RobbeElsermans/SSR/Portfolio/SSR_Portfolio/Pages/Sensor/LTR-329.md

```C
 
```
![[Lite-On_LTR-329ALS-01 DS_ver1.1-348647.pdf]]
![Brain_main_code_diagram](../../Images/diagrams/Brain_main_code_diagram.png

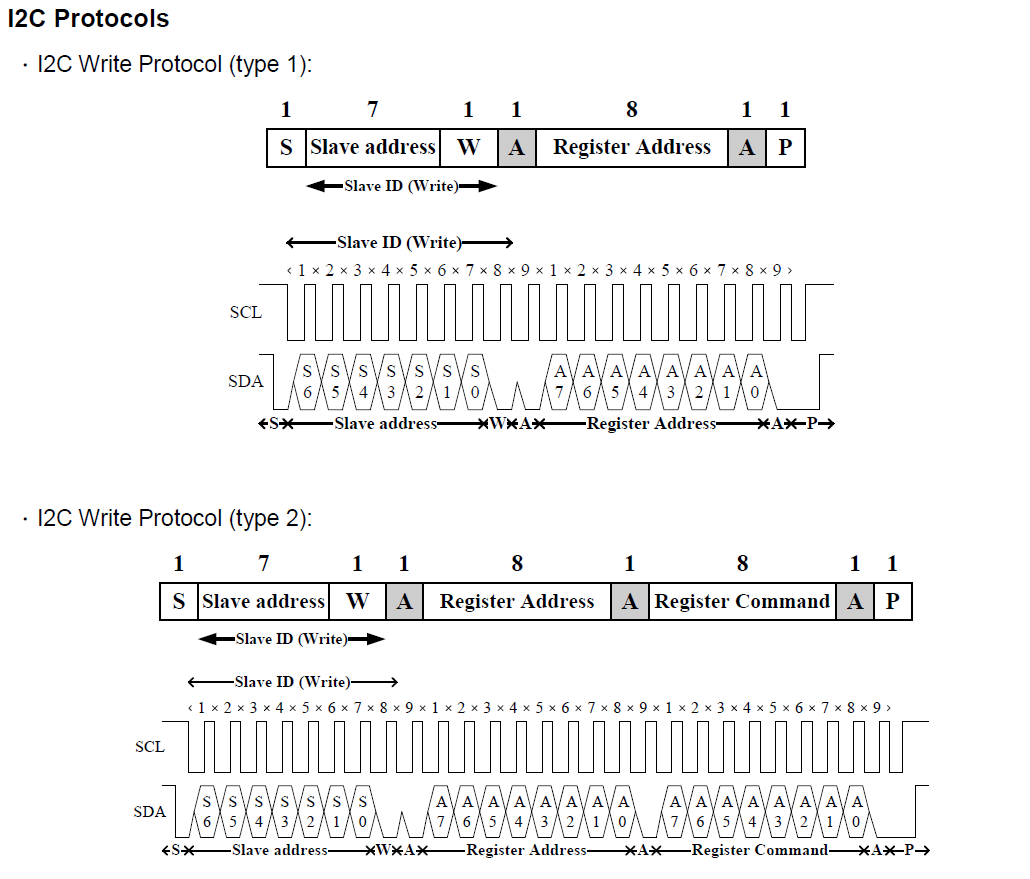
[picture p2: Portfolio/SSR_Portfolio/Images/Sensors/I2CPROTOCOL1.png]
I2CPROTOCOL1

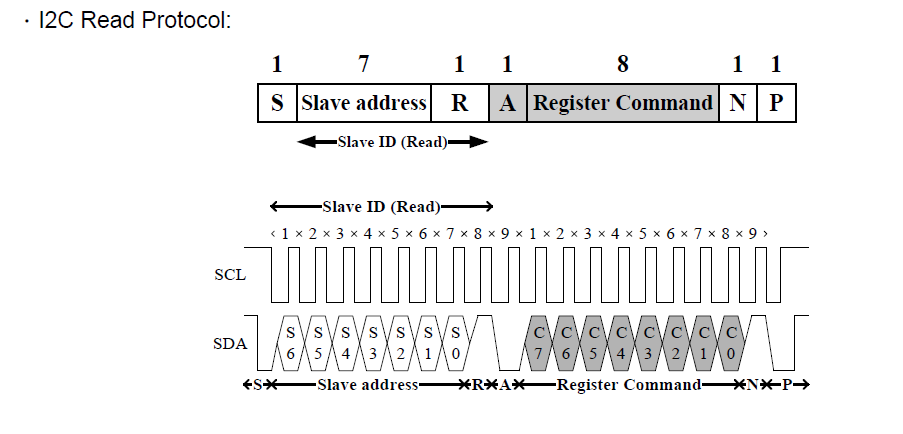
[picture p3: Portfolio/SSR_Portfolio/Images/Sensors/I2CEADPROTOCOL.png]
I2CEADPROTOCOL

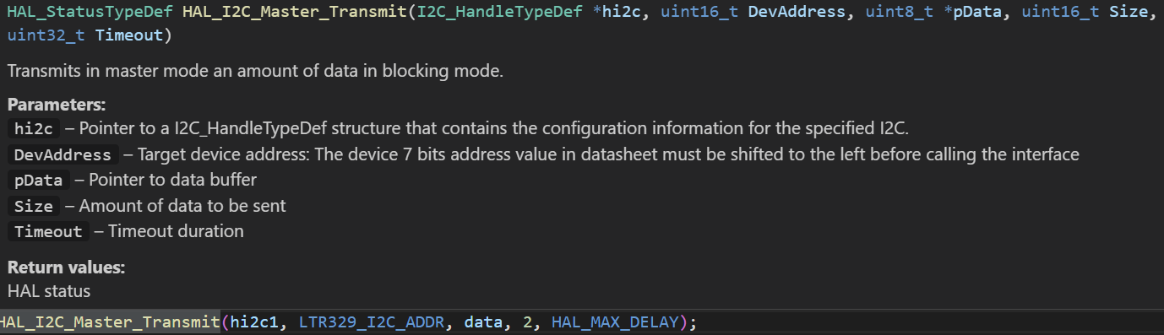
[picture p4: Portfolio/SSR_Portfolio/Images/Sensors/MasterTransmit.png]
MasterTransmit

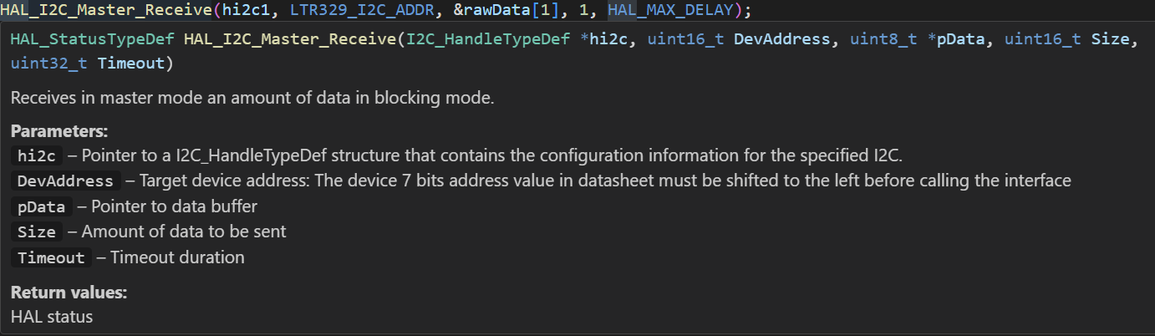
[picture p5: Portfolio/SSR_Portfolio/Images/Sensors/MasterRecive.png]
MasterRecive

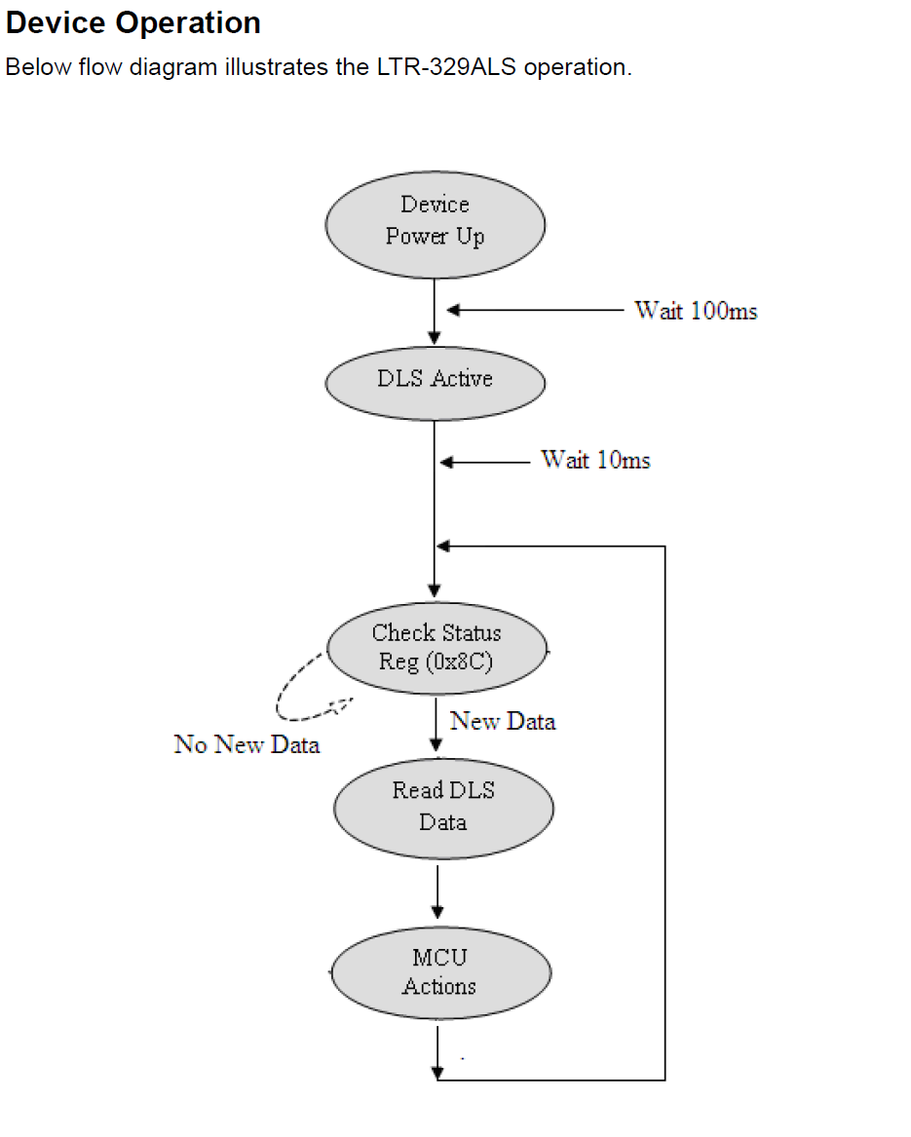
[picture p6: Portfolio/SSR_Portfolio/Images/Sensors/DEVICEOPERATION.png]
DEVICEOPERATION


Sleepmode:
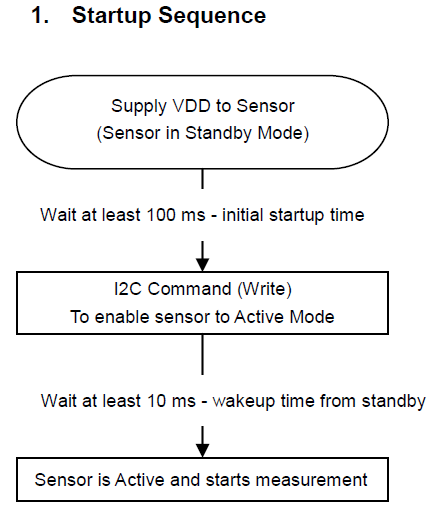
[picture p7: Portfolio/SSR_Portfolio/Images/Sensors/Startupsequence1.png]
Startupsequence1


### . **How It Works**

1. **Active State**:
    
    - The sensor reads ambient light data and transmits it via I2C
    - The LED (`LD3_Pin`) is turned on to indicate the active state.
2. **Sleep State**:
    
    - The `LTR329_Sleep` function puts the sensor into standby mode.
    - The LED is turned off to indicate the sleep state.
    - The system waits for 5 seconds (or your preferred duration).
3. **Wake-Up State**:
    
    - The `LTR329_WakeUp` function sets the sensor back to active mode.
    - A delay is added after wake-up to allow the sensor to stabilize before the next reading.

according to datasheet: 
standby current: 5 $micro$A
initial startup: 100 ms
waking up: 10 ms 

```C
while (1)

  {

    HAL_GPIO_WritePin(LD3_GPIO_Port, LD3_Pin, GPIO_PIN_SET);

    HAL_Delay(1000);

    HAL_GPIO_WritePin(LD3_GPIO_Port, LD3_Pin, GPIO_PIN_RESET);

    char Buffer[25] = {0};

    sprintf(Buffer, "Lux: ! %d\r\n", GetLuxAll(&hi2c1));

    HAL_UART_Transmit(&huart2, Buffer, sizeof(Buffer), HAL_MAX_DELAY);

    HAL_Delay(500); // Delay for the next measurement

    HAL_GPIO_WritePin(LD3_GPIO_Port, LD3_Pin, GPIO_PIN_RESET); // LED off (indicate sleep)

    LTR329_Sleep(&hi2c1);

    LTR329_Sleep(&hi2c1);

     // Delay to keep the sensor in sleep mode

    HAL_Delay(5000); // Sleep for 5 seconds

    // Wake up the sensor

    HAL_GPIO_WritePin(LD3_GPIO_Port, LD3_Pin, GPIO_PIN_SET); // LED on (indicate wake-up)

    LTR329_WakeUp(&hi2c1);

     // Wait for sensor stabilization after wake-up

    HAL_Delay(200); // Adjust based on sensor's requirements

  }

}
```

```C
void LTR329_Sleep(I2C_HandleTypeDef* hi2c1) {

    uint8_t data[2];

    // Write to ALS_CONTR register to set the sensor in standby mode (0x00).

    data[0] = LTR329_ALS_CONTR;

    data[1] = 0x00; // Standby mode

    HAL_I2C_Master_Transmit(hi2c1, LTR329_I2C_ADDR, data, 2, HAL_MAX_DELAY);

    HAL_Delay(10);

}

void LTR329_WakeUp(I2C_HandleTypeDef* hi2c1) {

    uint8_t data[2];

    // Write to ALS_CONTR register to set the sensor in active mode.

    data[0] = LTR329_ALS_CONTR;

    data[1] = 0x01; // Active mode with default gain

    HAL_I2C_Master_Transmit(hi2c1, LTR329_I2C_ADDR, data, 2, HAL_MAX_DELAY);

    // Wait for the sensor to wake up.

    HAL_Delay(10); // According to the sensor datasheet

}
```
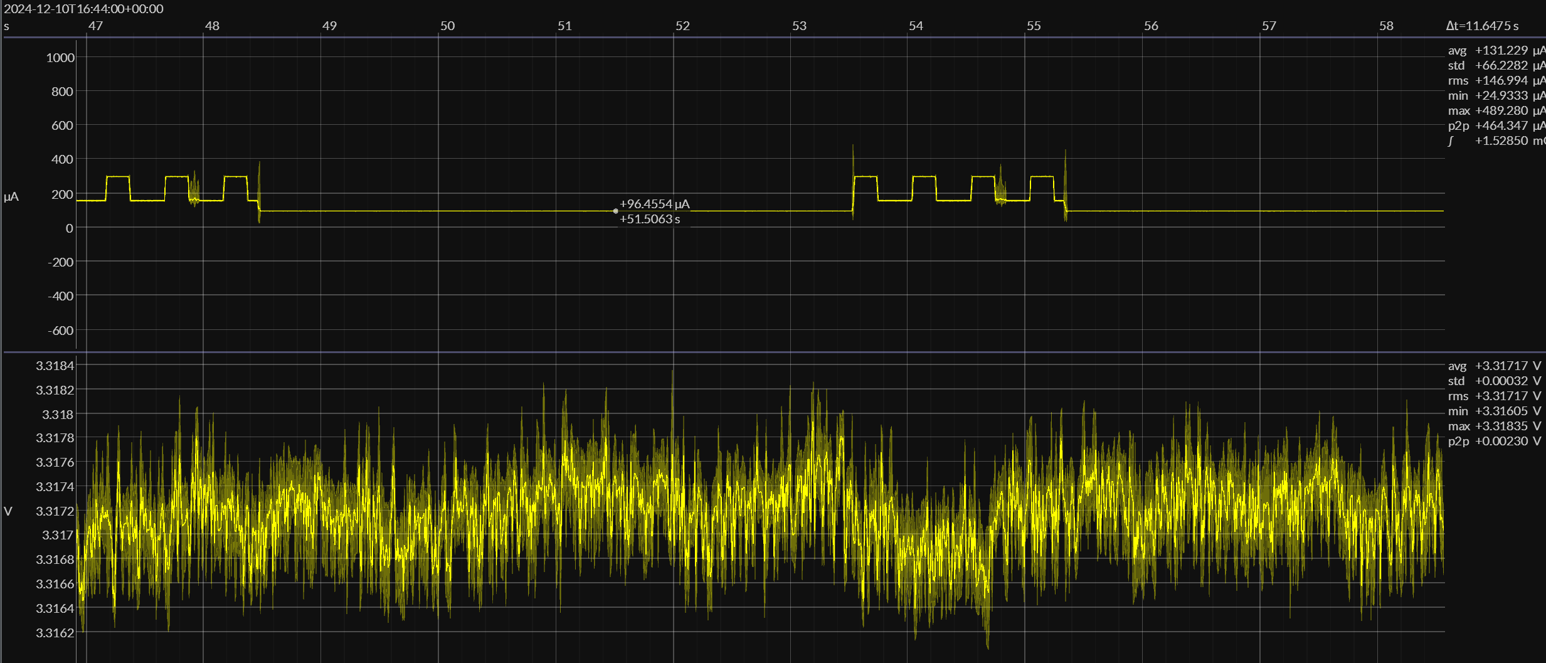
[picture p8: Portfolio/SSR_Portfolio/Images/Power_Profiling/StandbyModeLTR329.png]
Stanby Mode LTR329

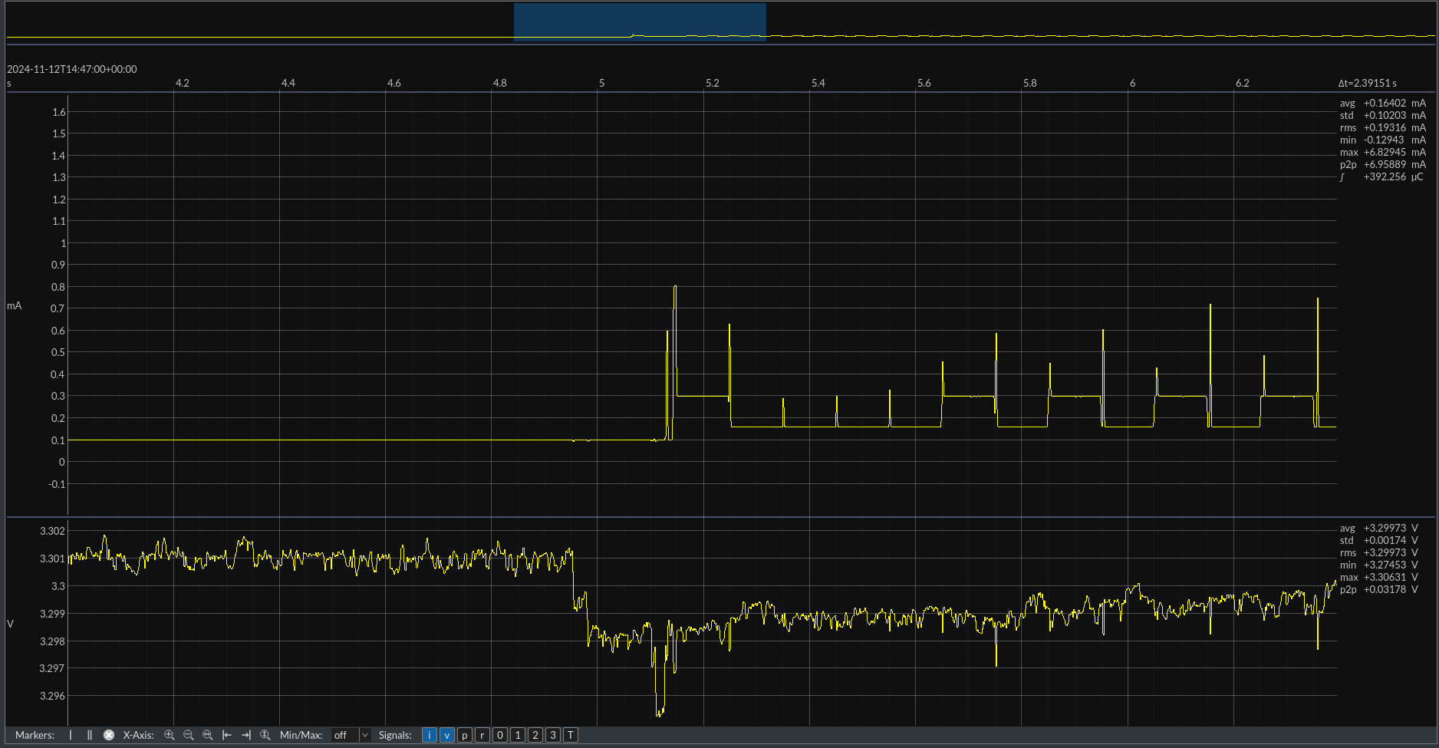
[picture p9: Portfolio/SSR_Portfolio/Images/Power_Profiling/ltr_329_consumption.png]
ltr_329_consumption


For reasons unknown Standby mode draws 96 microAmpers insted od promised 5microAmpers
Maesuring peak: 300microAmpers
SemiPeak : 157microAmpers
