RobbeElsermans/SSR/Portfolio/SSR_Portfolio/Pages/LoRa/TheThingsNetwork.md

# Account creation
Go to [TheThingsNetwork website](https://www.thethingsnetwork.org/) and click the Sign Up button:

ttn sign up

Scroll down and click the *"Join the things network"* button:

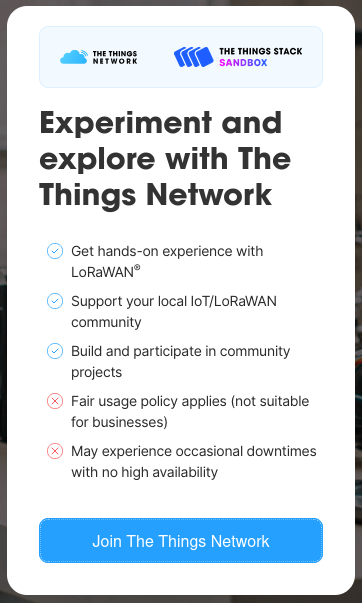
[picture p72: Portfolio/SSR_Portfolio/Images/LoRa/ttn_join.png]
ttn join up


Click the *"Sign in for free"*:

ttn sign up

Create and account:

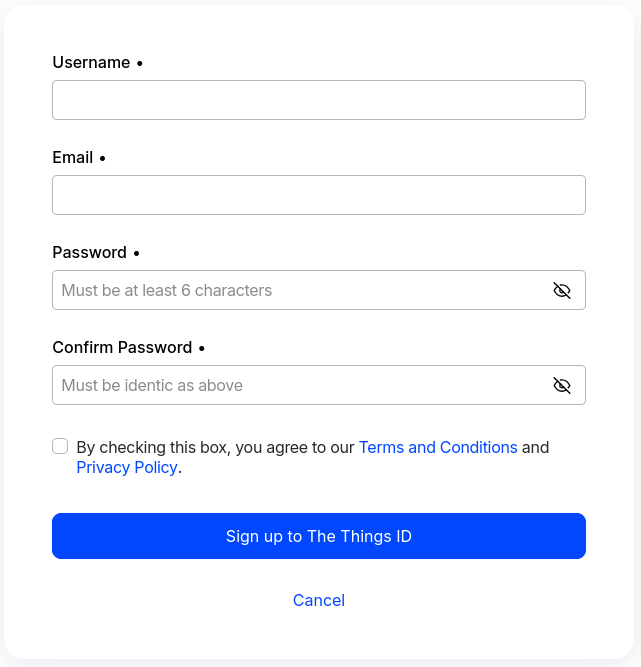
[picture p73: Portfolio/SSR_Portfolio/Images/LoRa/ttn_create_account.png]
ttn create account


After creating and verifying your account, log in:

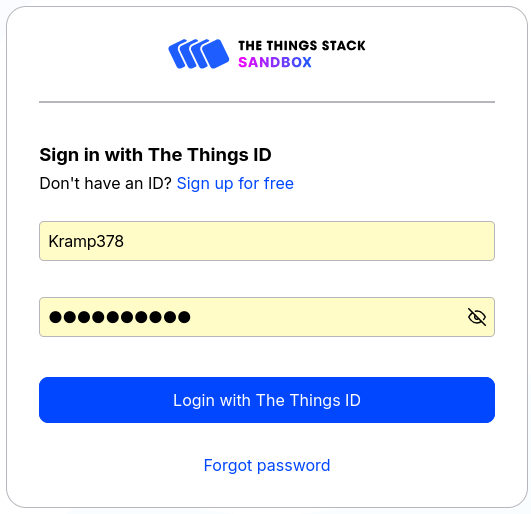
[picture p74: Portfolio/SSR_Portfolio/Images/LoRa/ttn_login.png]
ttn login


# Open the console
Click on the console button:

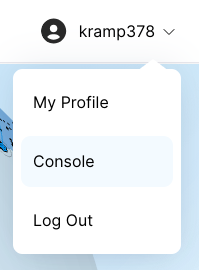
[picture p75: Portfolio/SSR_Portfolio/Images/LoRa/ttn_console.png]
ttn console


Select the closest cluster available *(Ireland)*:

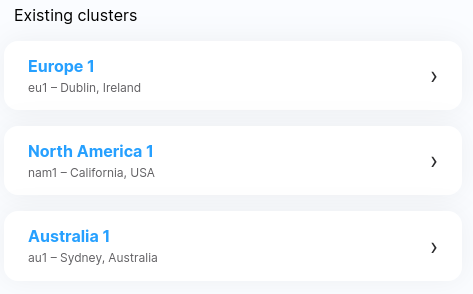
[picture p76: Portfolio/SSR_Portfolio/Images/LoRa/ttn_cluster.png]
ttn cluster


You should see the following interface:

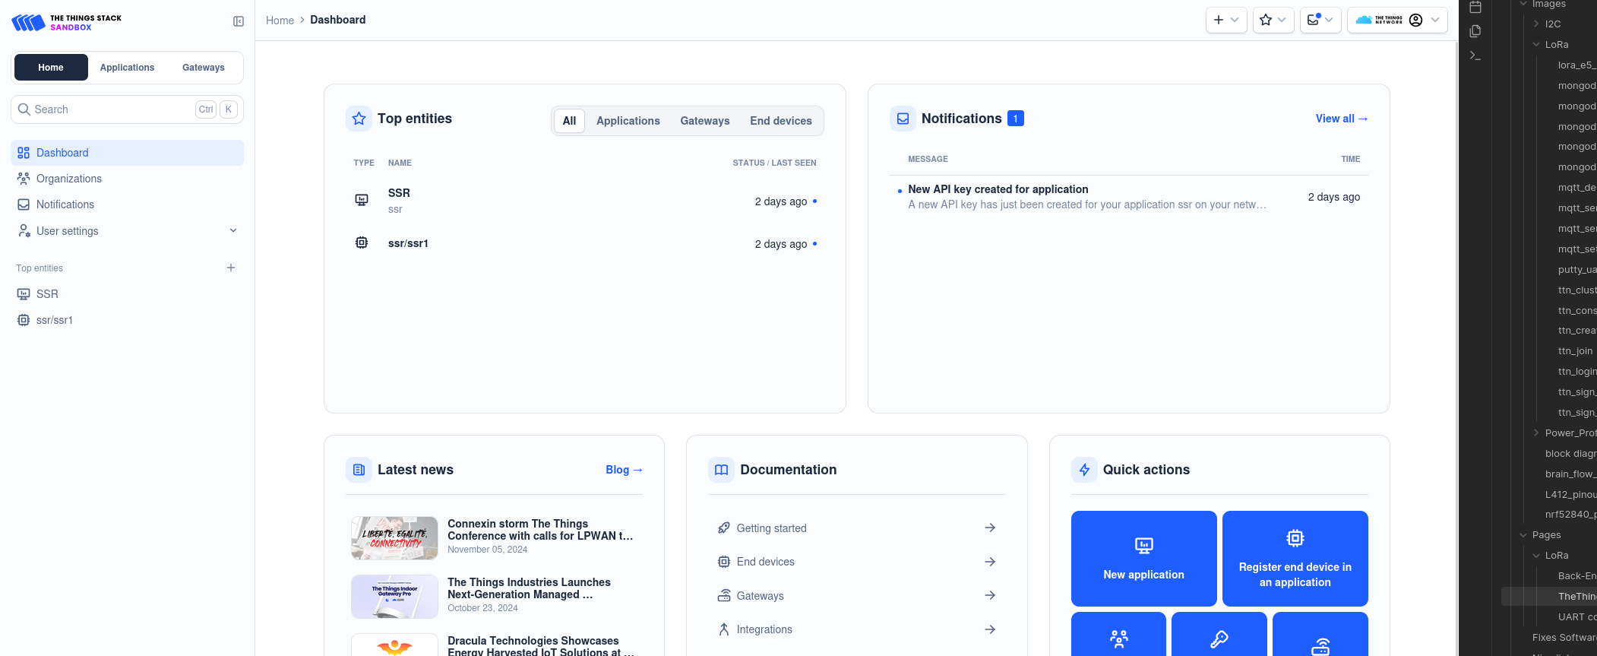
[picture p77: Portfolio/SSR_Portfolio/Images/LoRa/ttn_console_interface.png]
ttn console interface


# Connect device
## Create an application
Hover over the plus sign and click on ""Add application":

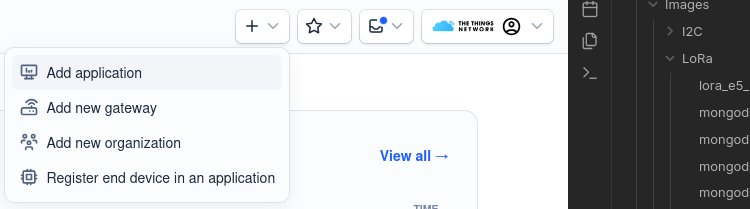
[picture p78: Portfolio/SSR_Portfolio/Images/LoRa/ttn_create_application.png]
ttn create application


Use the following settings to create an application:

ttn application settings

## Add a device
Under the "End devices" tab, click op the "Register end device" button:

ttn register device

Use the following settings to register an end device:
- DevEUI should be provided by the device. Use the device value.
- Device address, AppSKey & NwkSKey should be generated and then configured onto the end device.

ttn end device type

ttn advanced activation settings

ttn provisioning information

### Create a MQTT network connection
Click on the left, onto the "Intigrations" tab and afterwards on the "MQTT" sub-tab.
The following settings can be used to subscribe onto MQTT messages of this end device.
*Note that the password needs to be generated.*

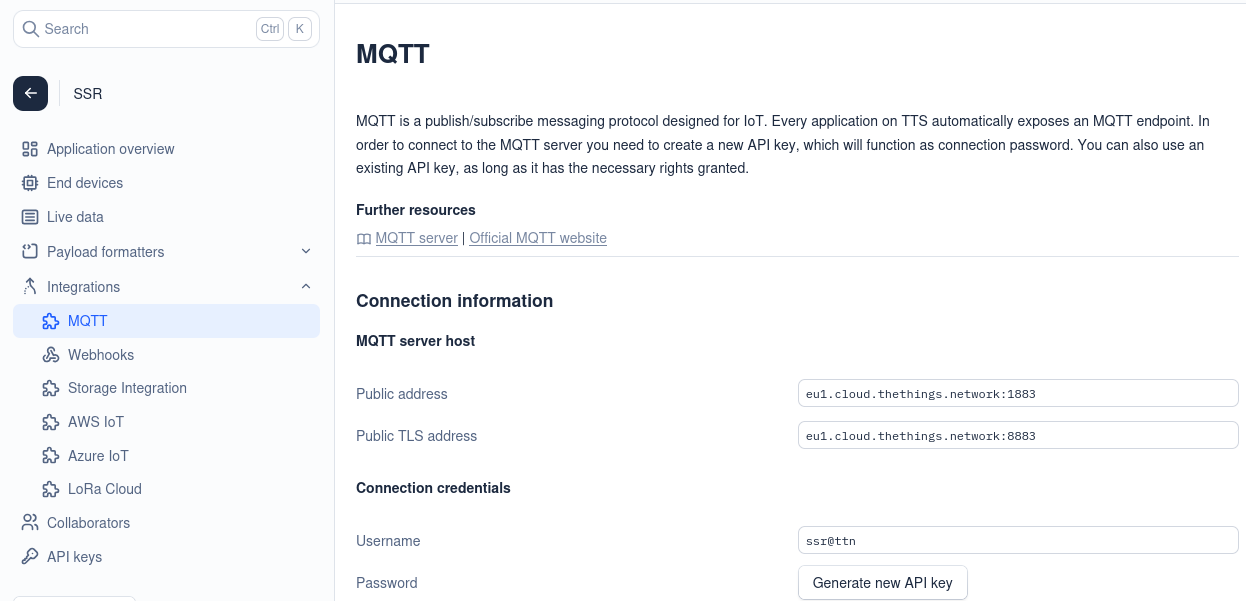
[picture p79: Portfolio/SSR_Portfolio/Images/LoRa/ttn_mqtt_network_settings.png]
ttn mqtt network settings
