RobbeElsermans/SSR/STM32/README_VENV.md

Please, in order to convert a generated .ioc file of STM32, use the virtual environment by

```
pwd = /SSR/STM32
source /venv/bin/activate
```

```
pip install stm2pio
python3 -m pip install -U platformio
```
use **stm32pio init** to generate the platformio project from an .ioc file generated by CubeMX.
```
stm32pio init
```
add the device name in the .ini file e.i. **nucleo_l412kb**
```
stm32pio generate
```
Please note that teh error about GPDSC, doesn't matter
See -> https://github.com/ussserrr/stm32pio/issues/114

In order to regenerate the changed .ioc through cubeMX and link it to platformio
For this, the inline commentary may not be changed.
```
stm32pio generate
```

and to deactivate the env
```
deactivate
```

For advanced stuff like MiddleWare applications such as FreeRTOS or any other thing, not done yet.
See below for further investigation
- https://wiki-power.com/en/PlatformIO%E6%90%AD%E9%85%8DCubeMX%E9%A3%9F%E7%94%A8/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 
- https://community.platformio.org/t/stm32cubemx-and-platformio/38378/3
- https://community.platformio.org/t/minimal-ststm32-freertos-example/37229/3
- https://github.com/platformio/platform-ststm32/tree/master/examples/zephyr-blink/zephyr
- 

sources:
- https://python.land/virtual-environments/virtualenv
- https://github.com/ussserrr/stm32pio
- https://github.com/maxgerhardt/pio-stm32h7-stm32cube-freertos
- https://community.platformio.org/t/platformio-freertos/23554/6
