RobbeElsermans/SSR/Portfolio/PPT/SSR_Final.pdf

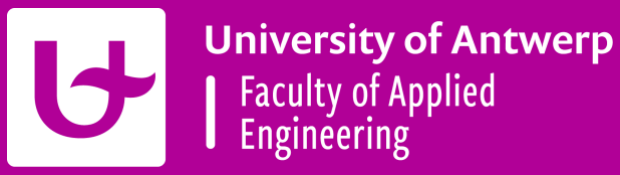
[picture p84: figure]

# Simple Stupid Rover

## Robbe Elsermans, Adam Hejduk, Thomas Kramp

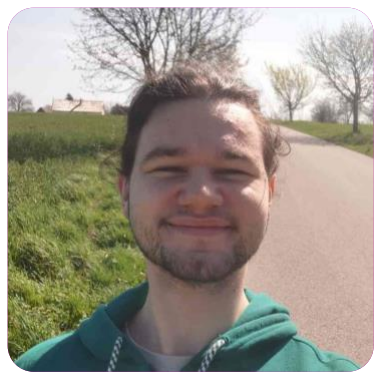
[picture p85: figure]
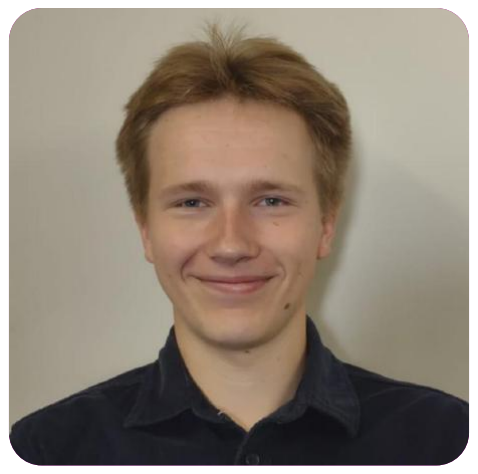
[picture p86: figure]
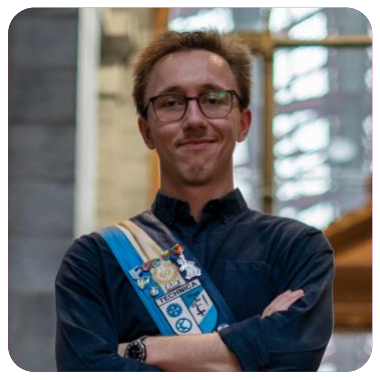
[picture p87: figure]

Adam Hejduk | Robbe Elsermans | Thomas Kramp
- Environmental Sensing • Energy harvesting • Energy output management • Soldering man | • Project Manager • Energy Awareness • BLE intercommunication • Power Profiling | • Gyroscope • LineBot
- LoRa
| | • Dashboard

# Concept

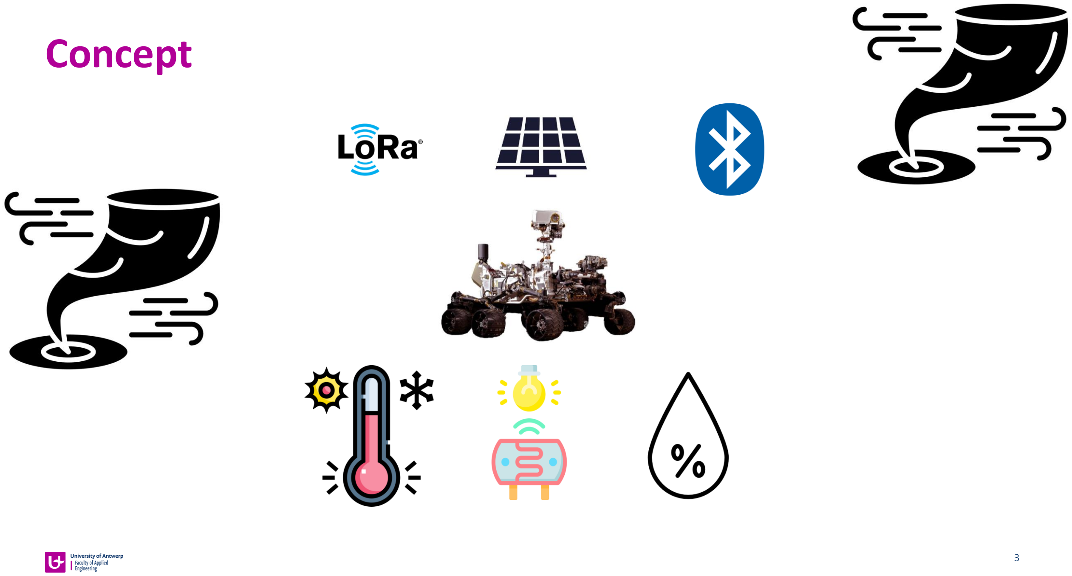
[picture p88: page 3]

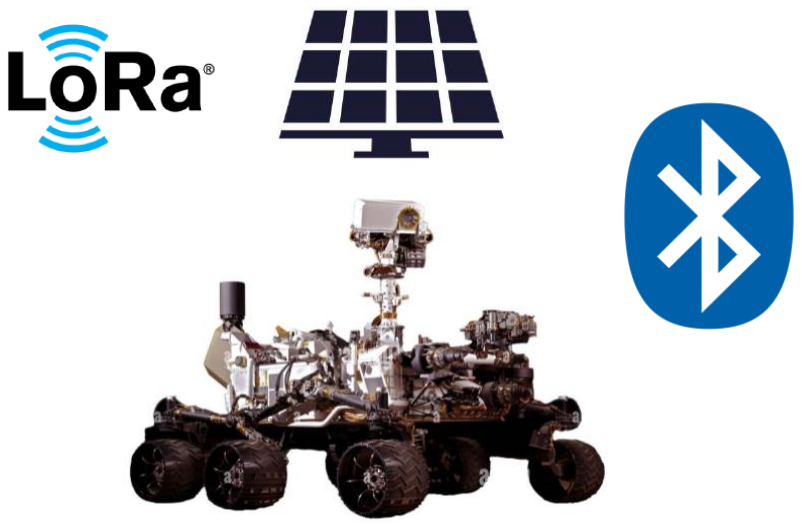
[picture p89: figure]

# Concept

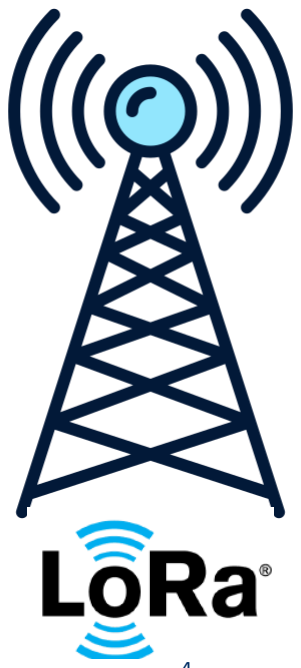
[picture p90: figure]

# Concept

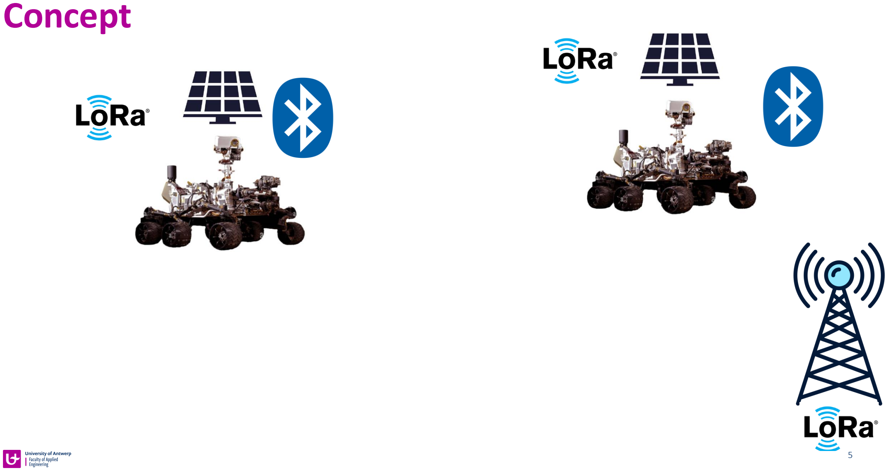
[picture p91: page 5]

# Concept

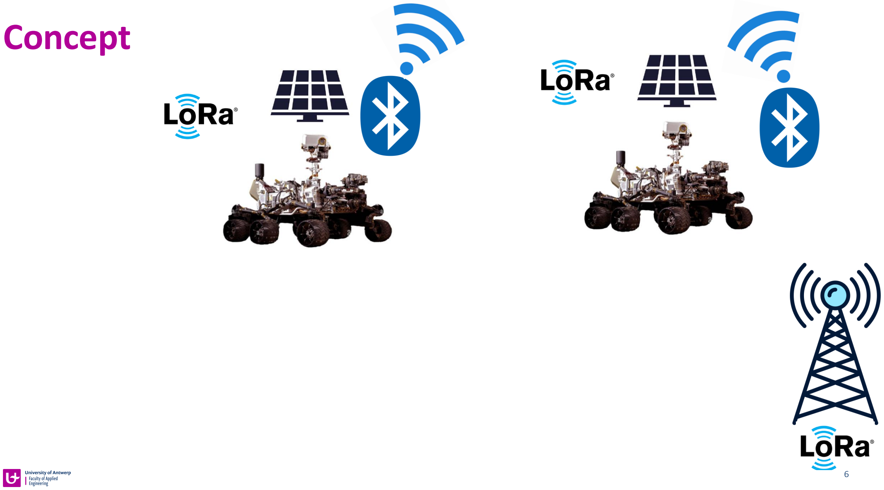
[picture p92: page 6]

# Concept

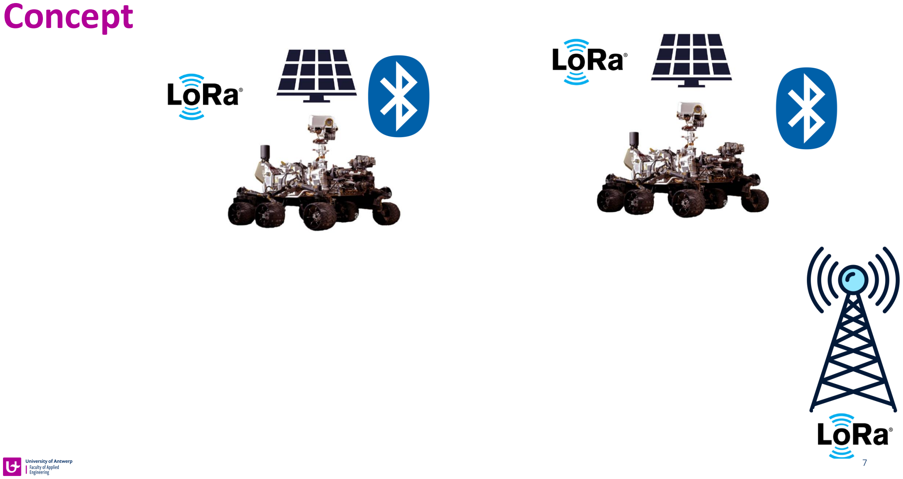
[picture p93: page 7]

# Concept

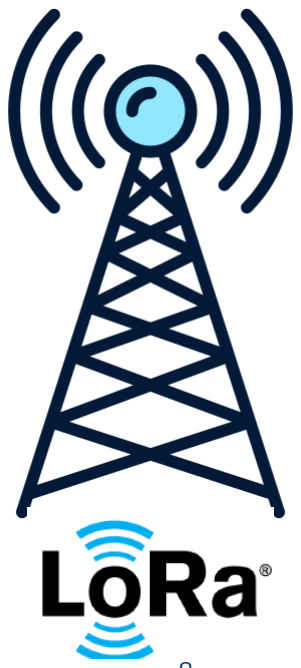
[picture p94: figure]

# System Description

# Rover system

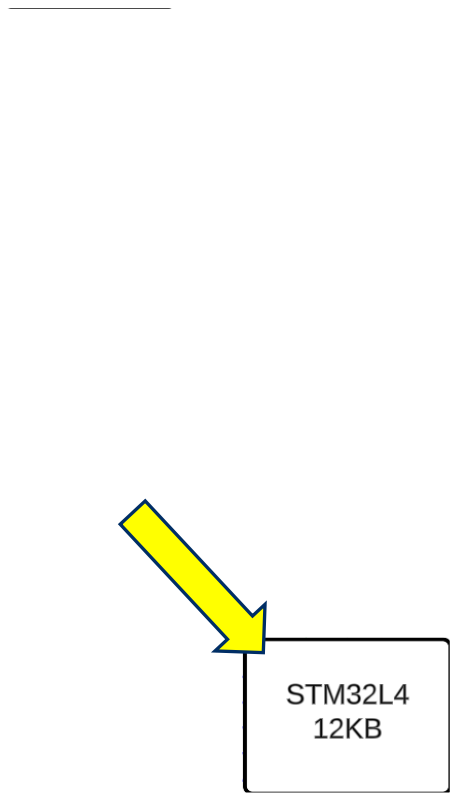
[picture p95: page 10]

# Rover system

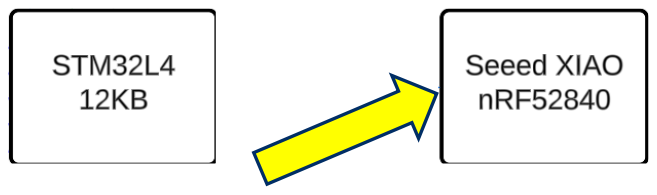
[picture p96: page 11]

# Rover system

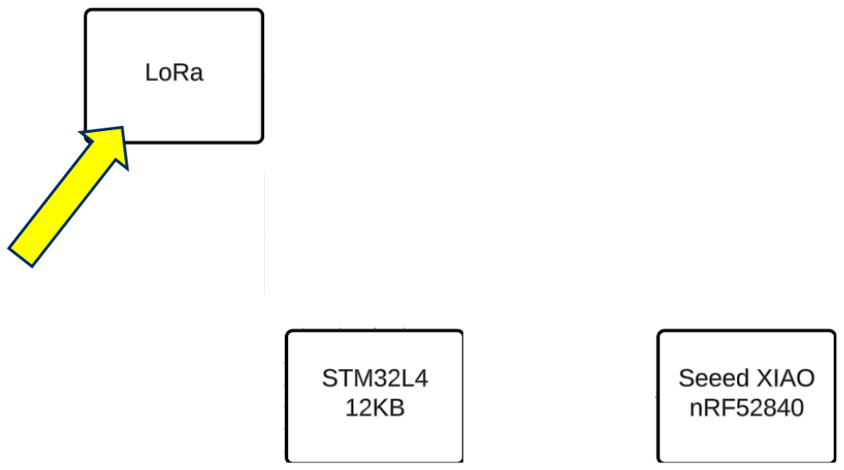
[picture p97: page 12]

# Rover system

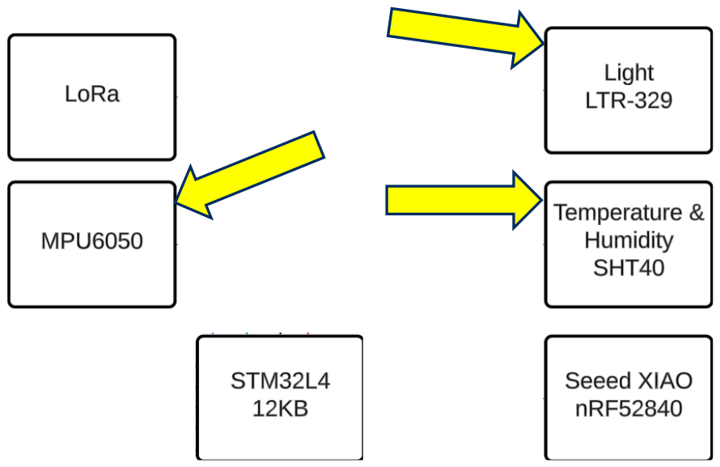
[picture p98: page 13]

# Rover system

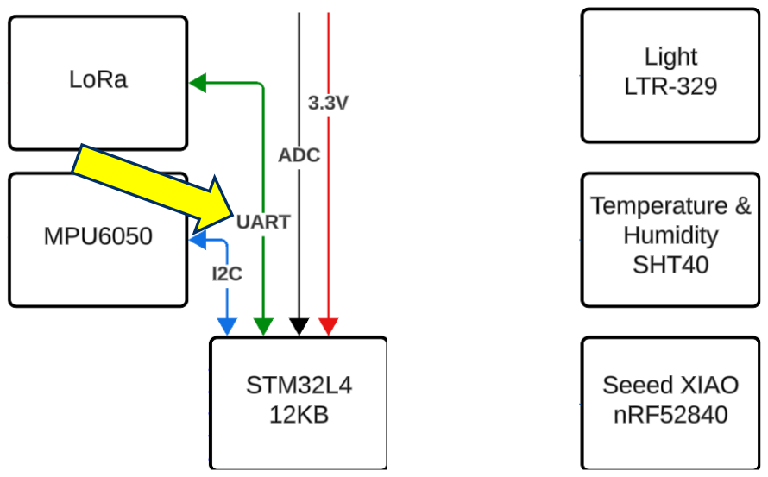
[picture p99: page 14]

# Rover system

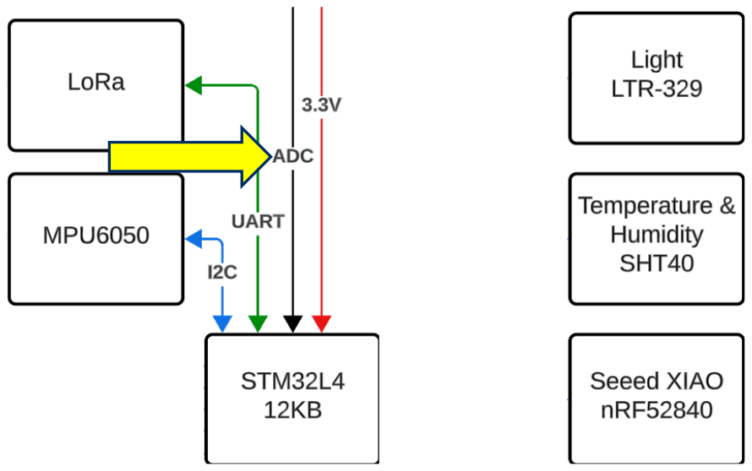
[picture p100: page 15]

# Rover system

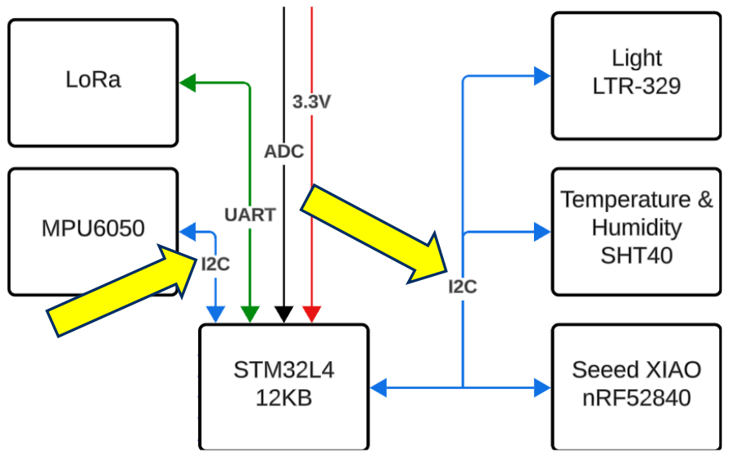
[picture p101: page 16]

# Rover system

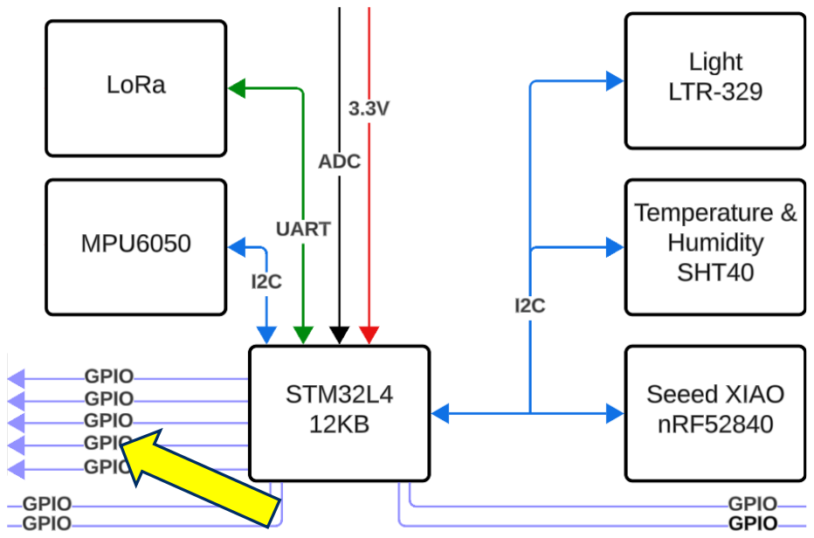
[picture p102: page 17]

# Rover system

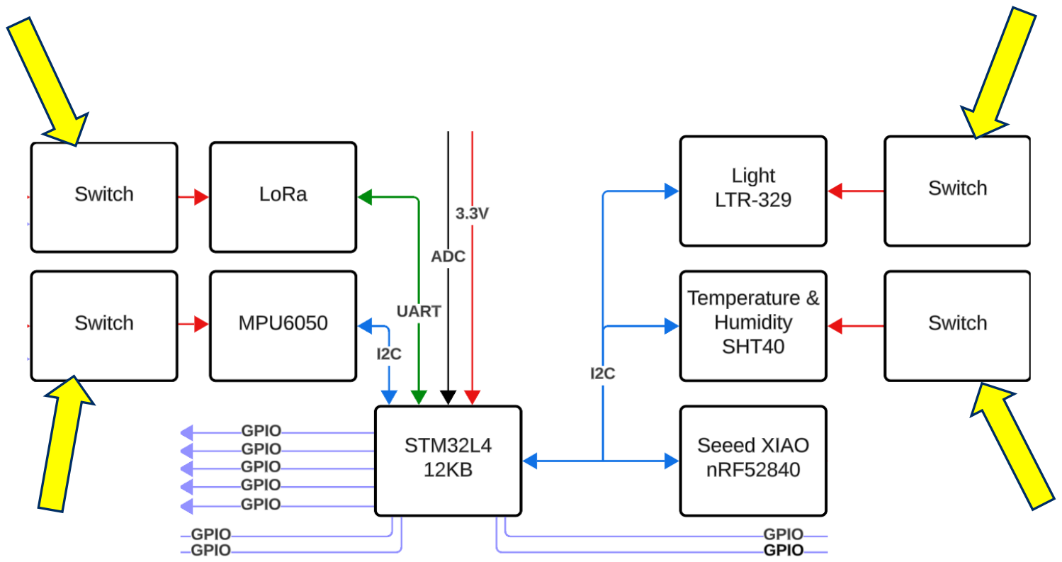
[picture p103: page 18]

# Rover system

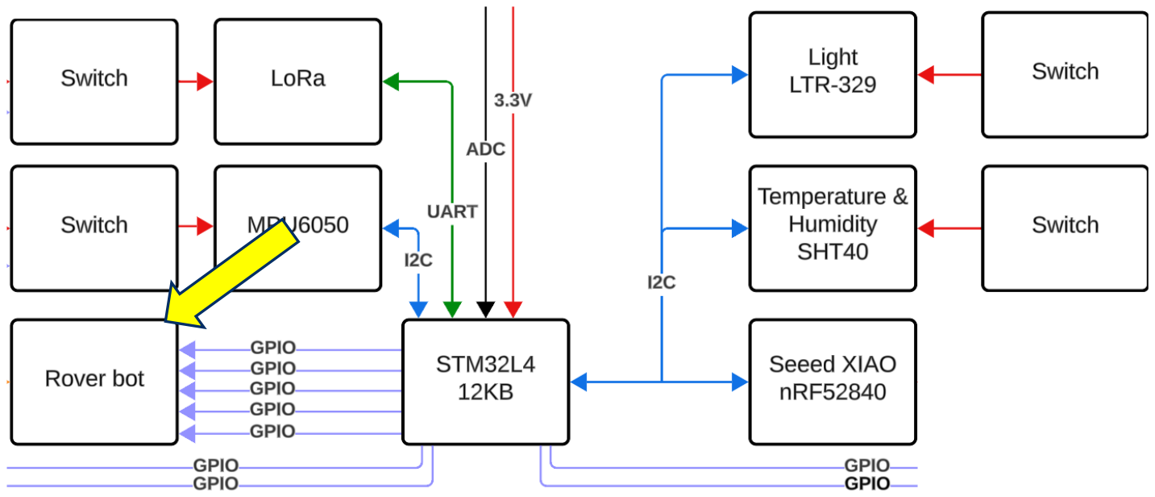
[picture p104: page 19]

# Rover system

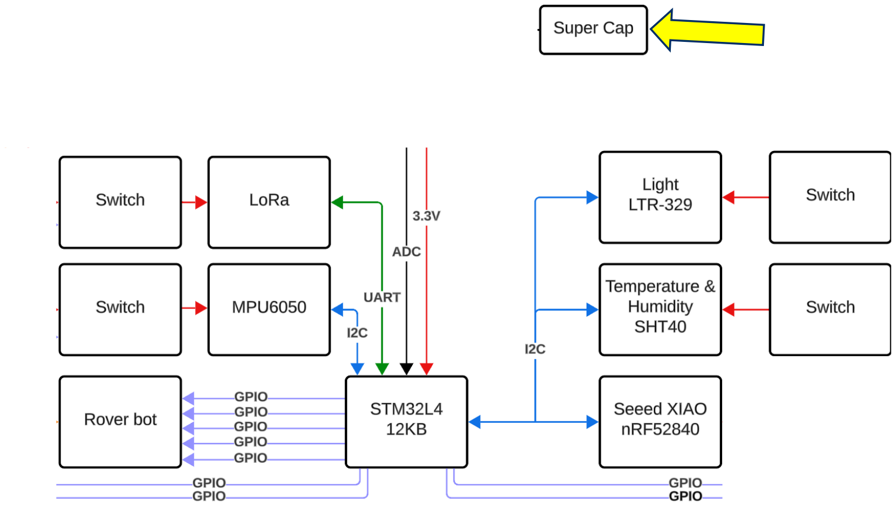
[picture p105: page 20]

# Rover system

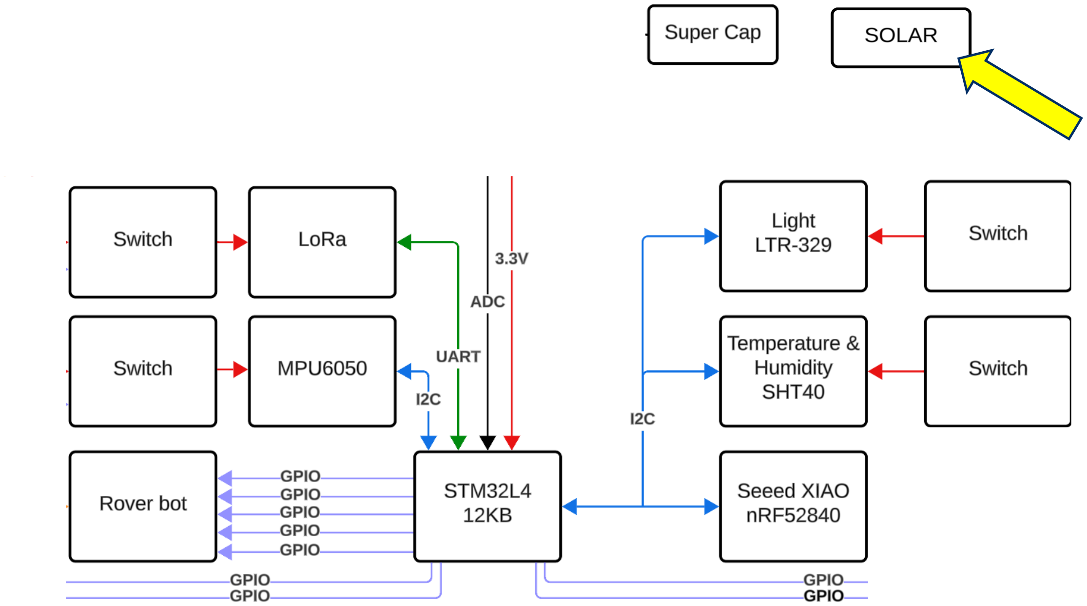
[picture p106: page 21]

# Rover system

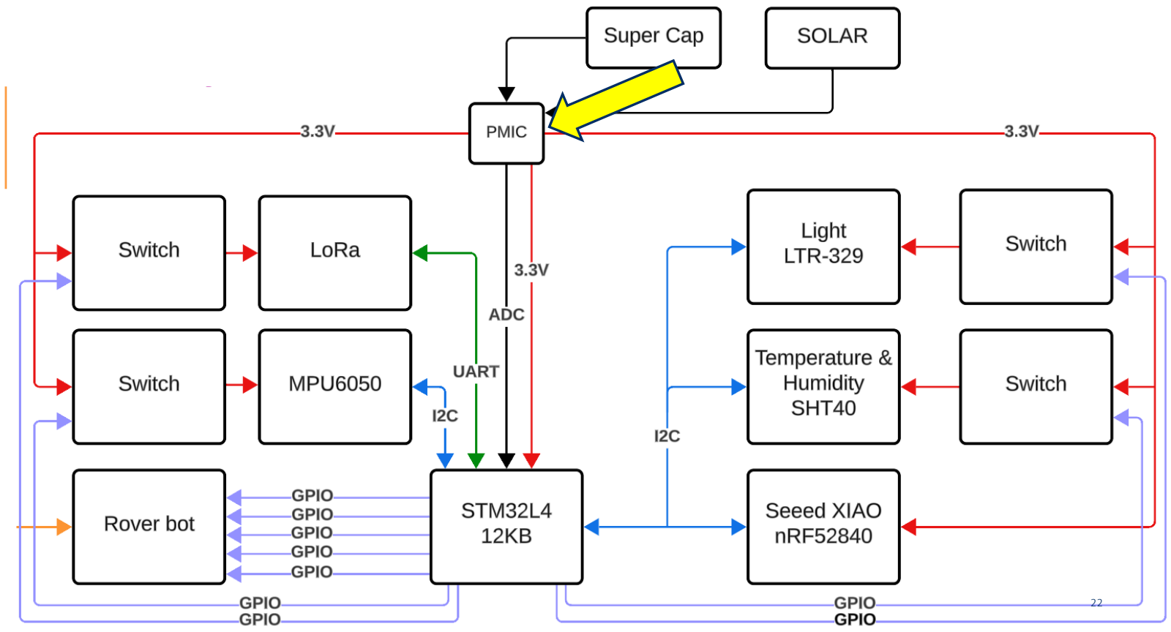
[picture p107: page 22]

# Rover system

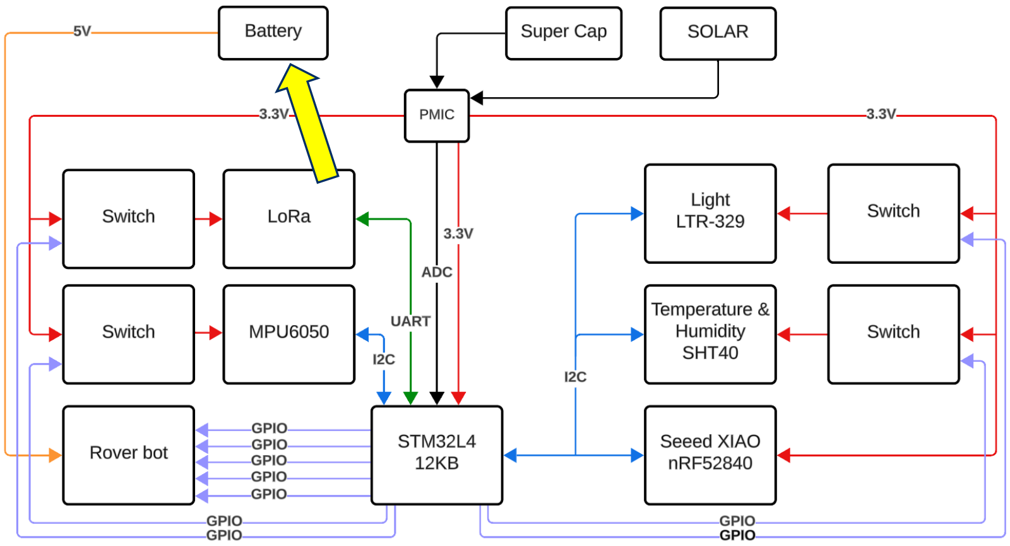
[picture p108: page 23]

# Rover system

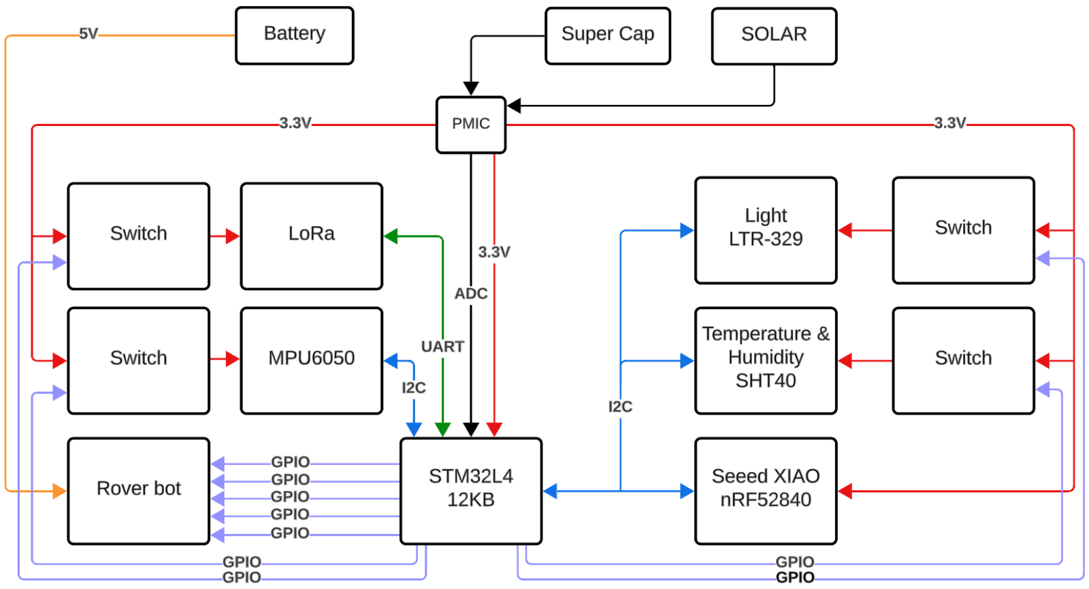
[picture p109: page 24]

# LPPAN communication

## BLE

# BLE Communication system

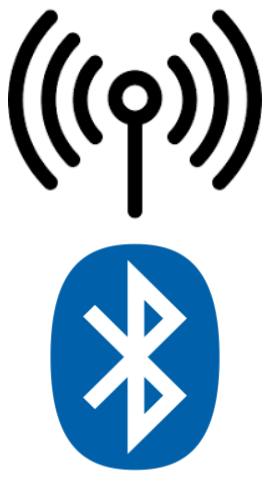
[picture p110: figure]
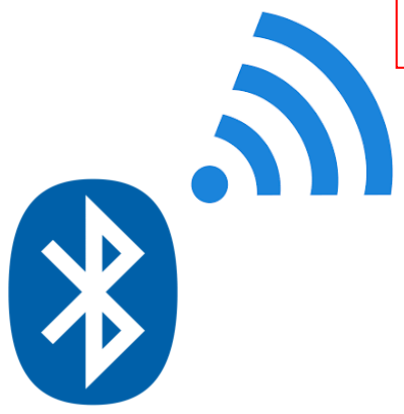
[picture p111: figure]

Beacon | Scanner

## Advertisee

# BLE Communication system

## Advertise -> IBeacon

# BLE Communication system

## Advertise -> IBeacon

# BLE Communication system

## Advertise -> IBeacon

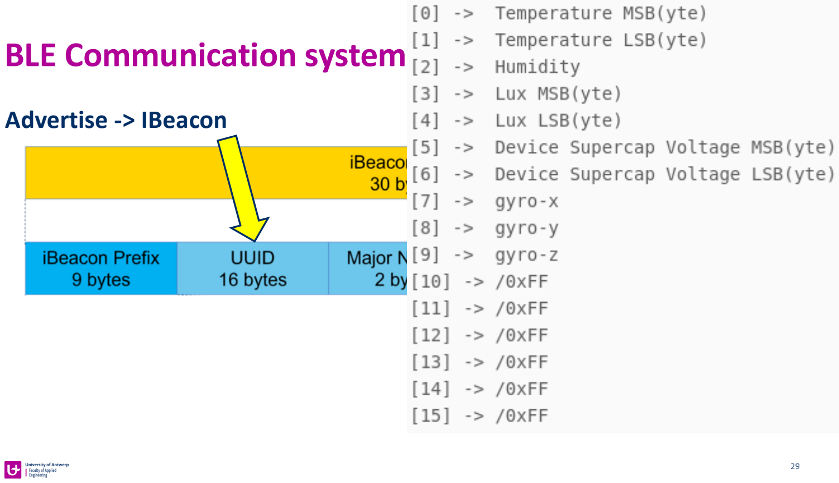
[picture p112: page 29]

# BLE Communication system

## Advertise -> IBeacon

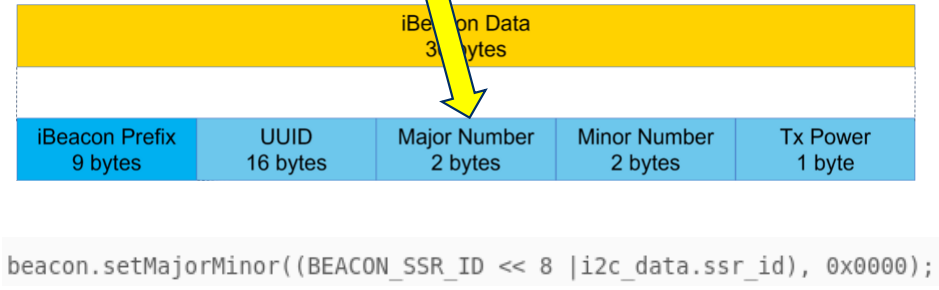
[picture p113: figure]

# BLE Communication system

## Advertise -> IBeacon

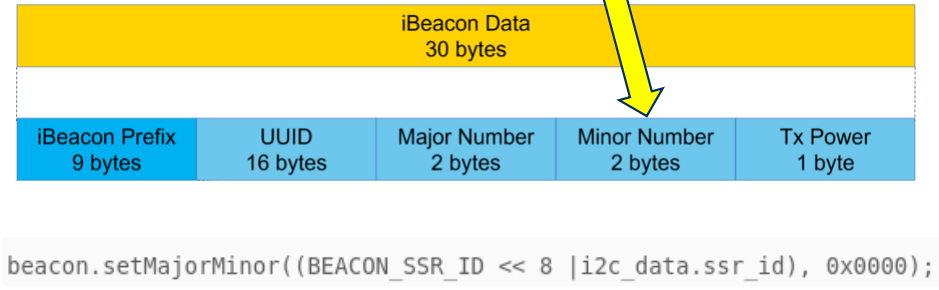
[picture p114: figure]

# BLE Communication system

## Advertise -> IBeacon

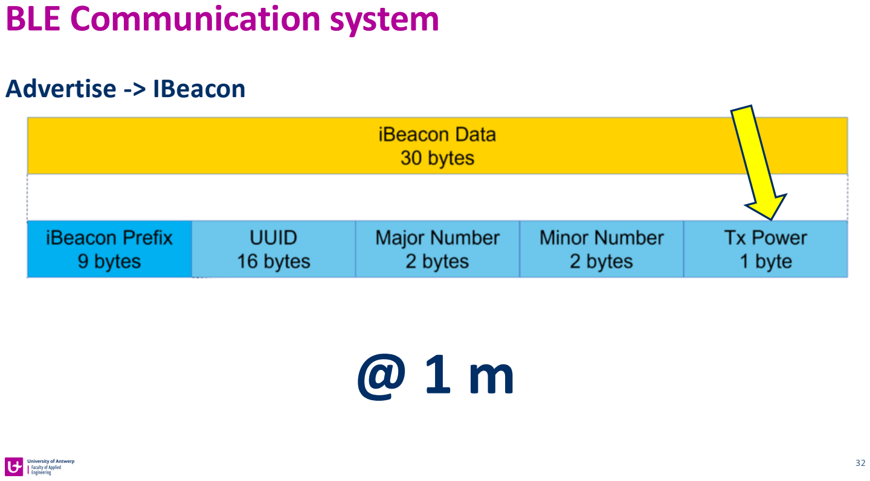
[picture p115: page 32]

@ 1 m

# Orientation

# BLE Communication system

# Optimal Transmission

# BLE Communication system

# Optimal Transmission

# BLE Communication system

# LPWAN Communication

## LoRa

# LoRa Communication system

AT-command | LoRa | MQTT

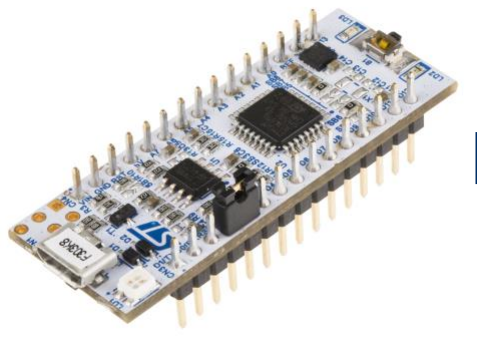
[picture p116: figure]
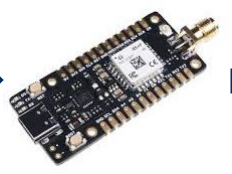
[picture p117: figure]
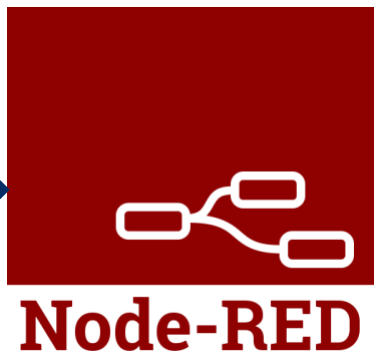
[picture p118: figure]

# Data to dashboard

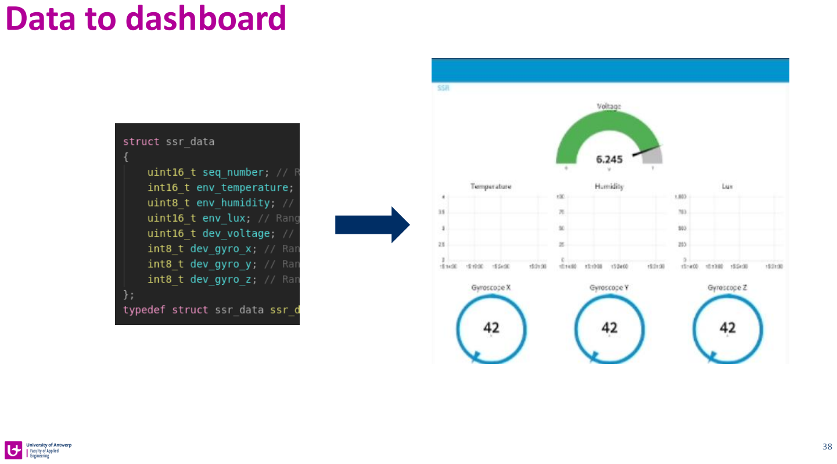
[picture p119: page 38]

# How it should have worked

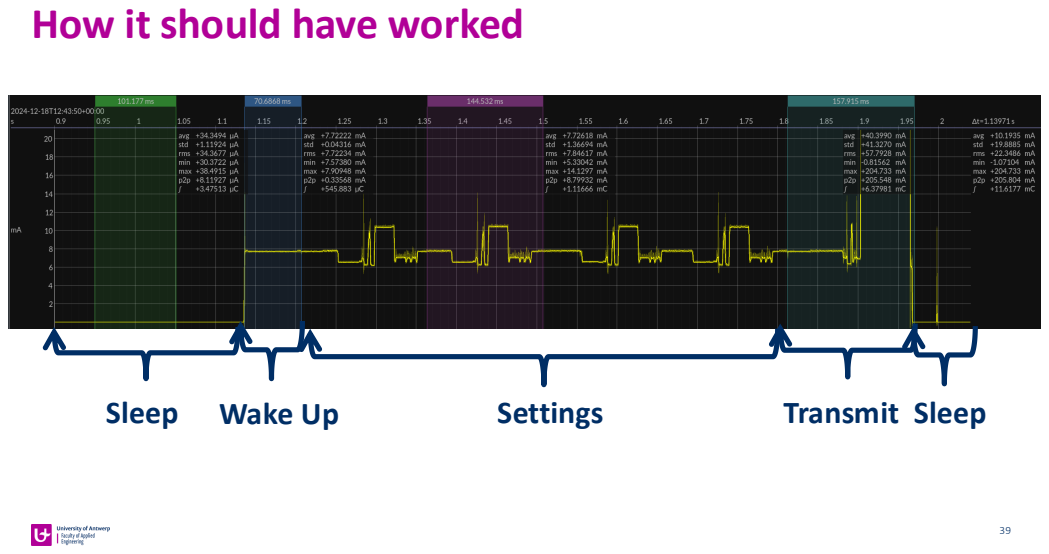
[picture p120: page 39]
Sleep; Wake Up; Settings; Transmit Sleep

# Repeated transmissions

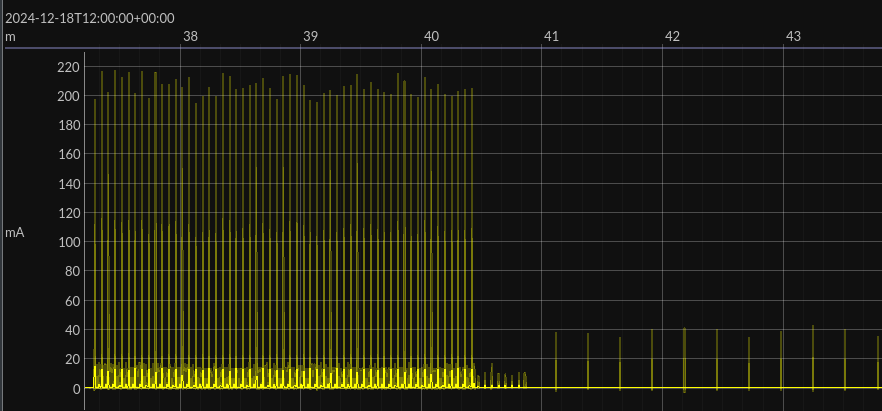
[picture p121: figure]

# Active time during sleep

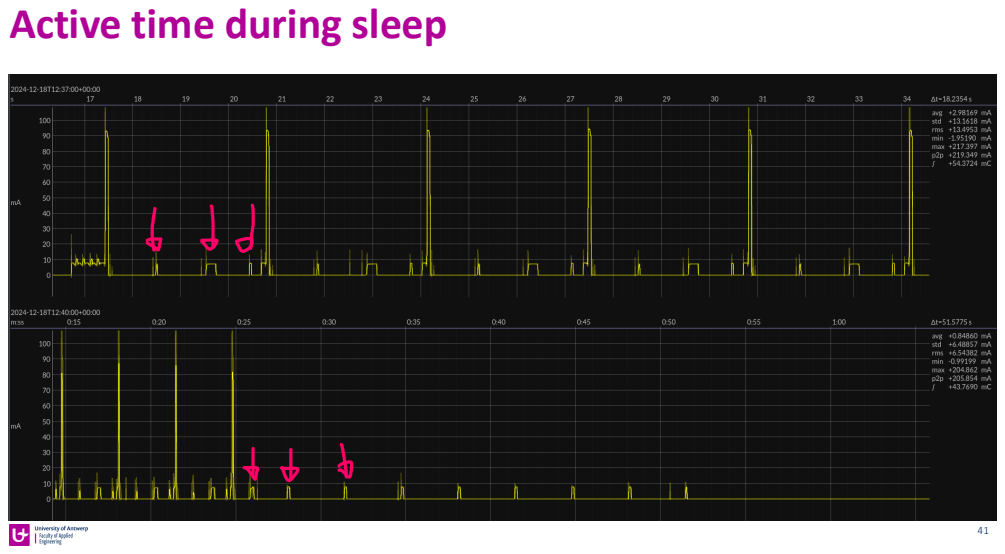
[picture p122: page 41]

# Reinitialize settings after long sleep

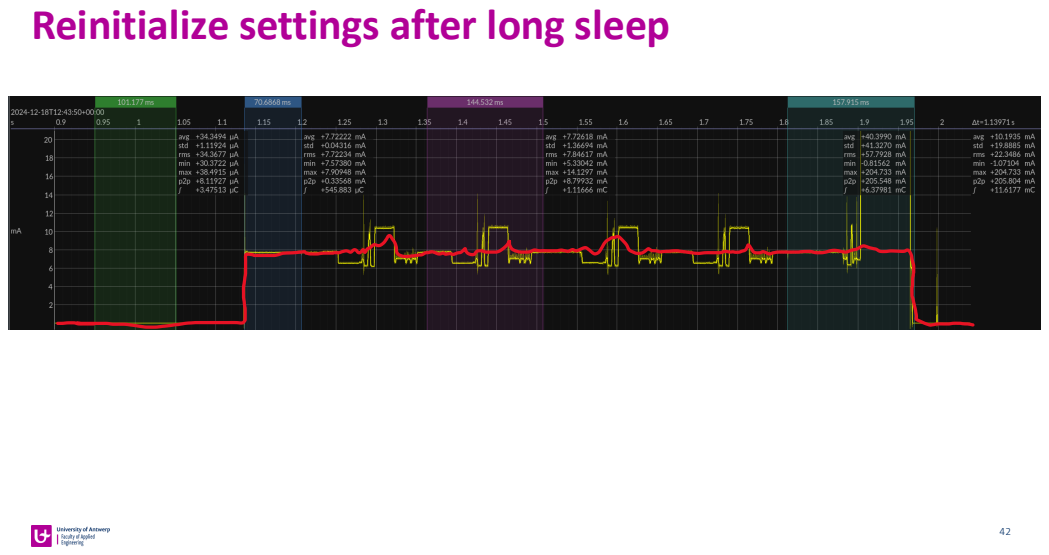
[picture p123: page 42]

# Demo

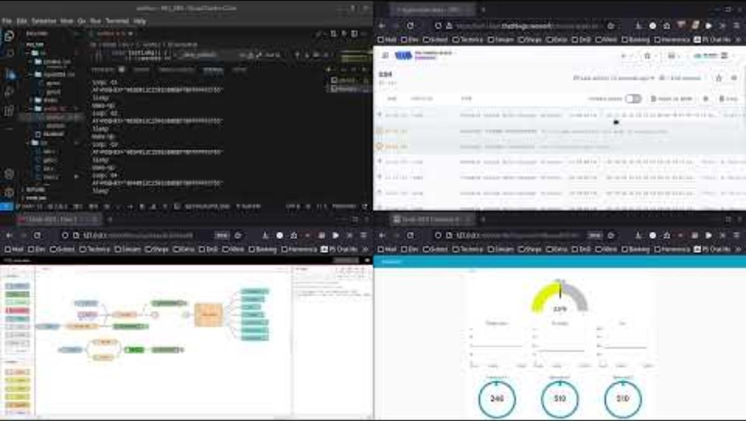
[picture p124: figure]

# Sensing

# Sensing (SHT40)

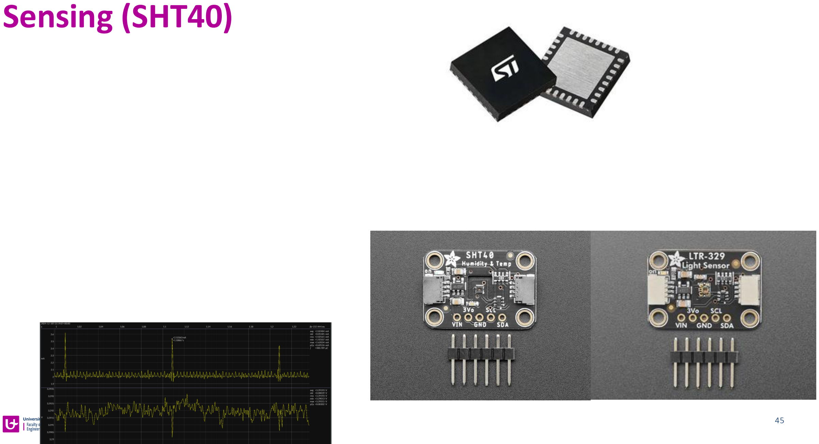
[picture p125: page 45]

# Sensing (LTR-329)

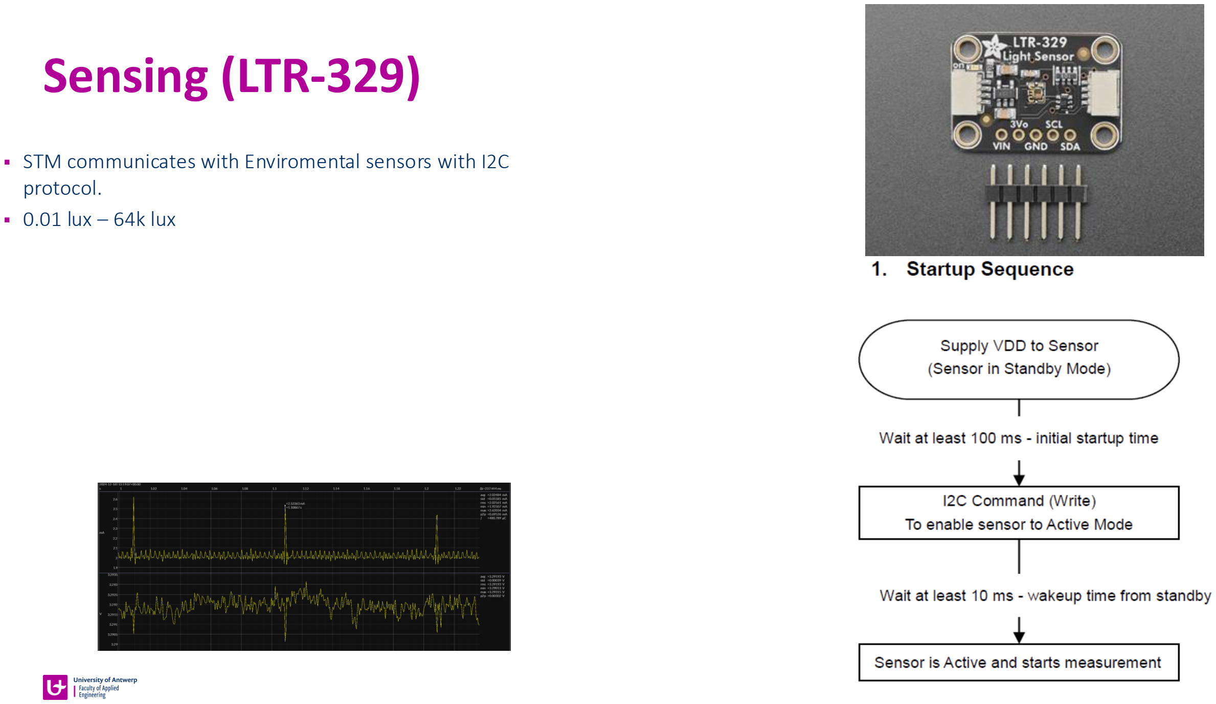
[picture p126: page 46]

- STM communicates with Enviromental sensors with I2C protocol.
- 0.01 lux – 64k lux

# Standbymode

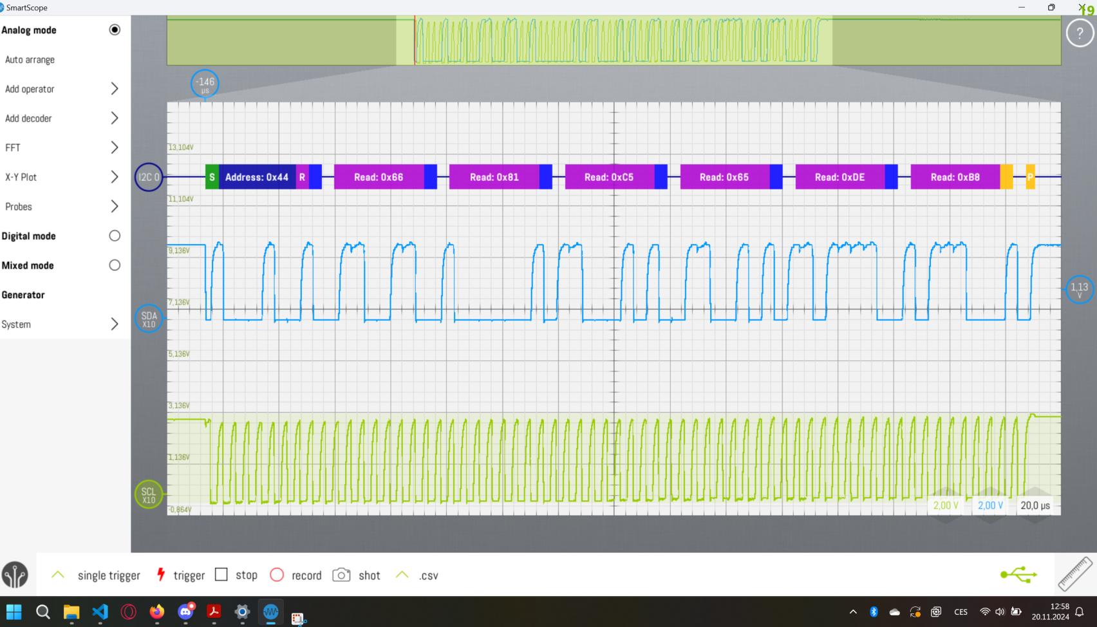
[picture p127: figure]

# Standbymode

# Standbymode

# Standbymode

# Standbymode

# Standbymode

# Sensing (PMU6050)

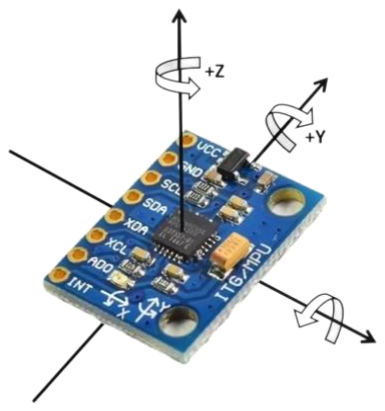
[picture p128: figure]

- STM communicates with gyroscope via I2C
- Temperature and acceleration sensors deactivated
- The gyroscope measurements are a difference measurement
- High sleep mode consumption (1.4mA)

Image from: https://user-images.githubusercontent.com/107638696/241324971-43b8fe88-447d-4c2d-9296-4b3aaa50f4ce.png

# Sensing (PMU6050)

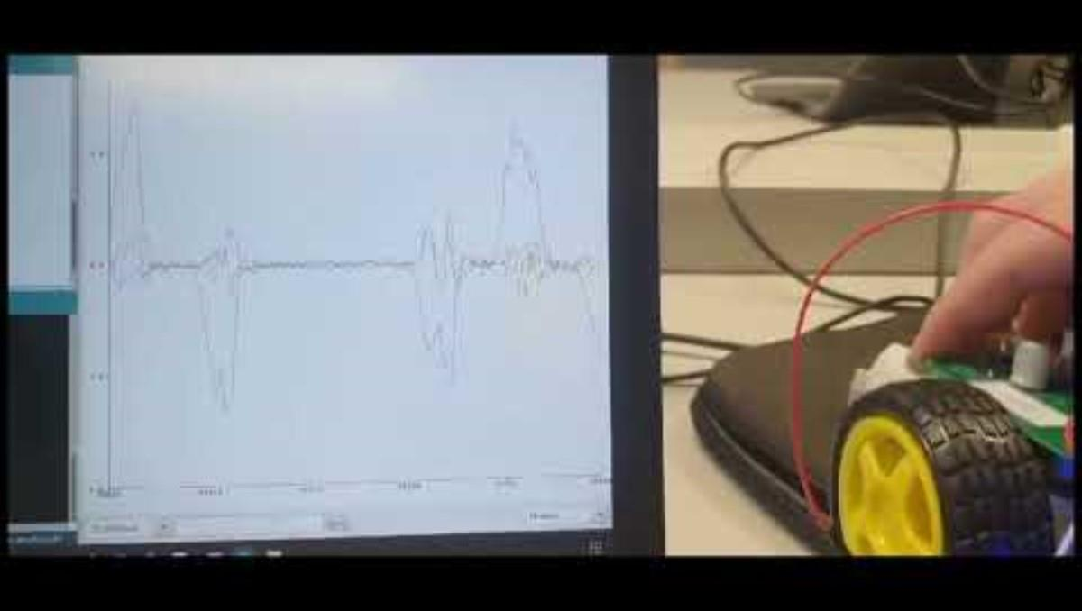
[picture p129: figure]

# Energy Harvesting

# Energy Harvesting

## - I2C _HAL_ libary

- PRogRaMinG ....

# Energy harvesting so far and expectations

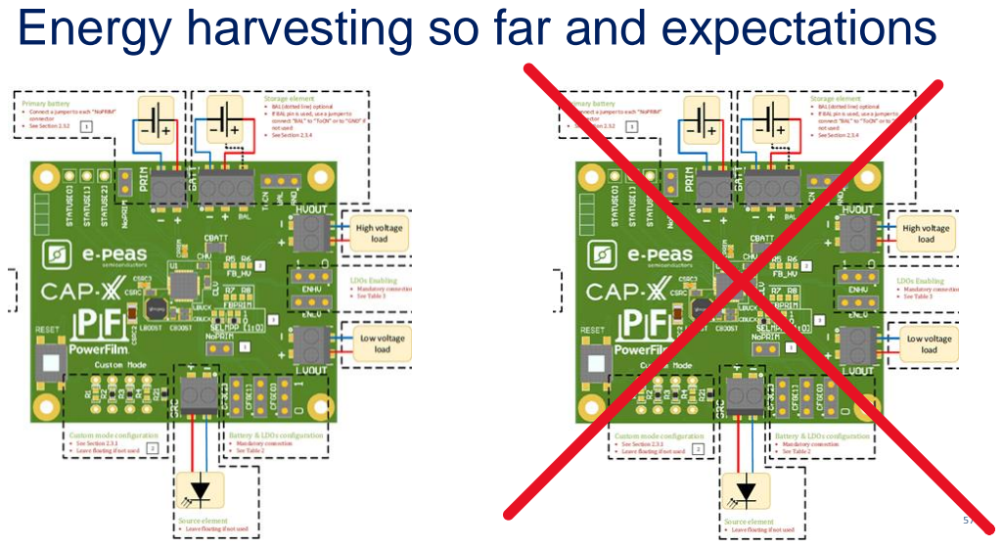
[picture p130: page 57]

# The goal

## SHT40(1.08 - 3.6)V LTR-329(2.4 - 3.6)V

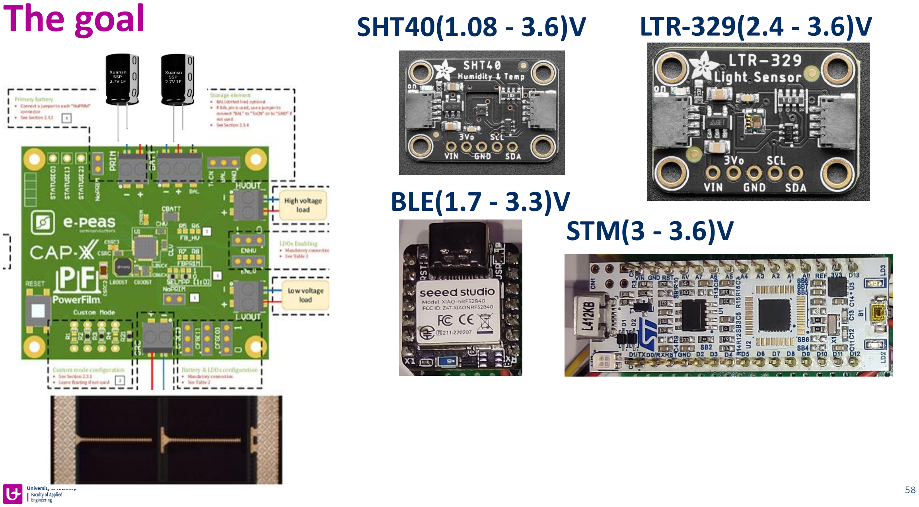
[picture p131: page 58]

## STM(3 - 3.6)V

## BLE(1.7 - 3.3)V

# Do we even have enough power ??? ^^

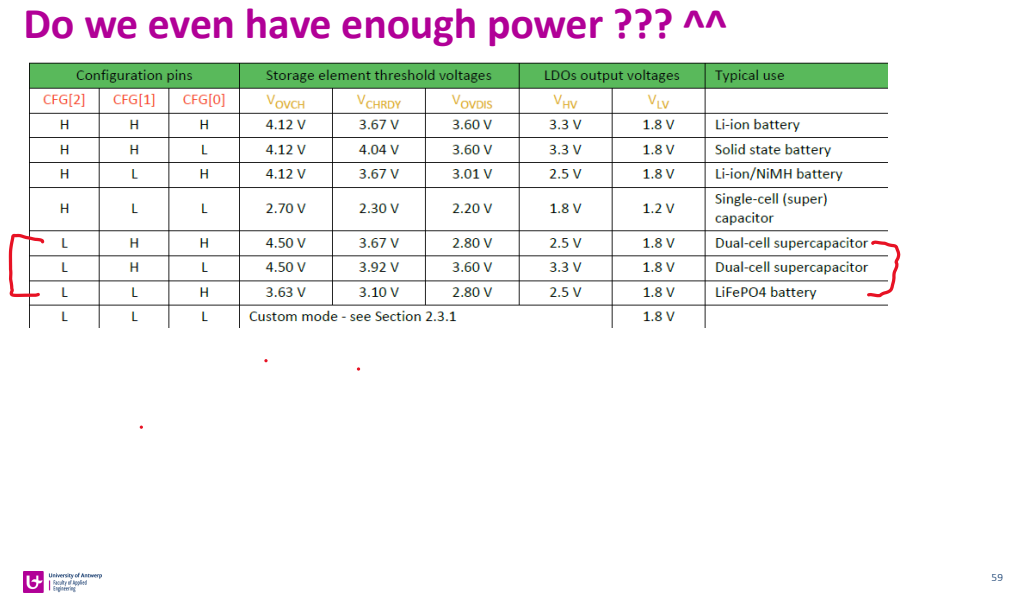
[picture p132: page 59]

# Energy harvesting so far and expectations

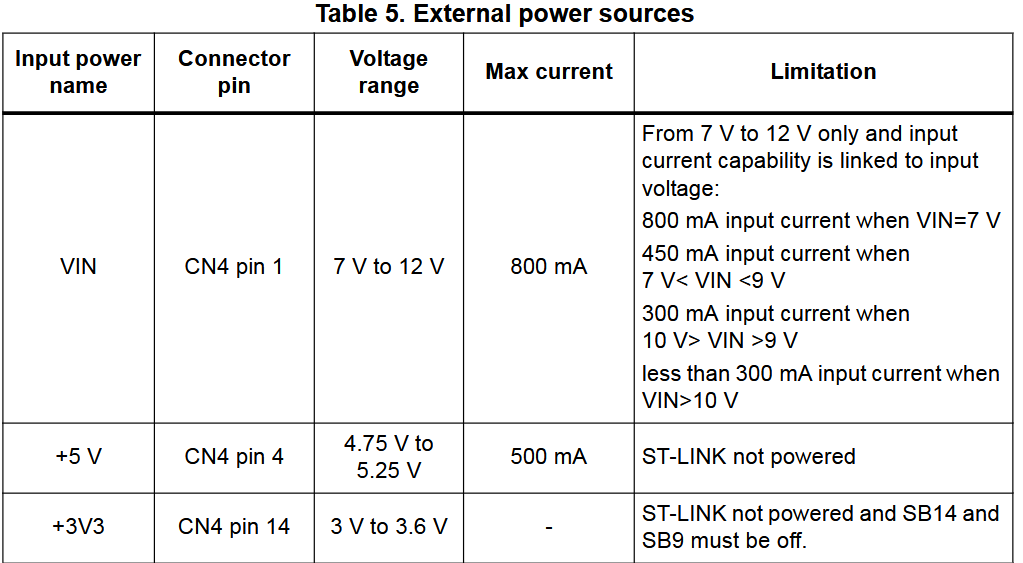
[picture p133: figure]

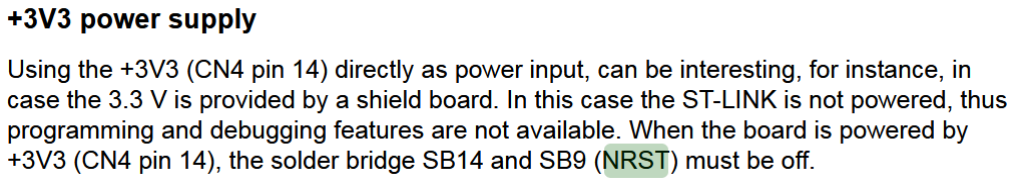
[picture p134: figure]

# Decision making

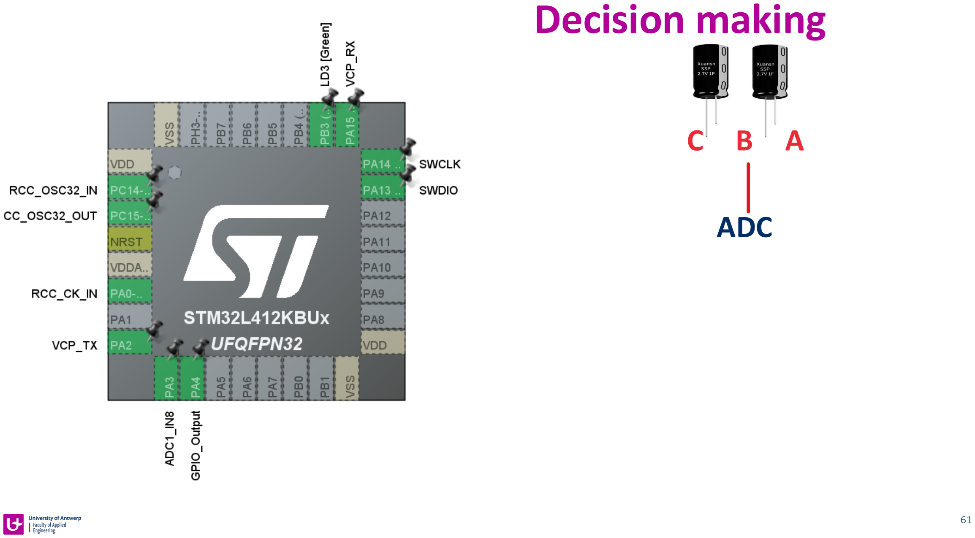
[picture p135: page 61]

## ADC

## C B A

## Voltage output measurement

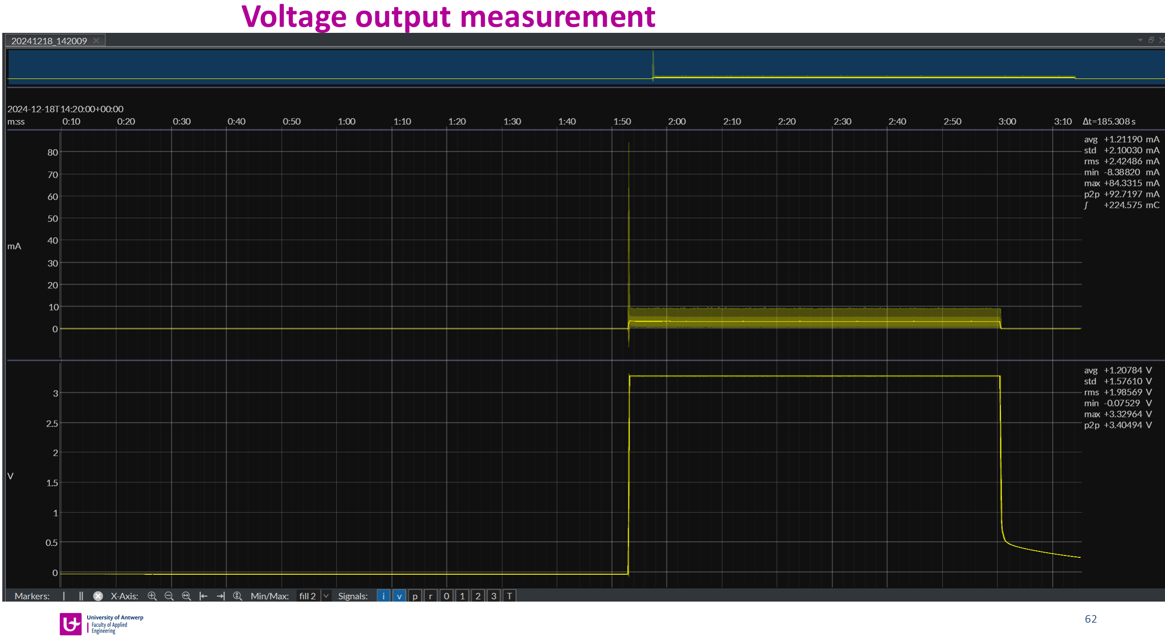
[picture p136: page 62]

## Voltage output measurement

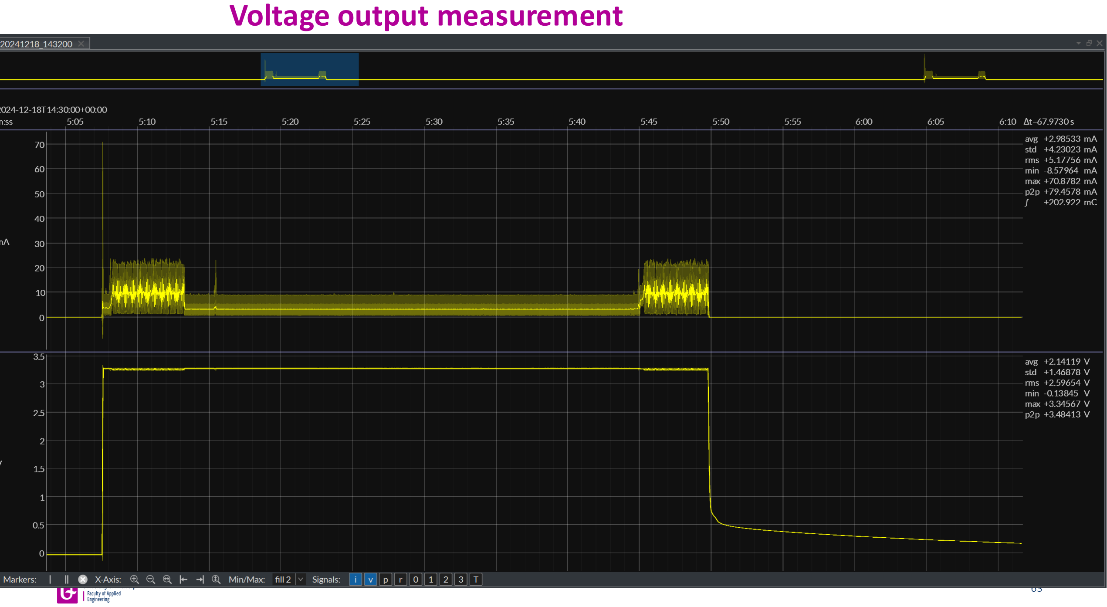
[picture p137: page 63]

## Voltage output measurement

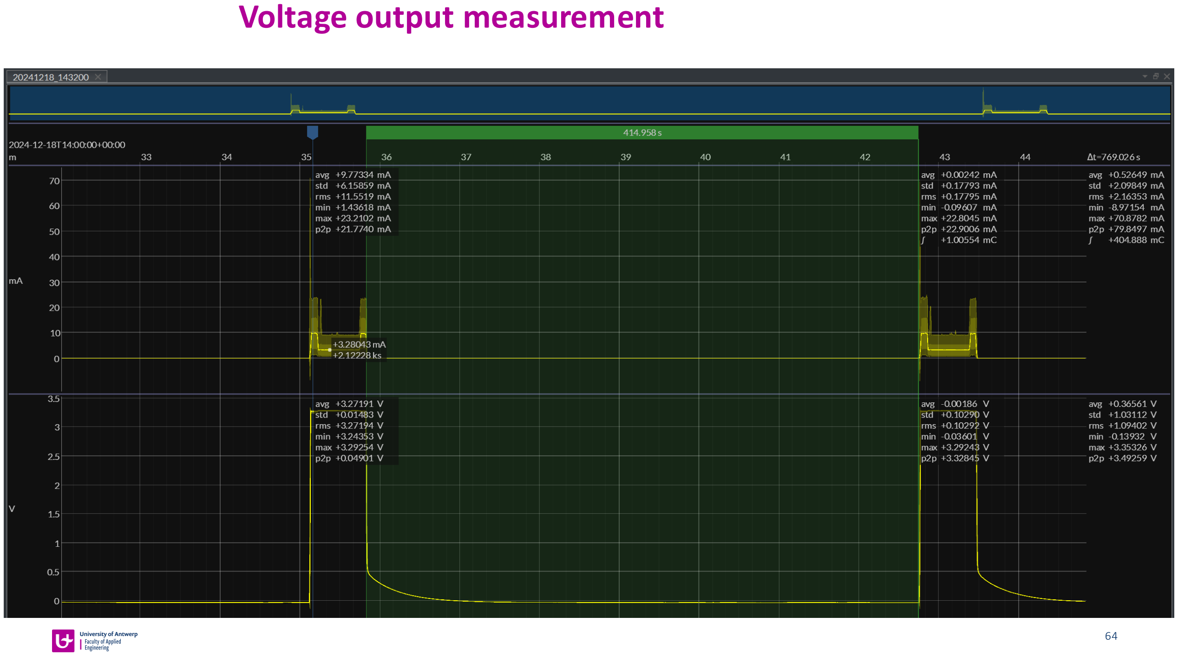
[picture p138: page 64]

# The goal

## SHT40(1.08 - 3.6)V LTR-329(2.4 - 3.6)V

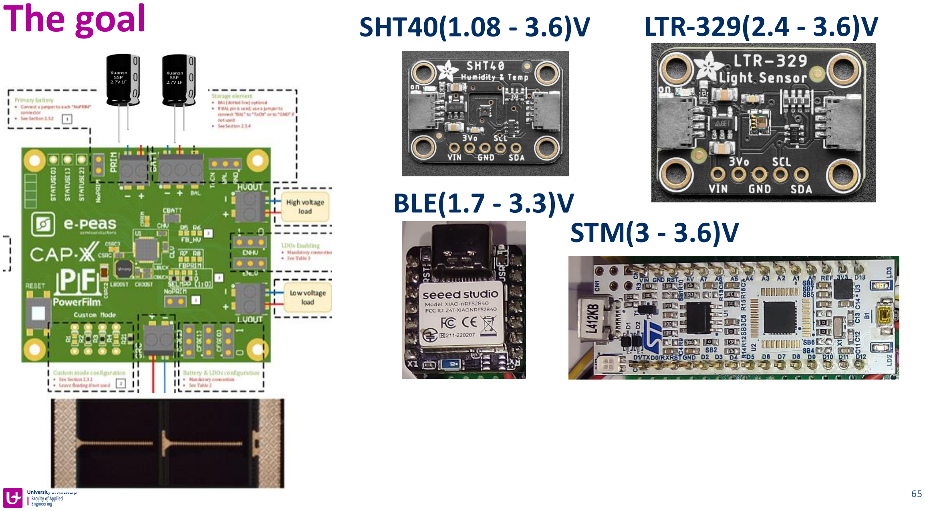
[picture p139: page 65]

## STM(3 - 3.6)V

## BLE(1.7 - 3.3)V

# Power Profile

# Power Profiling STM32

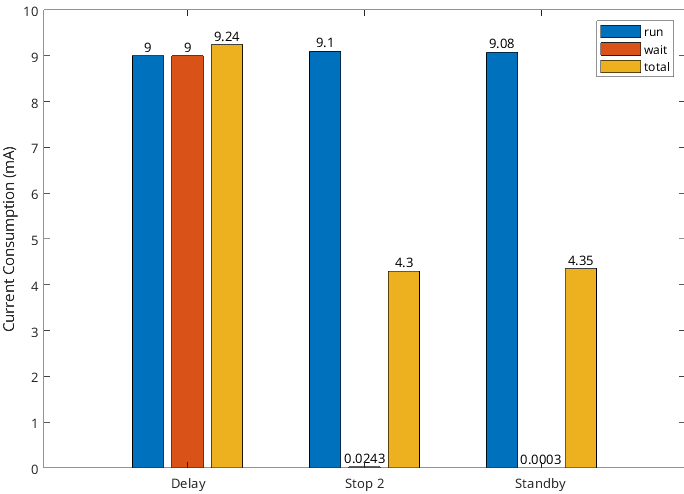
[picture p140: figure]

# Power Profiling nRF52

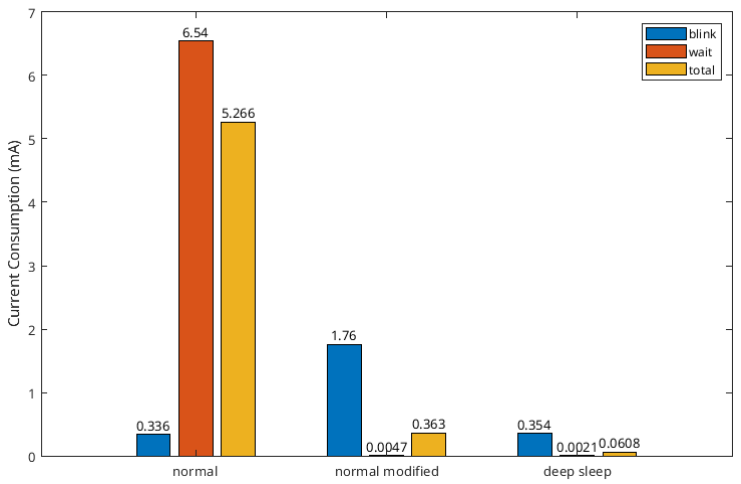
[picture p141: figure]

# STM32L4 VS NRF52

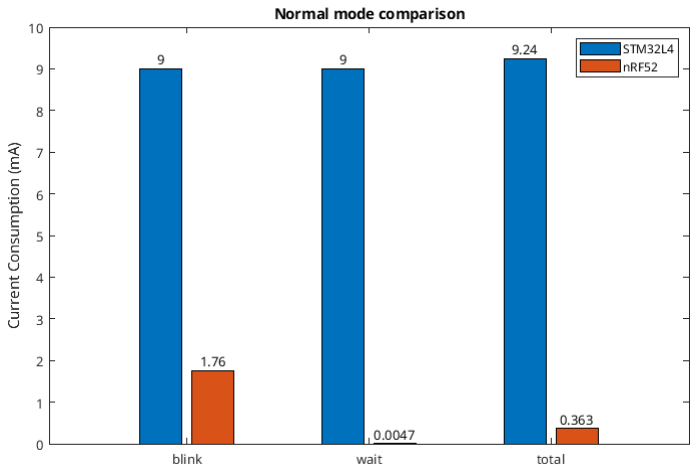
[picture p142: figure]

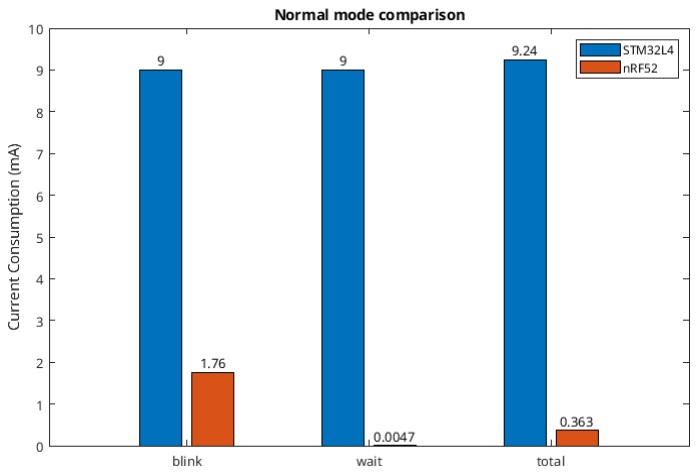
[picture p143: figure]

# NRF52 better/ easier than STM32L4?

# NRF52 VS STM32L4

# Power Profiling Sensor

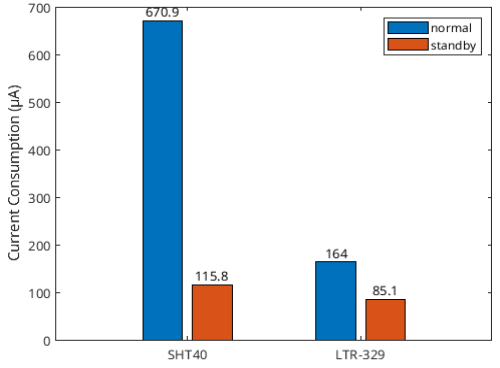
[picture p144: figure]

# Energy Awareness

# Energy Awareness

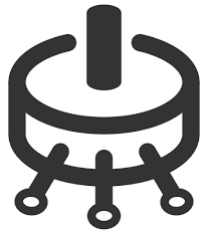
[picture p145: figure]
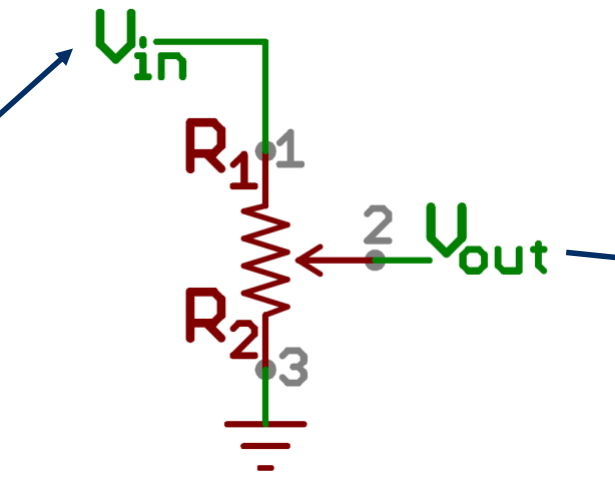
[picture p146: figure]
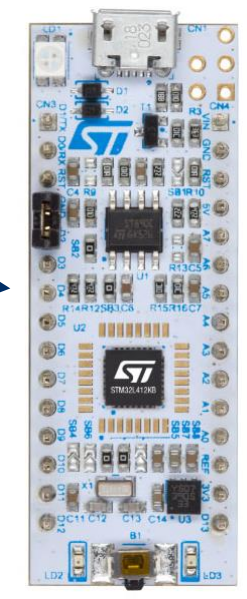
[picture p147: figure]

## ADC

### Simulation PMIC

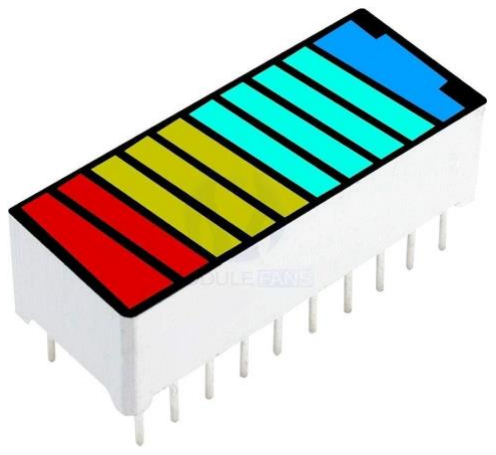
[picture p148: figure]

# Optimal Task Schedule

# Energy Awareness

# Energy Awareness

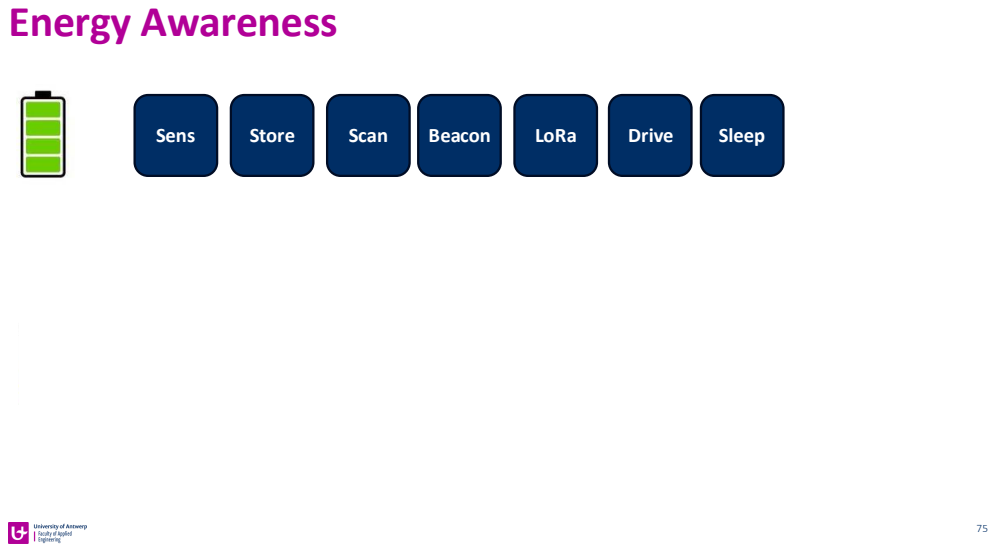
[picture p149: page 75]
Sens; Store; Scan; Beacon; LoRa; Drive; Sleep

# Energy Awareness

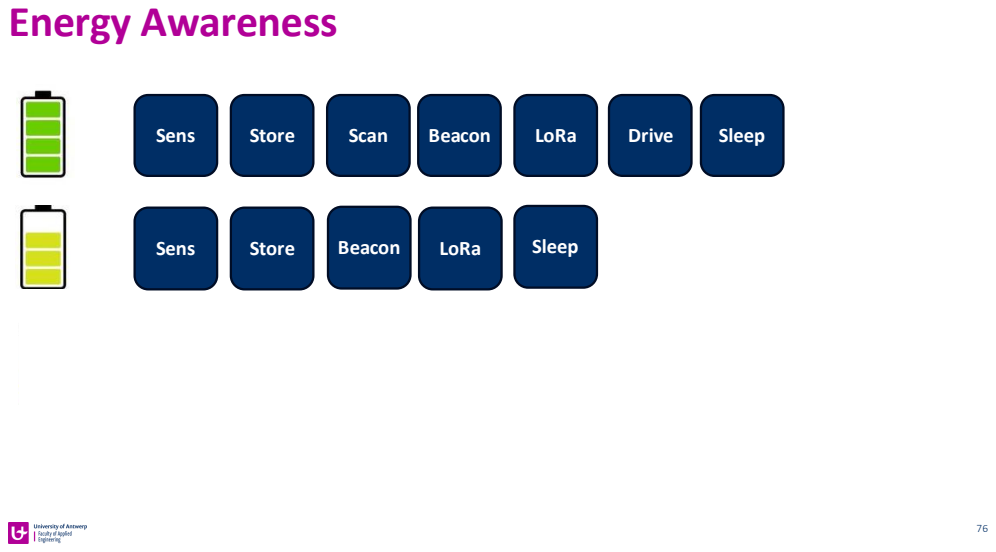
[picture p150: page 76]
Sens; Store; Scan; Beacon; LoRa; Drive; Sleep

# Energy Awareness

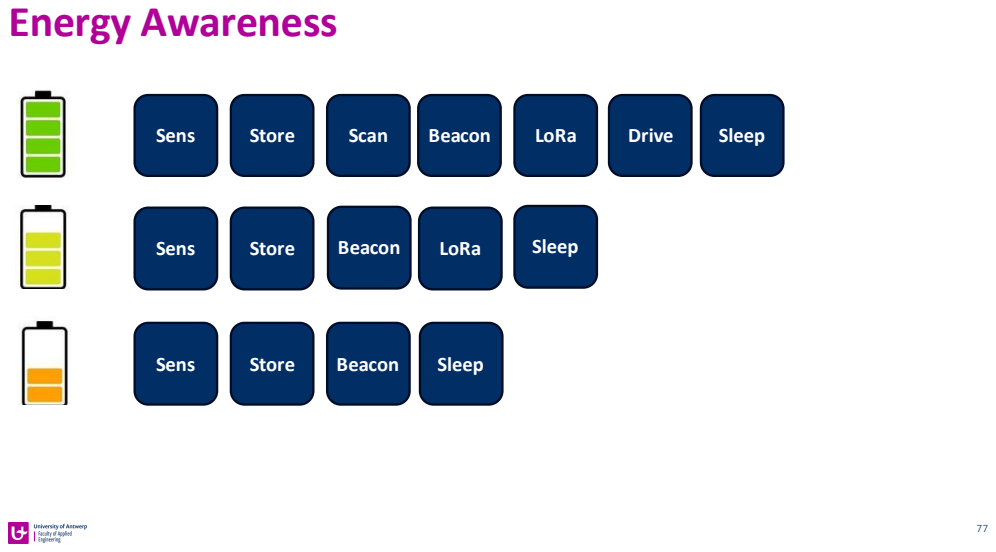
[picture p151: page 77]
Sens; Store; Scan; Beacon; LoRa; Drive; Sleep

# Energy Awareness

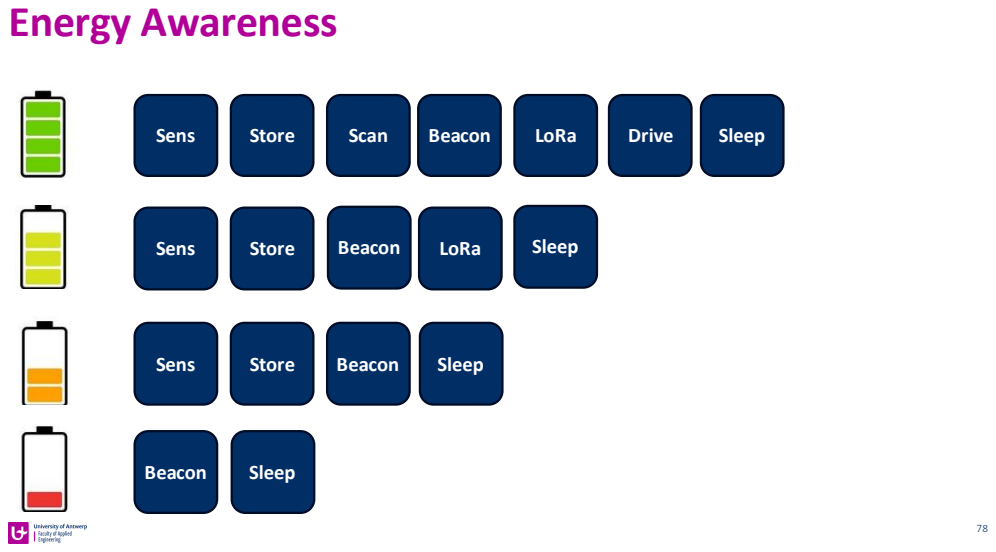
[picture p152: page 78]
Sens; Store; Scan; Beacon; LoRa; Drive; Sleep

# Optimal Transmission

# Energy Awareness

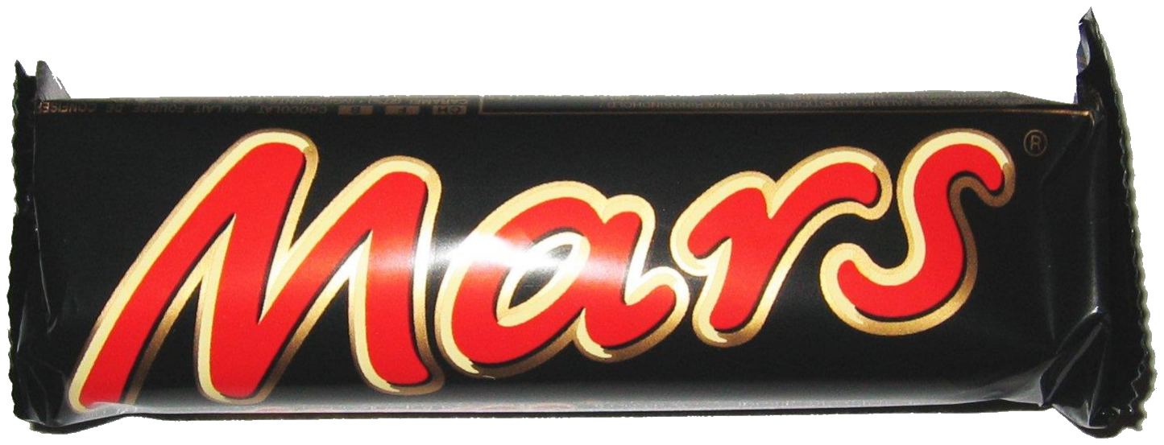
[picture p153: figure]
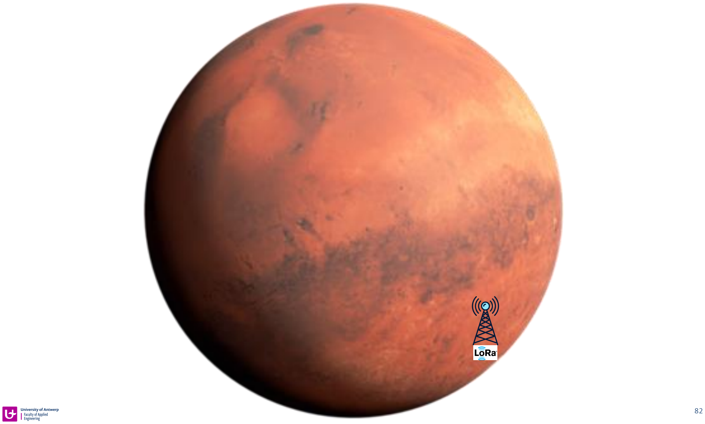
[picture p154: page 82]
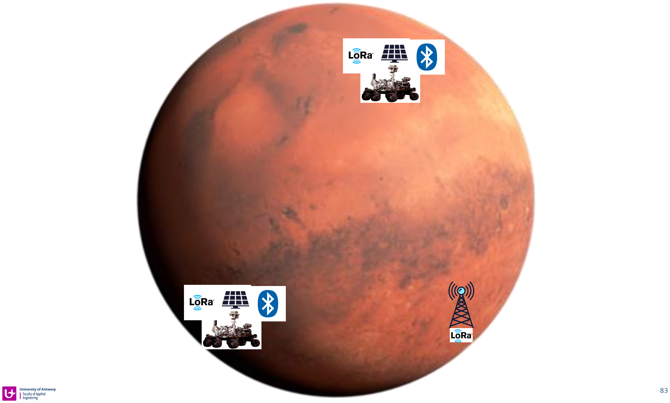
[picture p155: page 83]
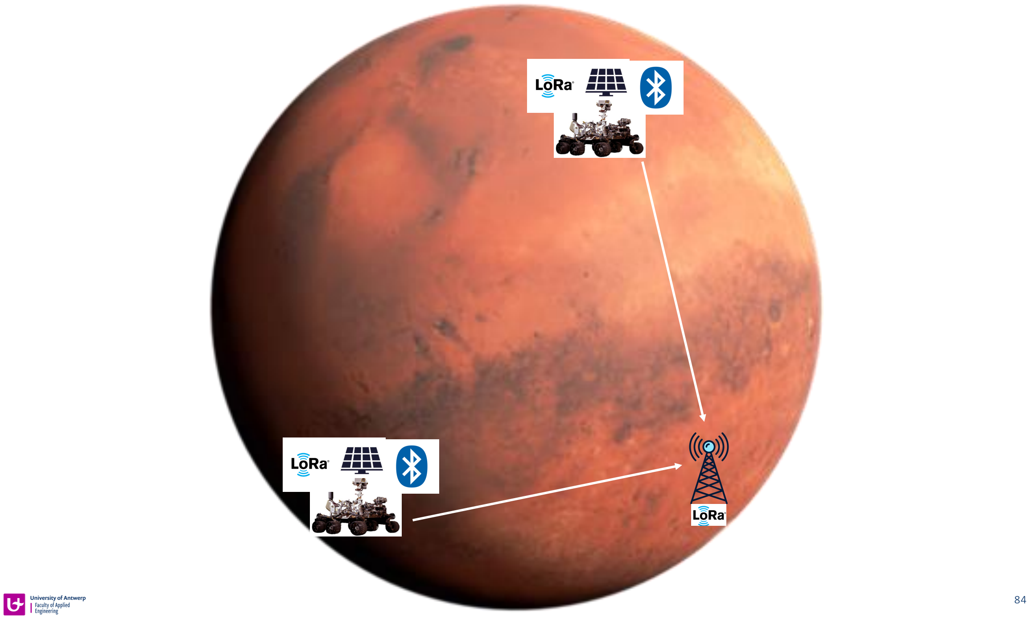
[picture p156: page 84]
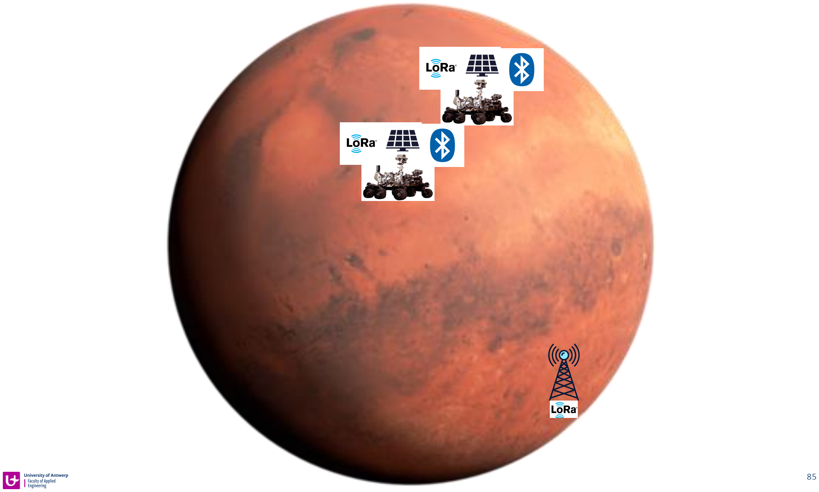
[picture p157: page 85]
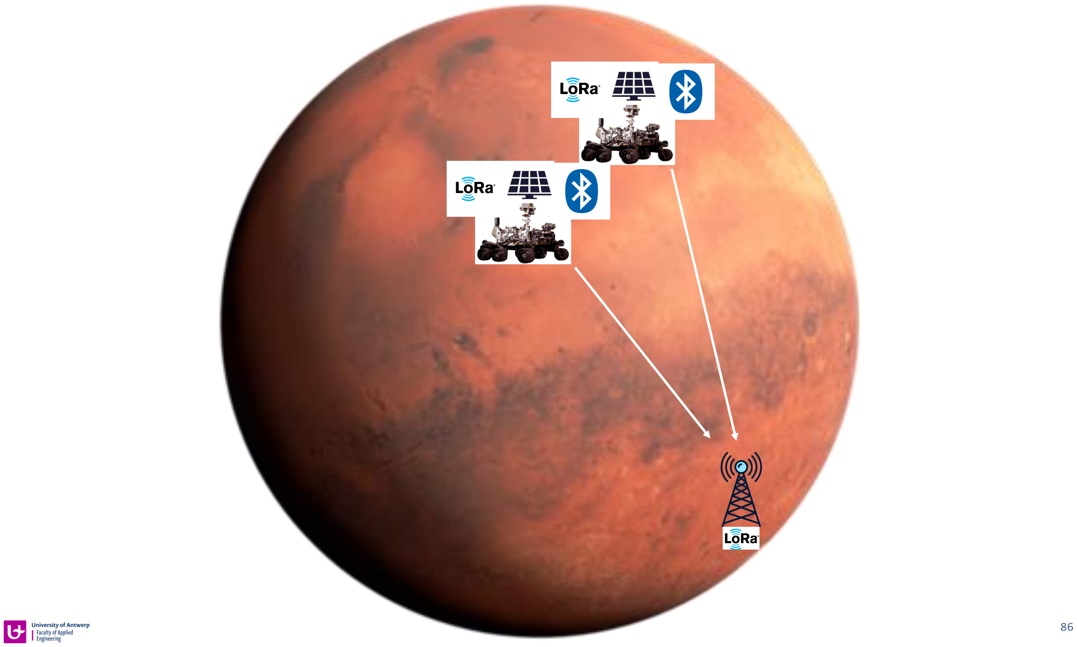
[picture p158: page 86]
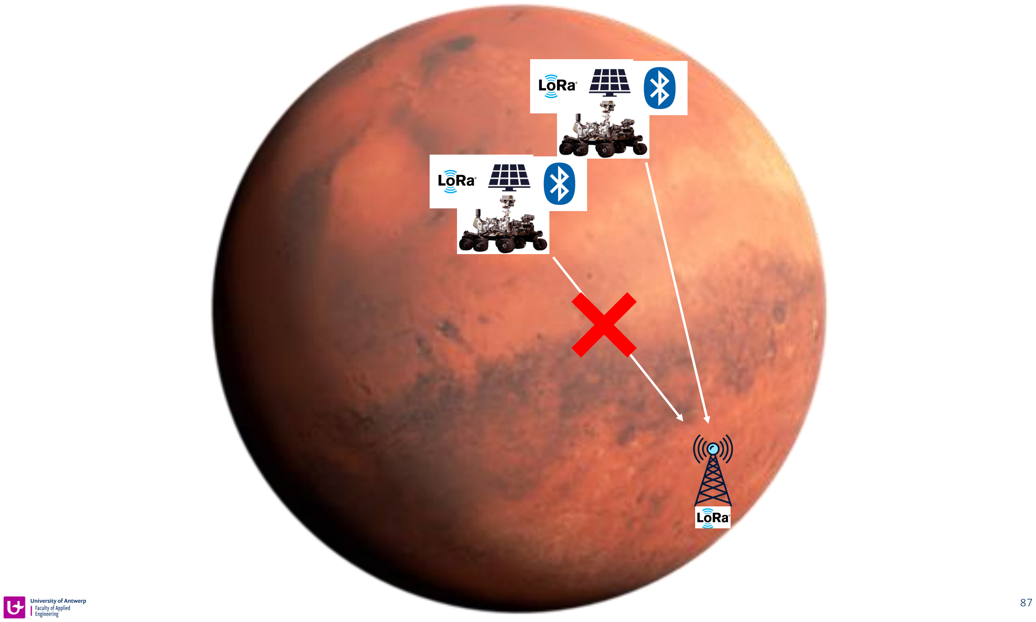
[picture p159: page 87]

# Challenges

Adam Hejduk | Robbe Elsermans | Thomas Kramp
- I2C protocol with sensors, HAL library and programming in general
- This course has been a new experience !
- Feels like I literally learned how to solder here
- Reading
| • (human) communication • NRF SDK documentation
- Tools
| • Defining propper objectives • Reading the docs takes time | • Applying I2C support Linebot (GPIO) LoRaWAN (UART) • Keeping the LoRa module connected • MPU6050 power measurents

### For all

- mA is high current in LP environment
- STM32 has powerful processor catalogue
- STM32 has extensive examples
- (Personally) STM32 outperforms Nordic Semiconductor documentations
- Power Profiling is fun (with the right equipment)
- Set a stable development environment up before coding
- Have spares to test faults

# Learns

- Further optimize STM32 power usage
- Use nRF SDK directly
- Further optimize nRF52 power usage
- Reprogram SEEED LoRa module (is STM32 based)
- Use its build-in EEPROM
- Orientation V2
- Optimal Transmission algorithm
- Find a replacement for the gyroscope measurements
- 4.5V to 5.7V custom E.H.M. configuration
- Supercap equal voltage distribution

# Further Development

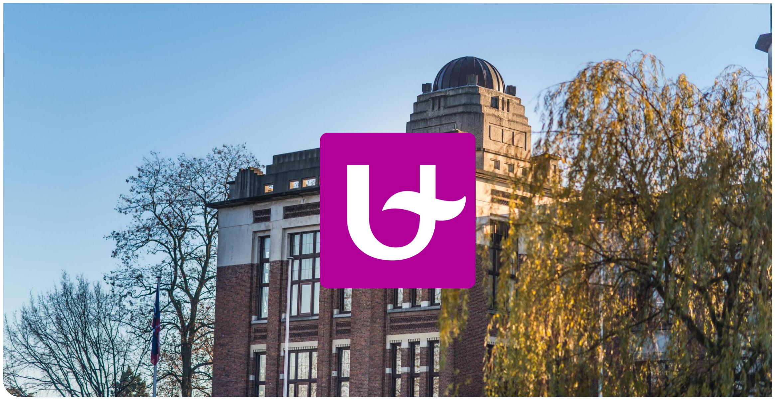
[picture p160: page 92]

# Demo

# Demo

https://www.youtube.com/watch?v=zGMOyNRa958&ab_channel=RobbeElsermans

# Appendix

# Orientation V2

### Antenna relative placement

# BLE Communication system

- https://www.istockphoto.com/fr/vectoriel/ic%C3%B4ne-noire-d%C3%A9nergie-solaire-gm1272457034-374723493
- https://www.flaticon.com/free-icon/antenna_7021857
- https://icon-icons.com/icon/potentiometer/4907
- https://www.alamy.com/mars-rover-isolated-on-white-background-elements-of-this-image-were-furnished-by-nasa-high-quality-photo-image425822621.html
- https://www.amazon.ca/Segment-Battery-Display-Indicator-Multi-Color/dp/B07S3NJCML
- https://www.digikey.be/en/products/detail/stmicroelectronics/NUCLEO-L412KB/9656229
- https://www.ram-center.com/blog/bluetooth-low-energy-interface-ble
- https://www.mouser.be/new/powerfilm/powerfilm-solar-dev-kit-e-peas-cap-xx/
- https://befr.rs-online.com/web/p/development-tool-accessories/2821454
- https://nodered.org/about/resources/
- https://www.thethingsnetwork.org/brand-assets/
- https://learn.sparkfun.com/tutorials/voltage-dividers/all
- https://www.vecteezy.com/free-vector/battery-icon
- https://en.m.wikipedia.org/wiki/File:Mars.png
- https://www.vecteezy.com/free-png/mars

# References

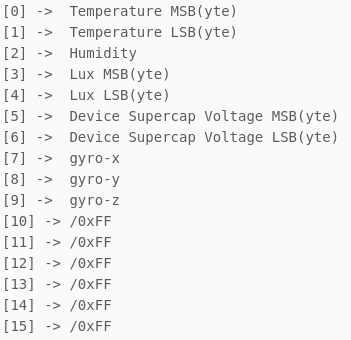
[picture p161: figure]

## Advertise -> IBeacon

- UUID
- MAJOR
- TX Power @ 1m

# BLE Communication system

# Power Profiling STM32

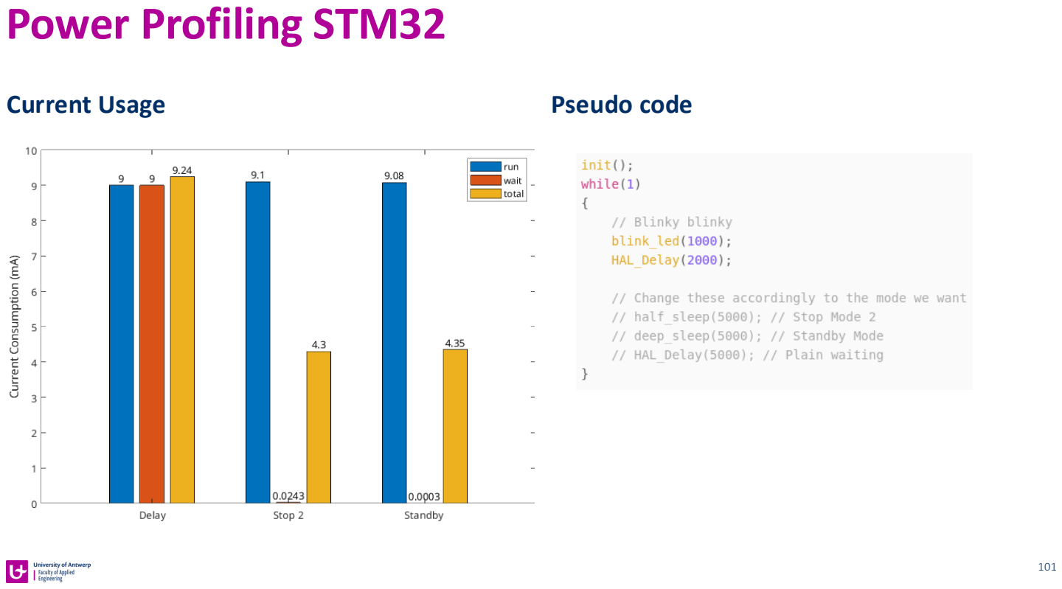
[picture p162: page 99]

Current Usage | Pseudo code

# Power Profiling nRF52

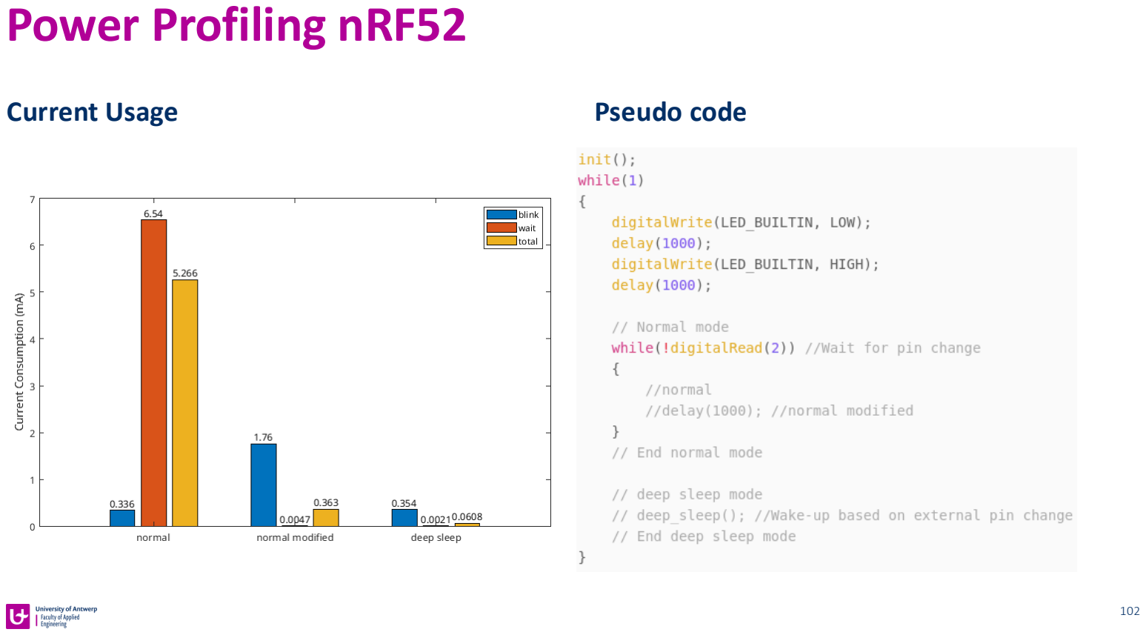
[picture p163: page 100]

Current Usage | Pseudo code

Current Usage | Pseudo code

# Power Profiling Sensor

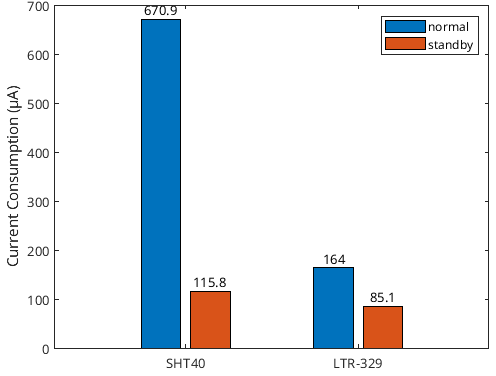
[picture p164: figure]
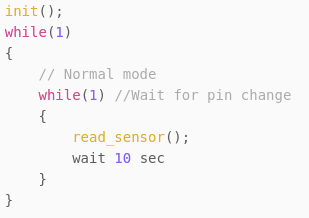
[picture p165: figure]

### Intercommunication

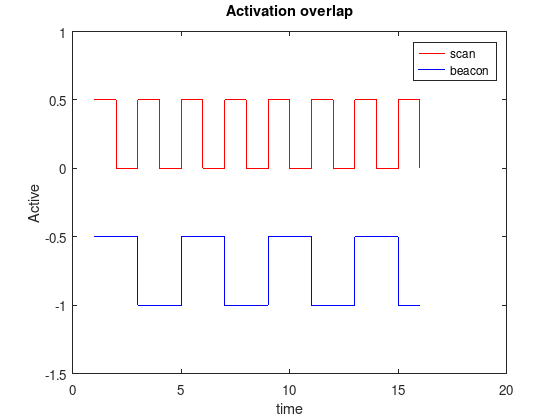
[picture p166: figure]

- Overlap needed
- 2^n time differences
- Guaranteed delivery
- Test: 7% dropout (100)

# BLE Communication system

# Energy Awareness

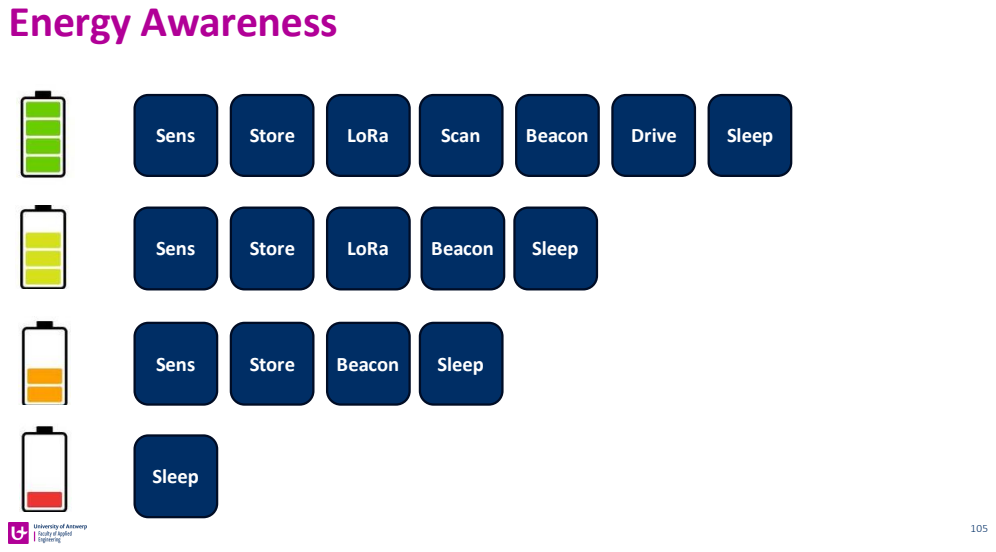
[picture p167: page 103]
Sens; Store; LoRa; Scan; Beacon; Drive; Sleep

# MCU Pinout

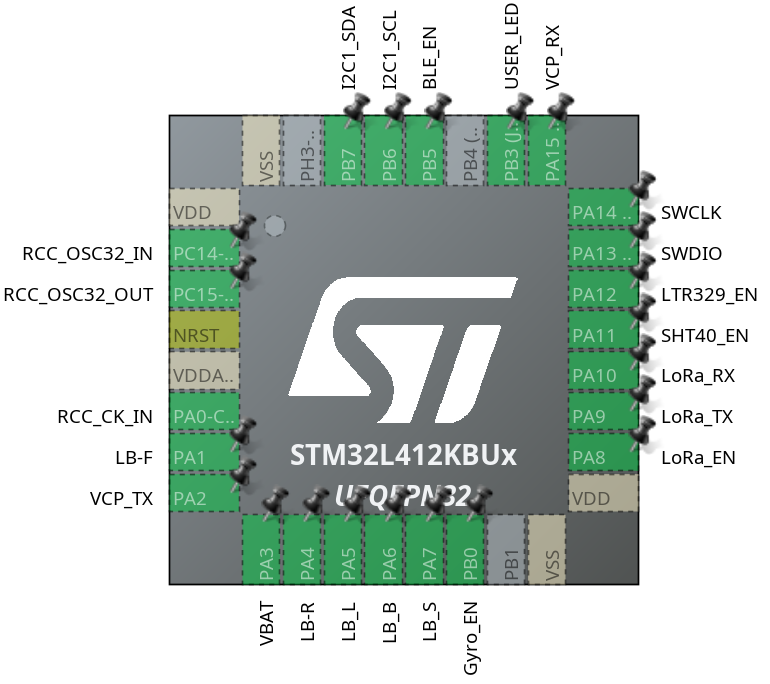
[picture p168: figure]

# Demonstration plan

## - Powering the STM with reliable source but have a potentiometer to shift the voltage of the circuit to simulate power levels of solar

harvesting...

## - Depending on the levels of volatege available rover would/could do

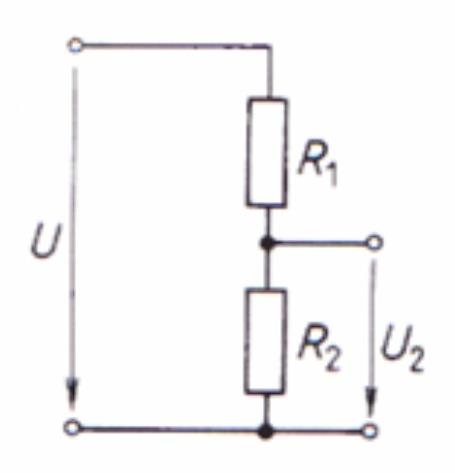
[picture p169: figure]

## specific nubmer of tasks (task desicion making)

## - Therefore we are optimising a solution to energy related decision making

# Energy Harvesting Simulation

## - Simulation PMIC

## ADC

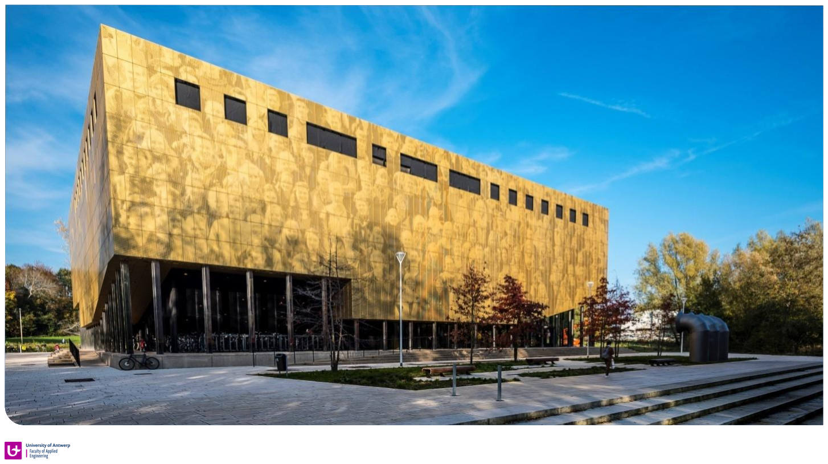
[picture p170: page 107]
