RobbeElsermans/SSR/gantt_chart.png

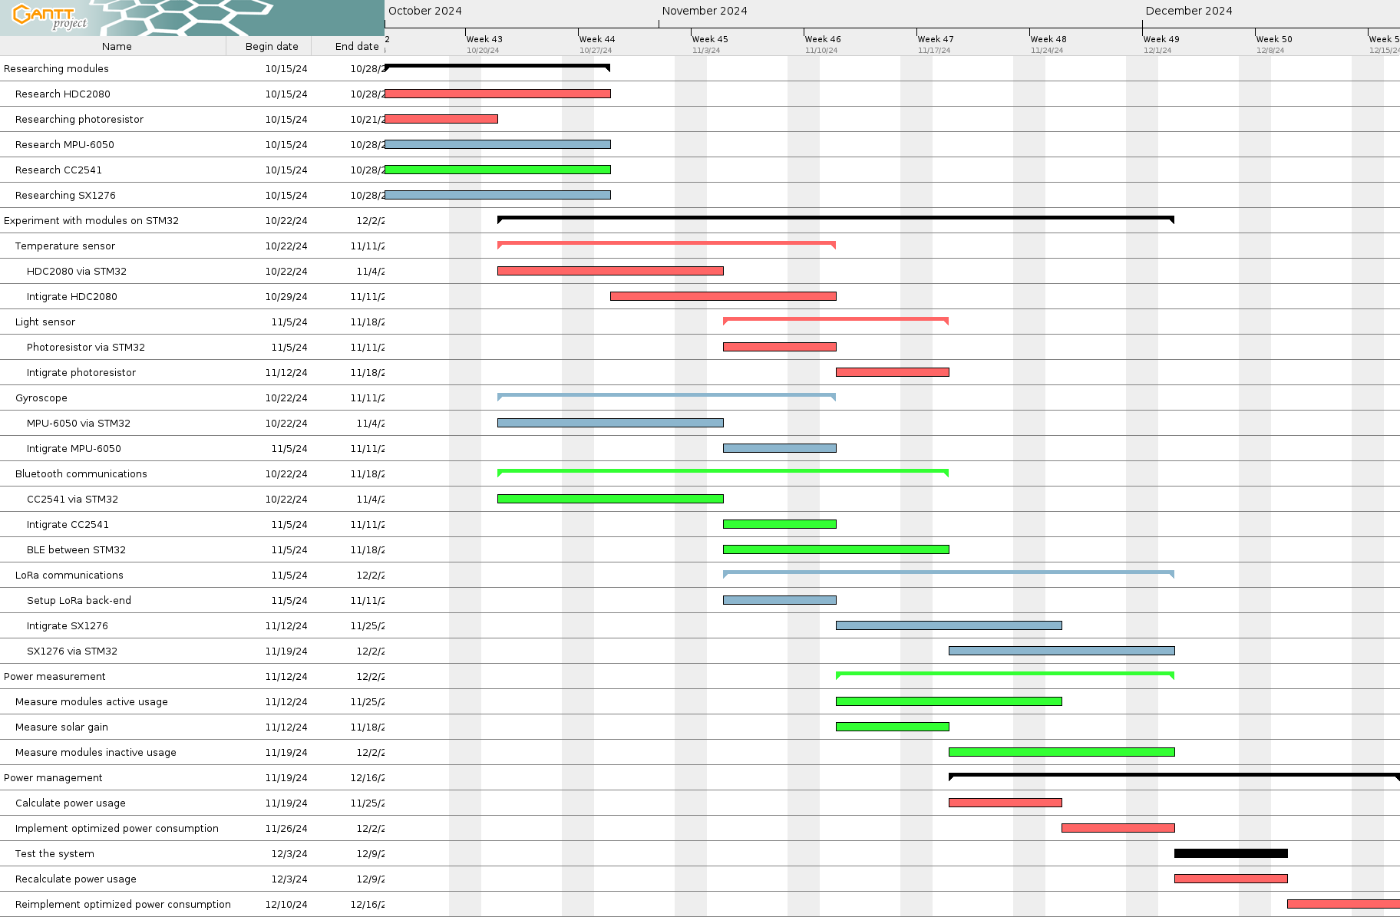
gantt_chart.png
