RobbeElsermans/SSR/Portfolio/SSR_Portfolio/Images/BLE/BLE_observation_right.png

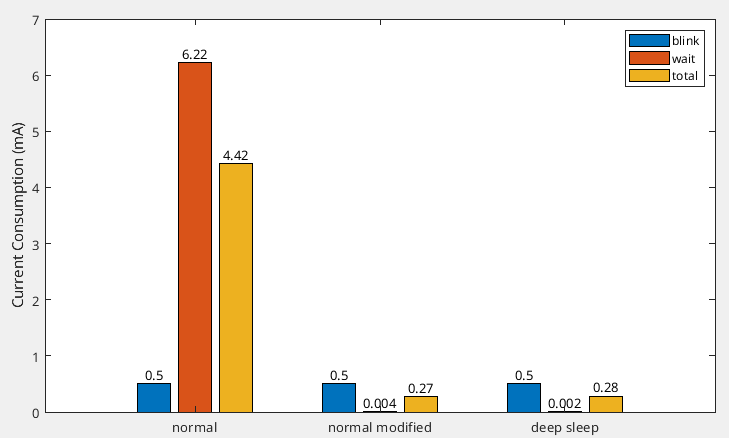
Portfolio/SSR_Portfolio/Images/BLE/BLE_observation_right.png
