RobbeElsermans/SSR/Portfolio/SSR_Portfolio/Images/BLE/BLE_wait_modes.png

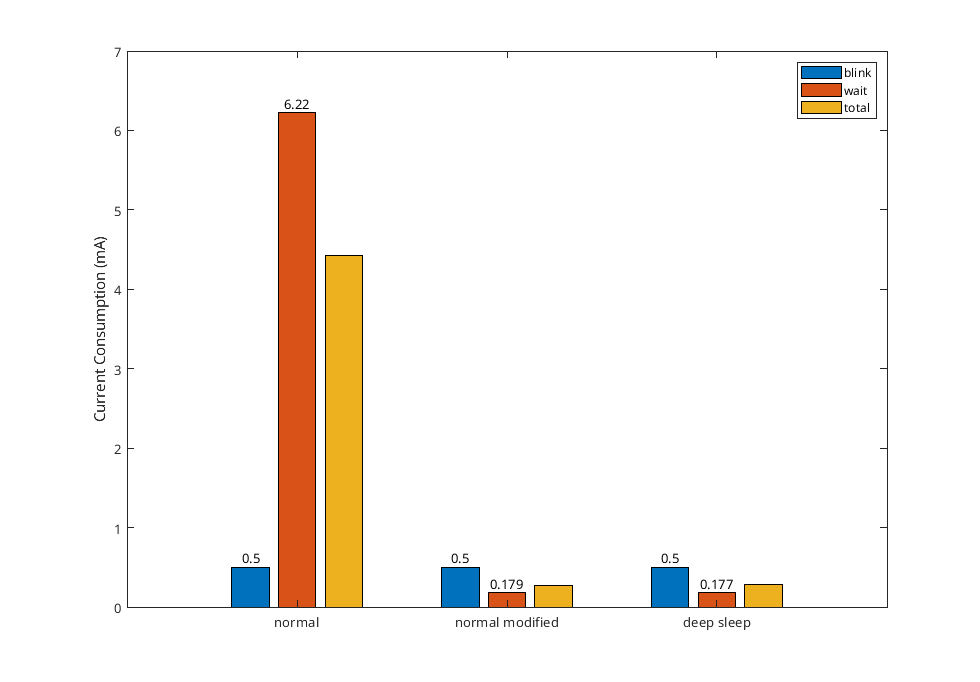
Portfolio/SSR_Portfolio/Images/BLE/BLE_wait_modes.png
