RobbeElsermans/SSR/Portfolio/SSR_Portfolio/Images/BLE/Block_Diagram_BLE.png

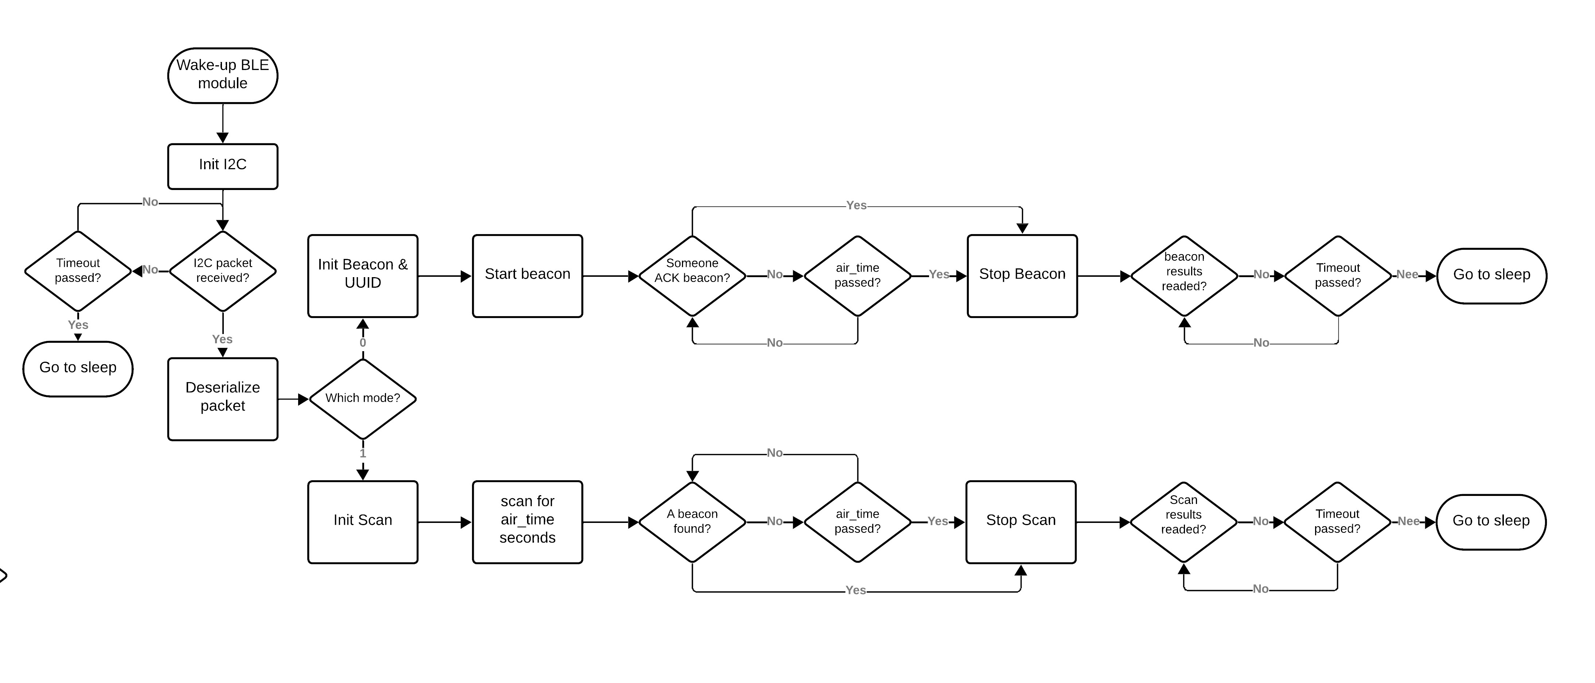
Portfolio/SSR_Portfolio/Images/BLE/Block_Diagram_BLE.png
