RobbeElsermans/SSR/Portfolio/SSR_Portfolio/Images/BLE/nrf52840_pinout.jpg

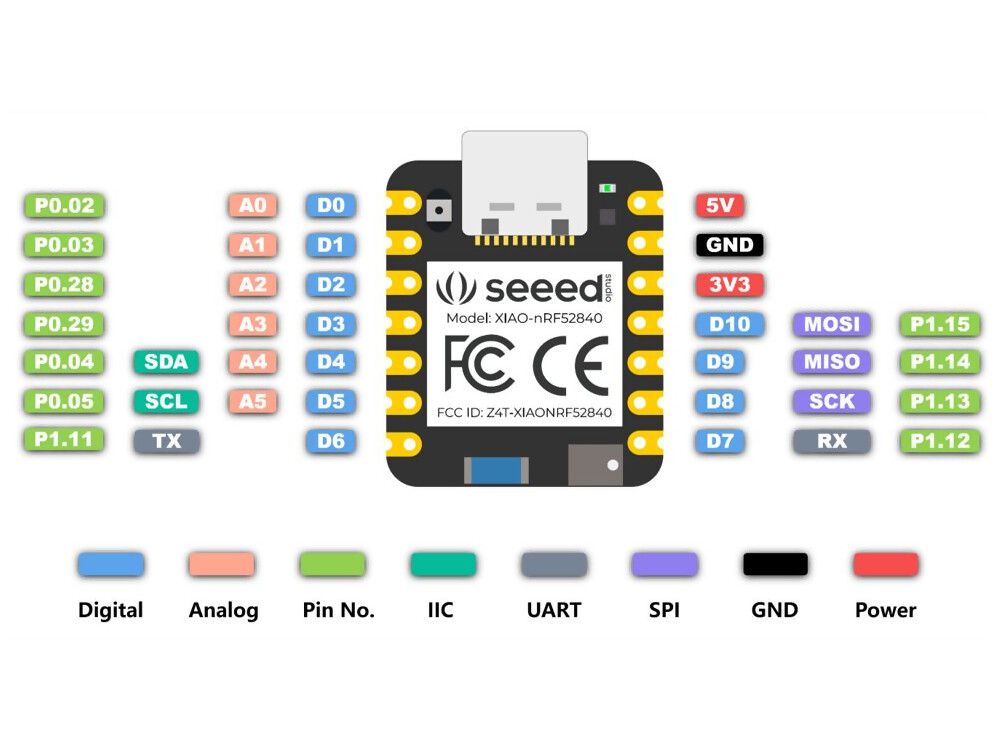
Portfolio/SSR_Portfolio/Images/BLE/nrf52840_pinout.jpg
