RobbeElsermans/SSR/Portfolio/SSR_Portfolio/Images/I2C/default.png

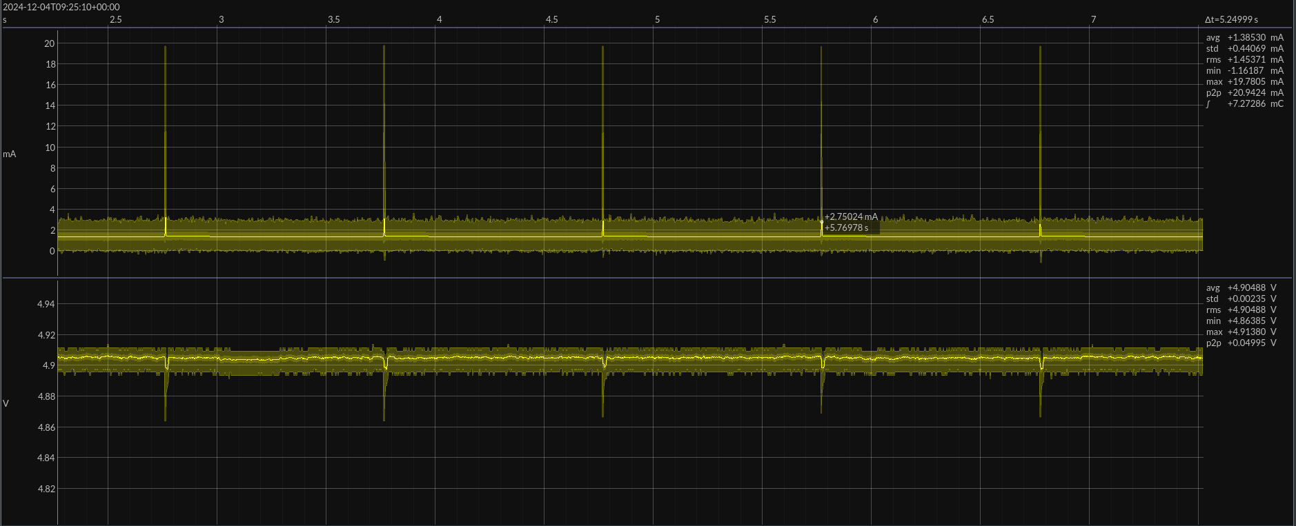
Portfolio/SSR_Portfolio/Images/I2C/default.png
