RobbeElsermans/SSR/Portfolio/SSR_Portfolio/Images/I2C/full_devide.png

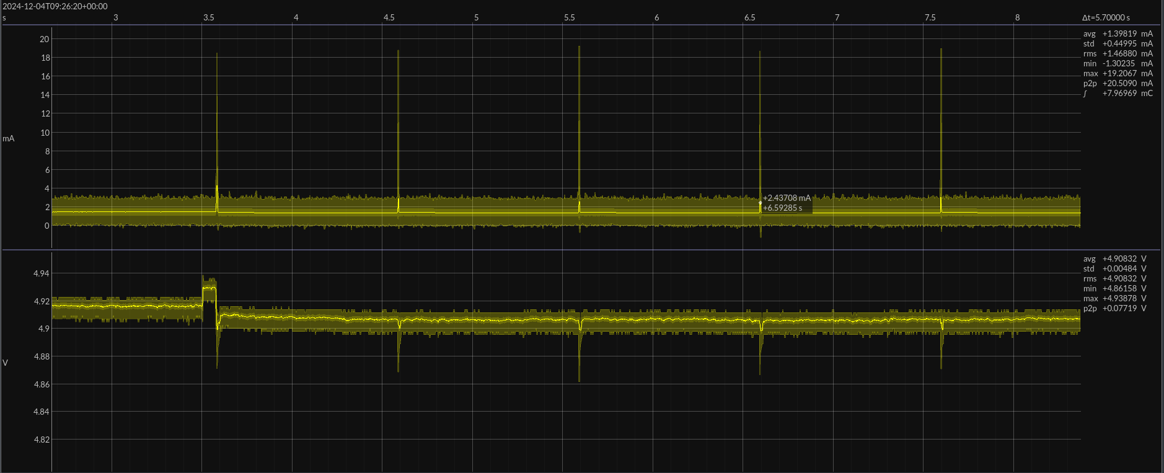
Portfolio/SSR_Portfolio/Images/I2C/full_devide.png
