RobbeElsermans/SSR/Portfolio/SSR_Portfolio/Images/I2C/gyroX_ref.png

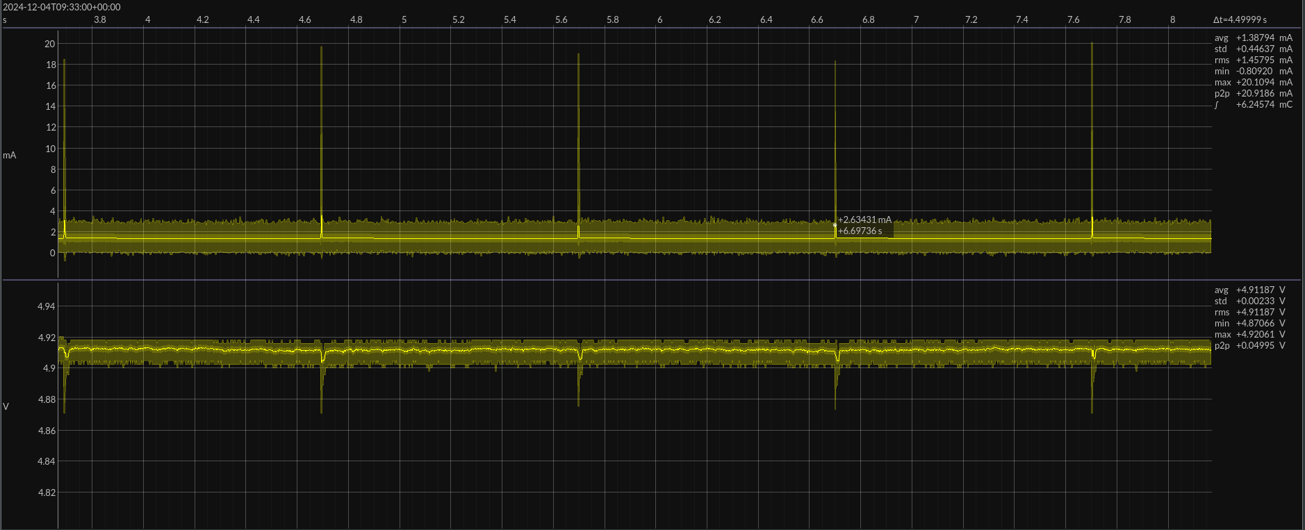
Portfolio/SSR_Portfolio/Images/I2C/gyroX_ref.png
