RobbeElsermans/SSR/Portfolio/SSR_Portfolio/Images/I2C/gyroY_ref.png

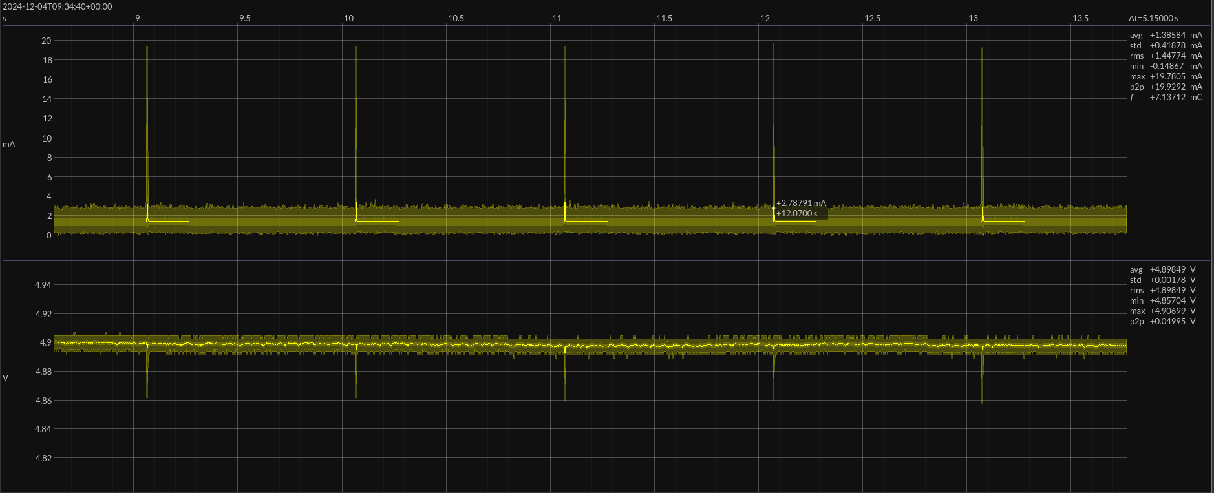
Portfolio/SSR_Portfolio/Images/I2C/gyroY_ref.png
