RobbeElsermans/SSR/Portfolio/SSR_Portfolio/Images/I2C/gyroZ_ref.png

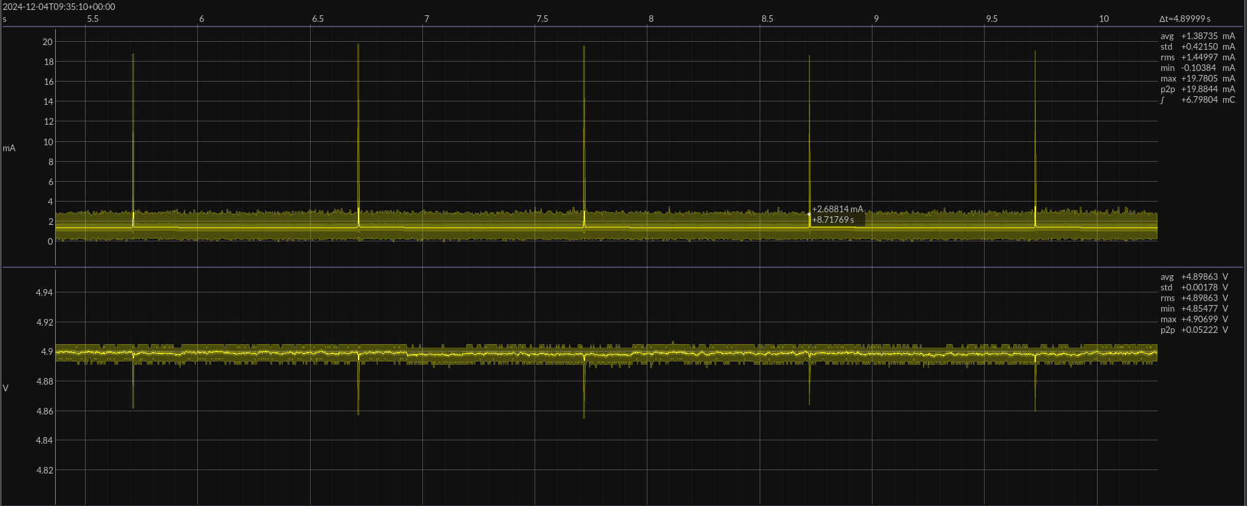
Portfolio/SSR_Portfolio/Images/I2C/gyroZ_ref.png
