RobbeElsermans/SSR/Portfolio/SSR_Portfolio/Images/I2C/max_acc.png

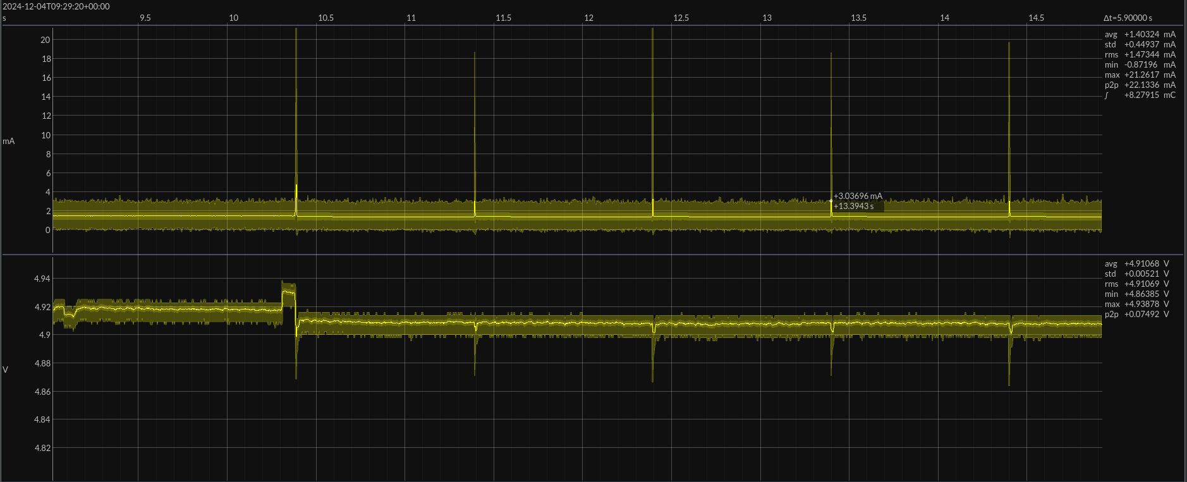
Portfolio/SSR_Portfolio/Images/I2C/max_acc.png
