RobbeElsermans/SSR/Portfolio/SSR_Portfolio/Images/I2C/mode1.png

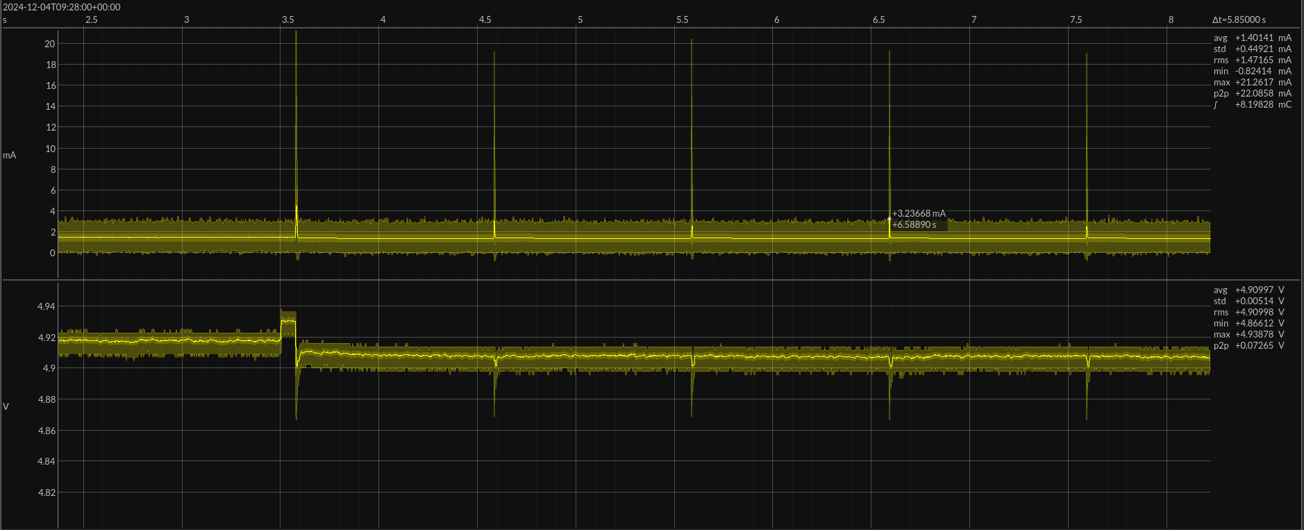
Portfolio/SSR_Portfolio/Images/I2C/mode1.png
