RobbeElsermans/SSR/Portfolio/SSR_Portfolio/Images/I2C/mode6.png

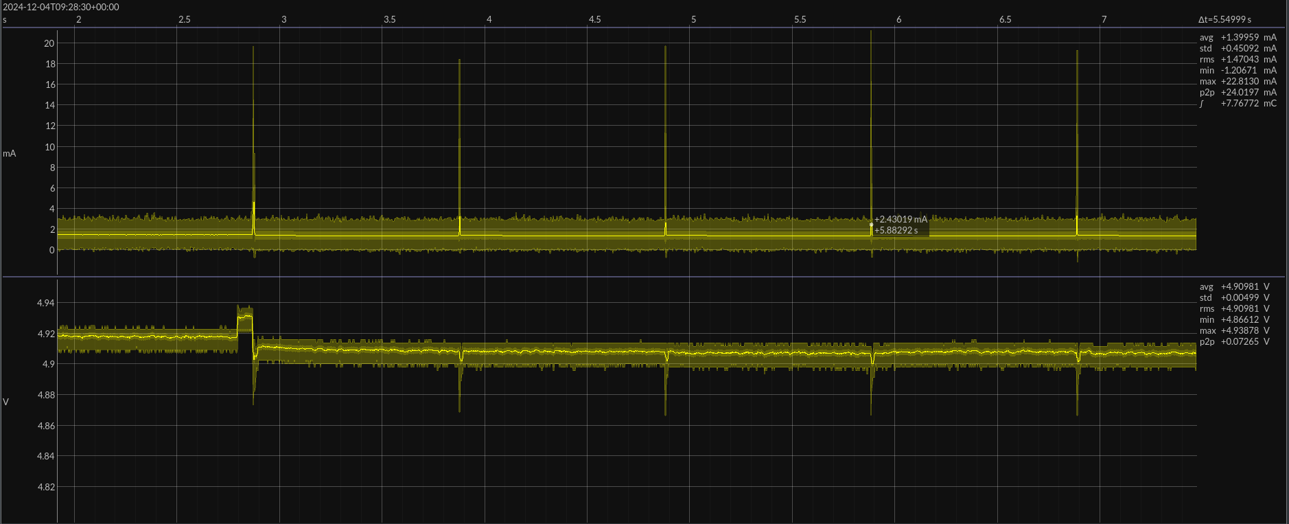
Portfolio/SSR_Portfolio/Images/I2C/mode6.png
