RobbeElsermans/SSR/Portfolio/SSR_Portfolio/Images/I2C/mpu_sleep_cycle.png

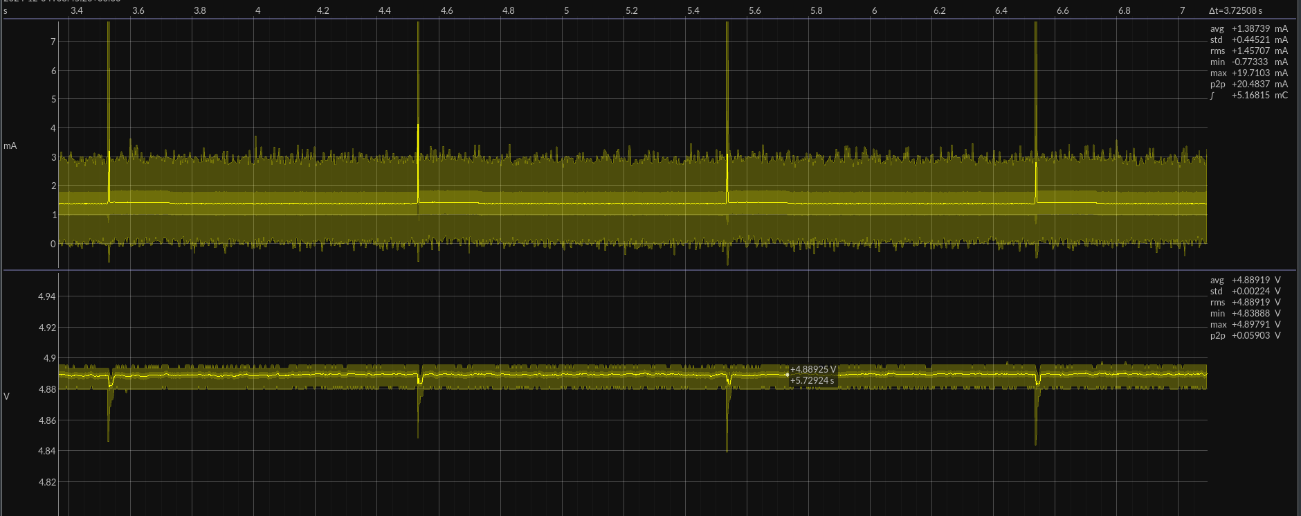
Portfolio/SSR_Portfolio/Images/I2C/mpu_sleep_cycle.png
