RobbeElsermans/SSR/Portfolio/SSR_Portfolio/Images/LoRa/module/at_command_full_output.png

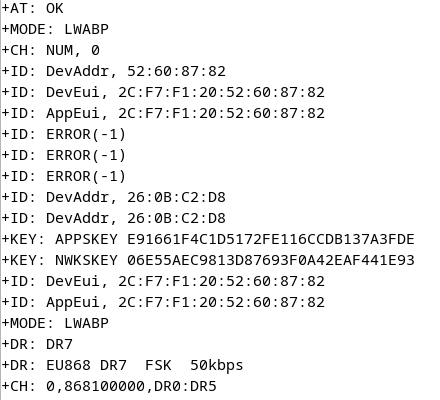
Portfolio/SSR_Portfolio/Images/LoRa/module/at_command_full_output.png
