RobbeElsermans/SSR/Portfolio/SSR_Portfolio/Images/Power_Profiling/BLE_Basic_wait_altered.png

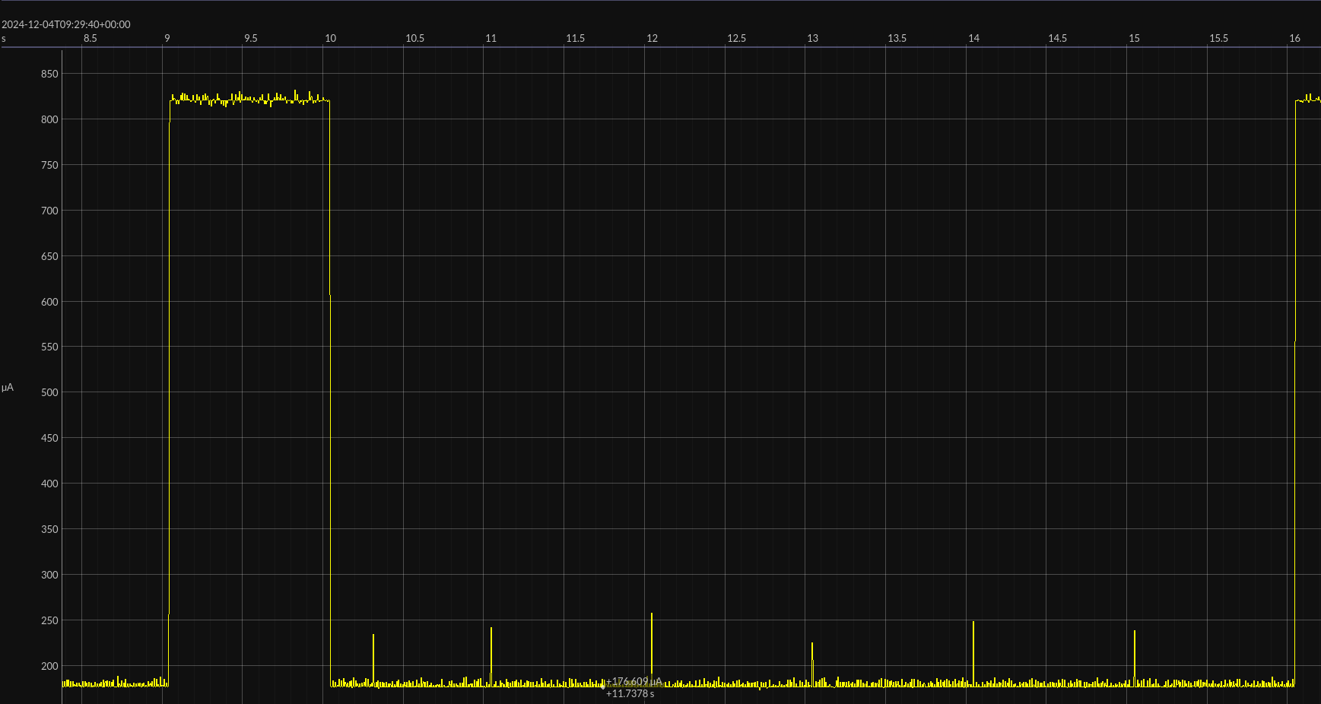
Portfolio/SSR_Portfolio/Images/Power_Profiling/BLE_Basic_wait_altered.png
