RobbeElsermans/SSR/Portfolio/SSR_Portfolio/Images/Power_Profiling/BLE_Beacon_consumation.png

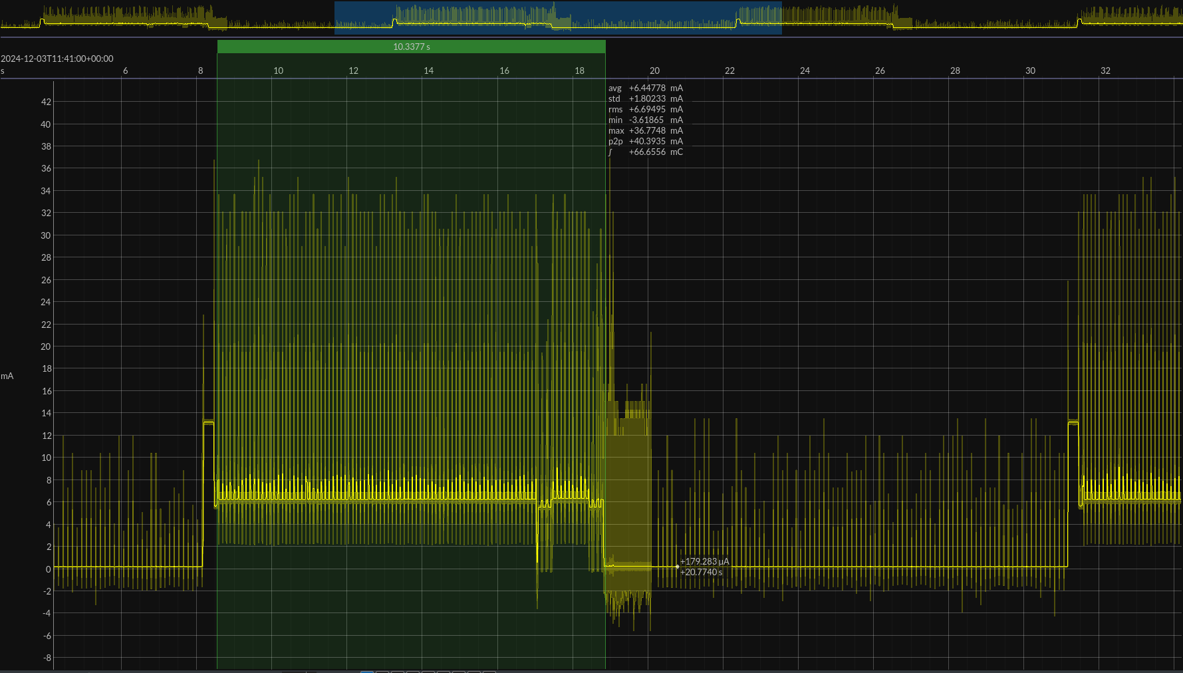
Portfolio/SSR_Portfolio/Images/Power_Profiling/BLE_Beacon_consumation.png
