RobbeElsermans/SSR/Portfolio/SSR_Portfolio/Images/Power_Profiling/BLE_low_power_wait.png

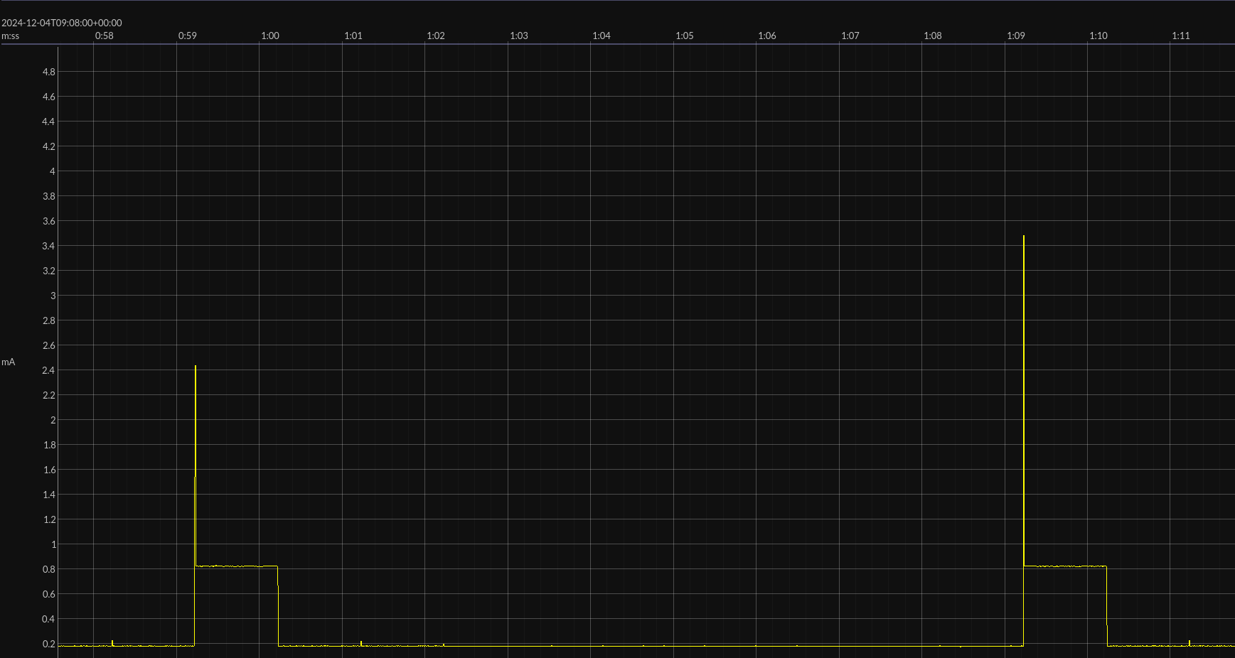
Portfolio/SSR_Portfolio/Images/Power_Profiling/BLE_low_power_wait.png
