RobbeElsermans/SSR/Portfolio/SSR_Portfolio/Images/Power_Profiling/EnergyHarvestingSTMnBLE2.png

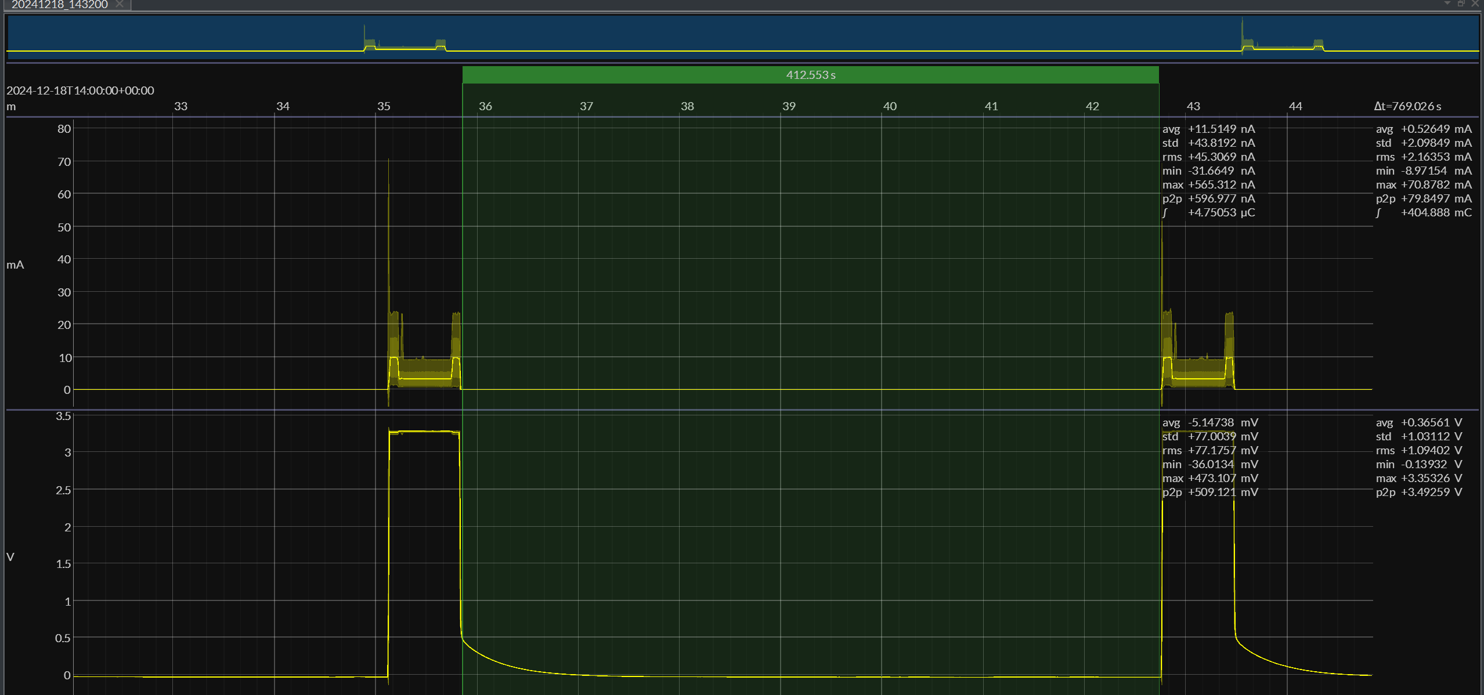
Portfolio/SSR_Portfolio/Images/Power_Profiling/EnergyHarvestingSTMnBLE2.png
