RobbeElsermans/SSR/Portfolio/SSR_Portfolio/Images/Power_Profiling/EnergyHarvestingSTMPoweringBLE.png

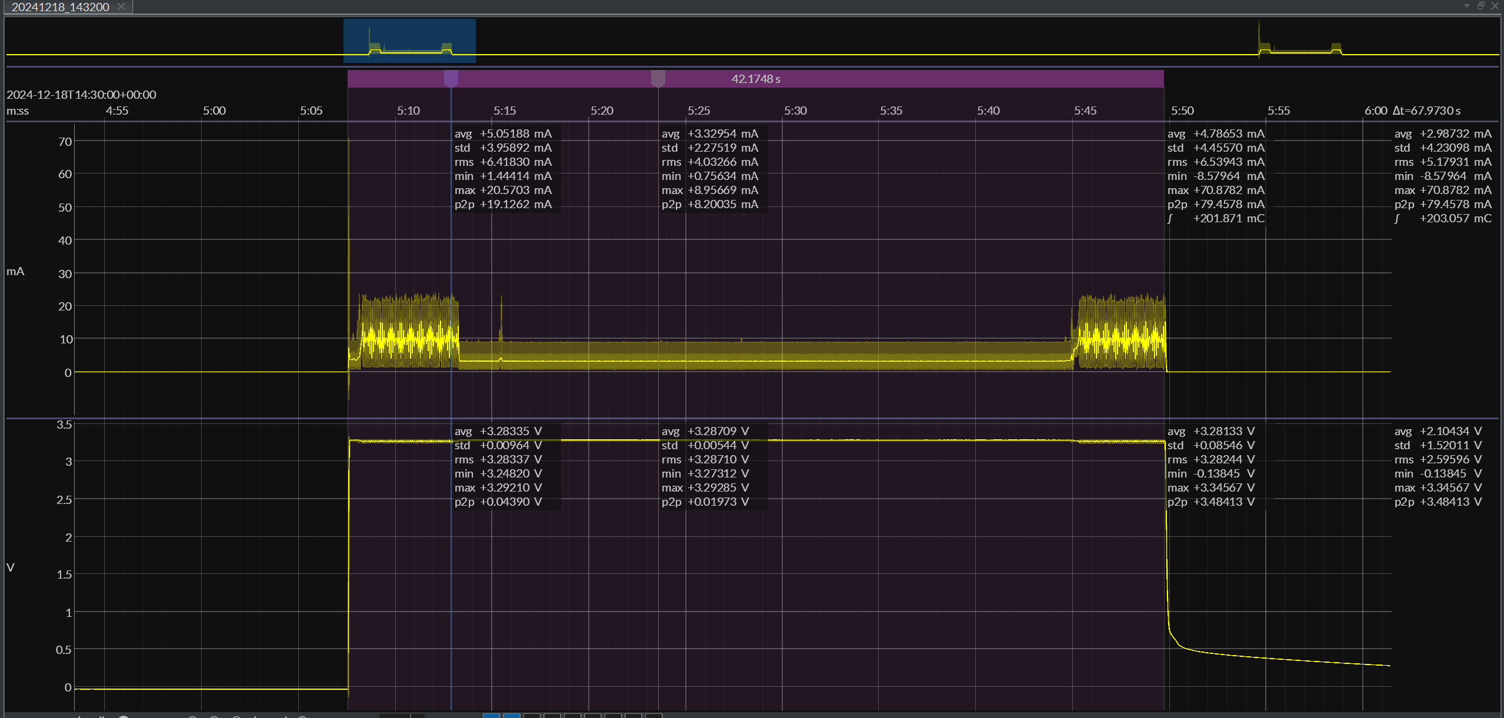
Portfolio/SSR_Portfolio/Images/Power_Profiling/EnergyHarvestingSTMPoweringBLE.png
