RobbeElsermans/SSR/Portfolio/SSR_Portfolio/Images/Power_Profiling/PowerProfileSHT40.png

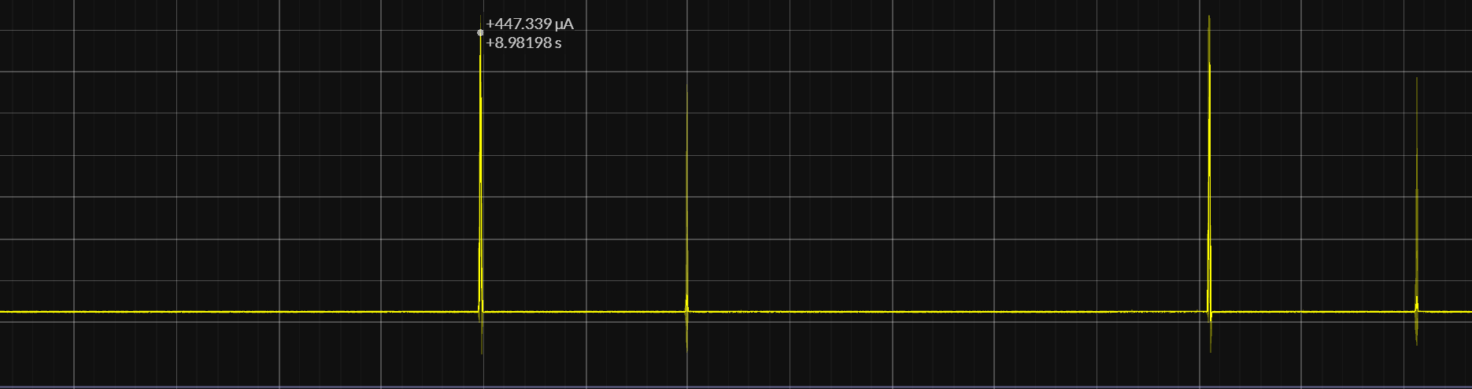
Portfolio/SSR_Portfolio/Images/Power_Profiling/PowerProfileSHT40.png
