RobbeElsermans/SSR/Portfolio/SSR_Portfolio/Images/Sensors/ChargingOfCap.png

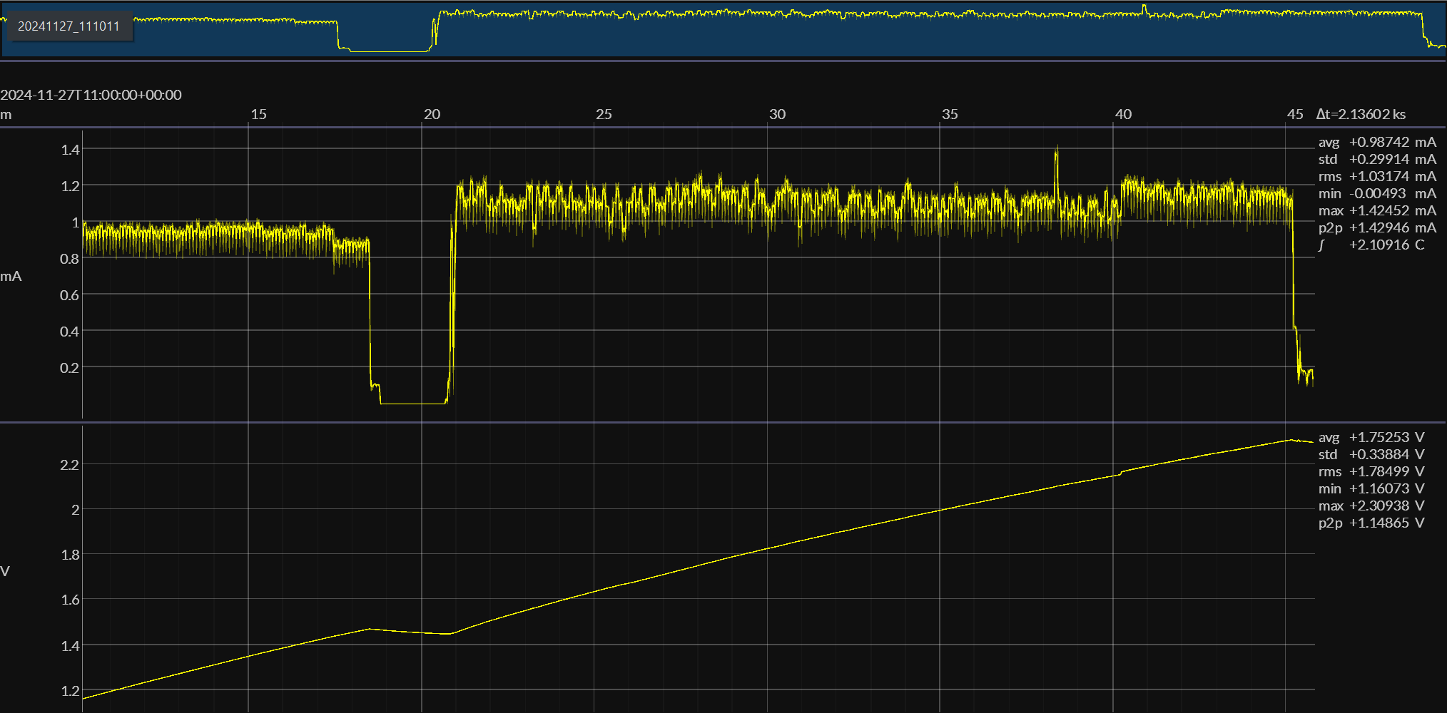
Portfolio/SSR_Portfolio/Images/Sensors/ChargingOfCap.png
