RobbeElsermans/SSR/Portfolio/SSR_Portfolio/Images/Sensors/L412_pinout.png

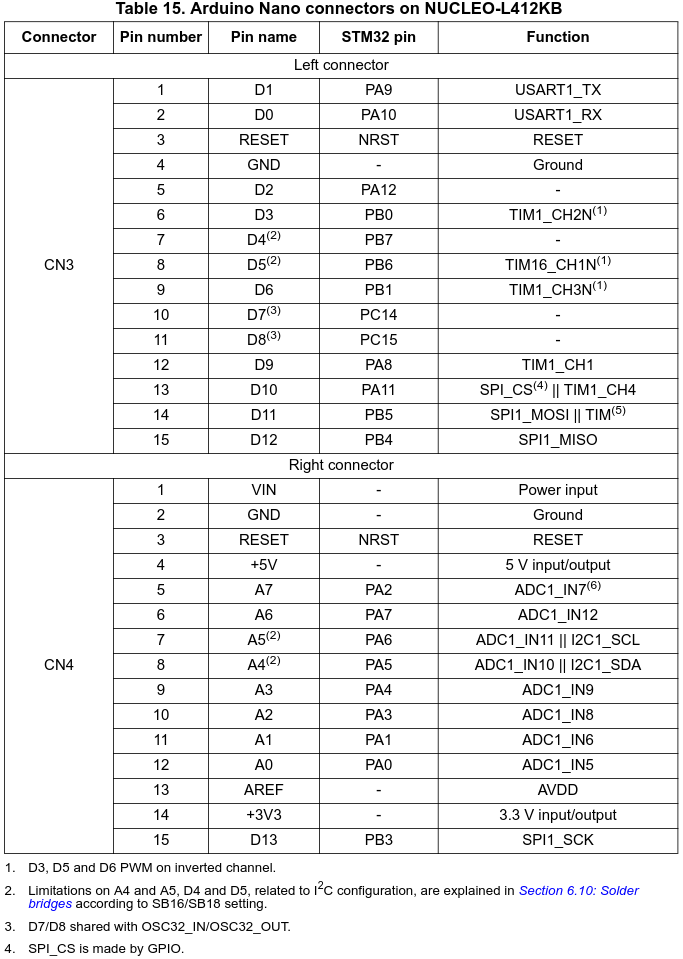
Portfolio/SSR_Portfolio/Images/Sensors/L412_pinout.png
