RobbeElsermans/SSR/Portfolio/SSR_Portfolio/Images/Sensors/StarupSequance.png

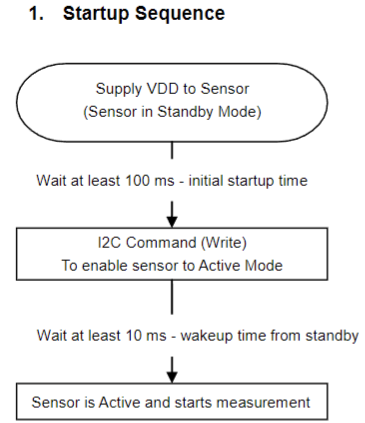
Portfolio/SSR_Portfolio/Images/Sensors/StarupSequance.png
