RobbeElsermans/SSR/Portfolio/SSR_Portfolio/Images/Sensors/StatusChecksSig.png

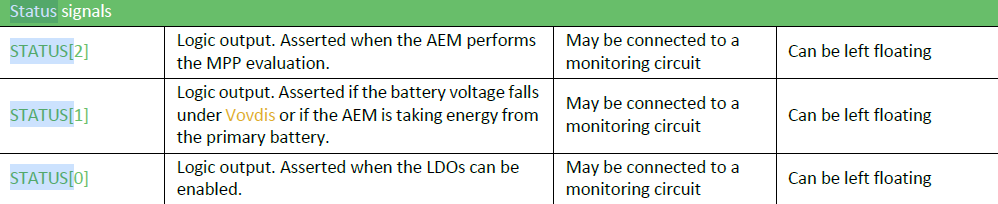
Portfolio/SSR_Portfolio/Images/Sensors/StatusChecksSig.png
