RobbeElsermans/SSR/Portfolio/SSR_Portfolio/Images/Sensors/STMConfigVolReading.png

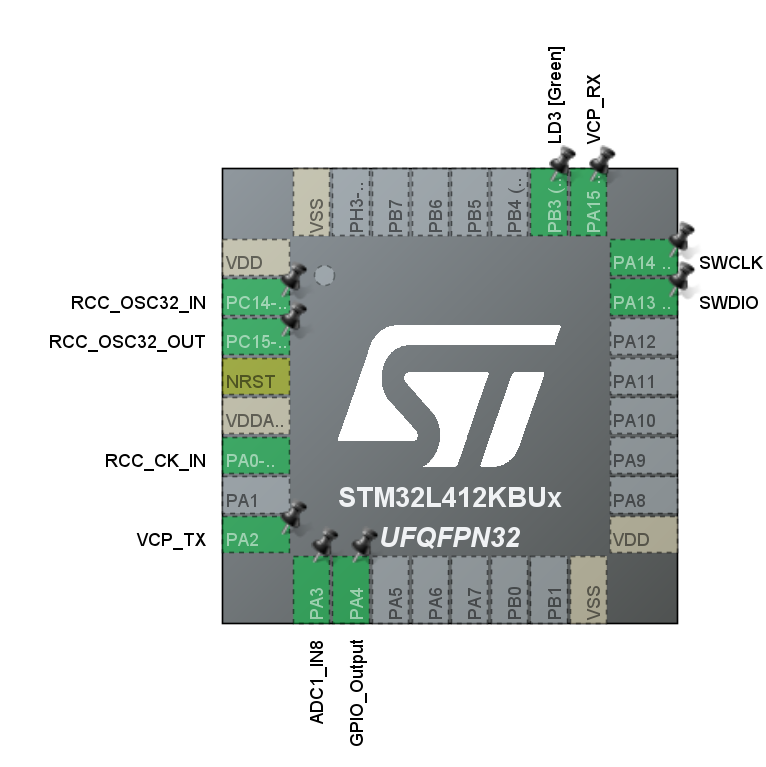
Portfolio/SSR_Portfolio/Images/Sensors/STMConfigVolReading.png
