RobbeElsermans/SSR/Portfolio/SSR_Portfolio/Images/BLE/BLE-program_flow.pdf

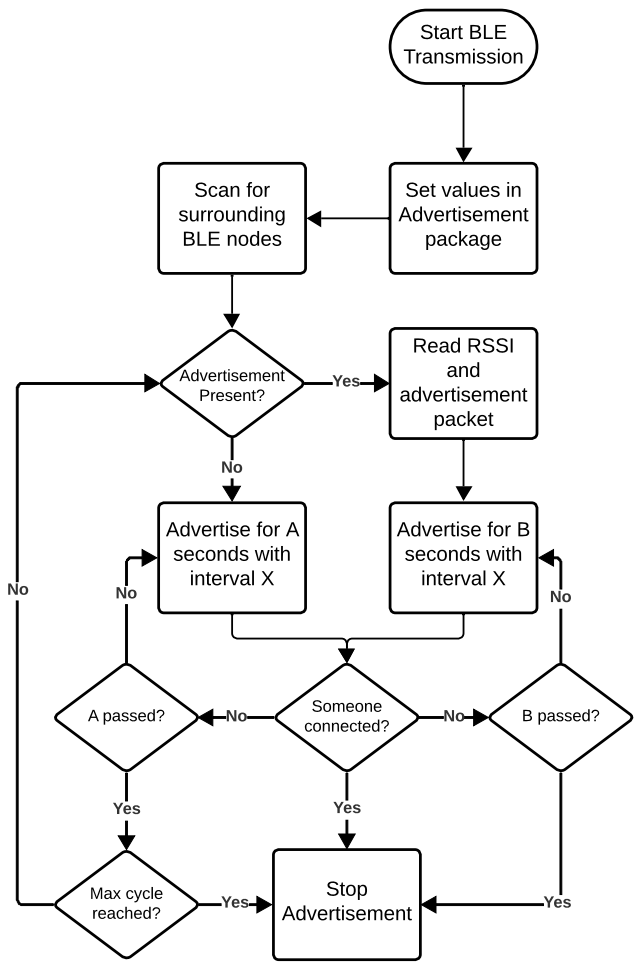
[picture p206: page 1]
Start BLE Transmission; Scan for surrounding BLE nodes; Advertisement Present?; Read RSSI and advertisement packet; Yes; Advertise for A seconds with interval X; Advertise for B seconds with interval X; Someone connected?; Stop Advertisement; B passed?; A passed?; Max cycle; reached?

Set values in
Advertisement
package
