RobbeElsermans/SSR/PCB/SSR_Main_board/SSR_Main_board.kicad_sch

## KiCad design PCB/SSR_Main_board/SSR_Main_board.kicad_sch (2024-12-08)

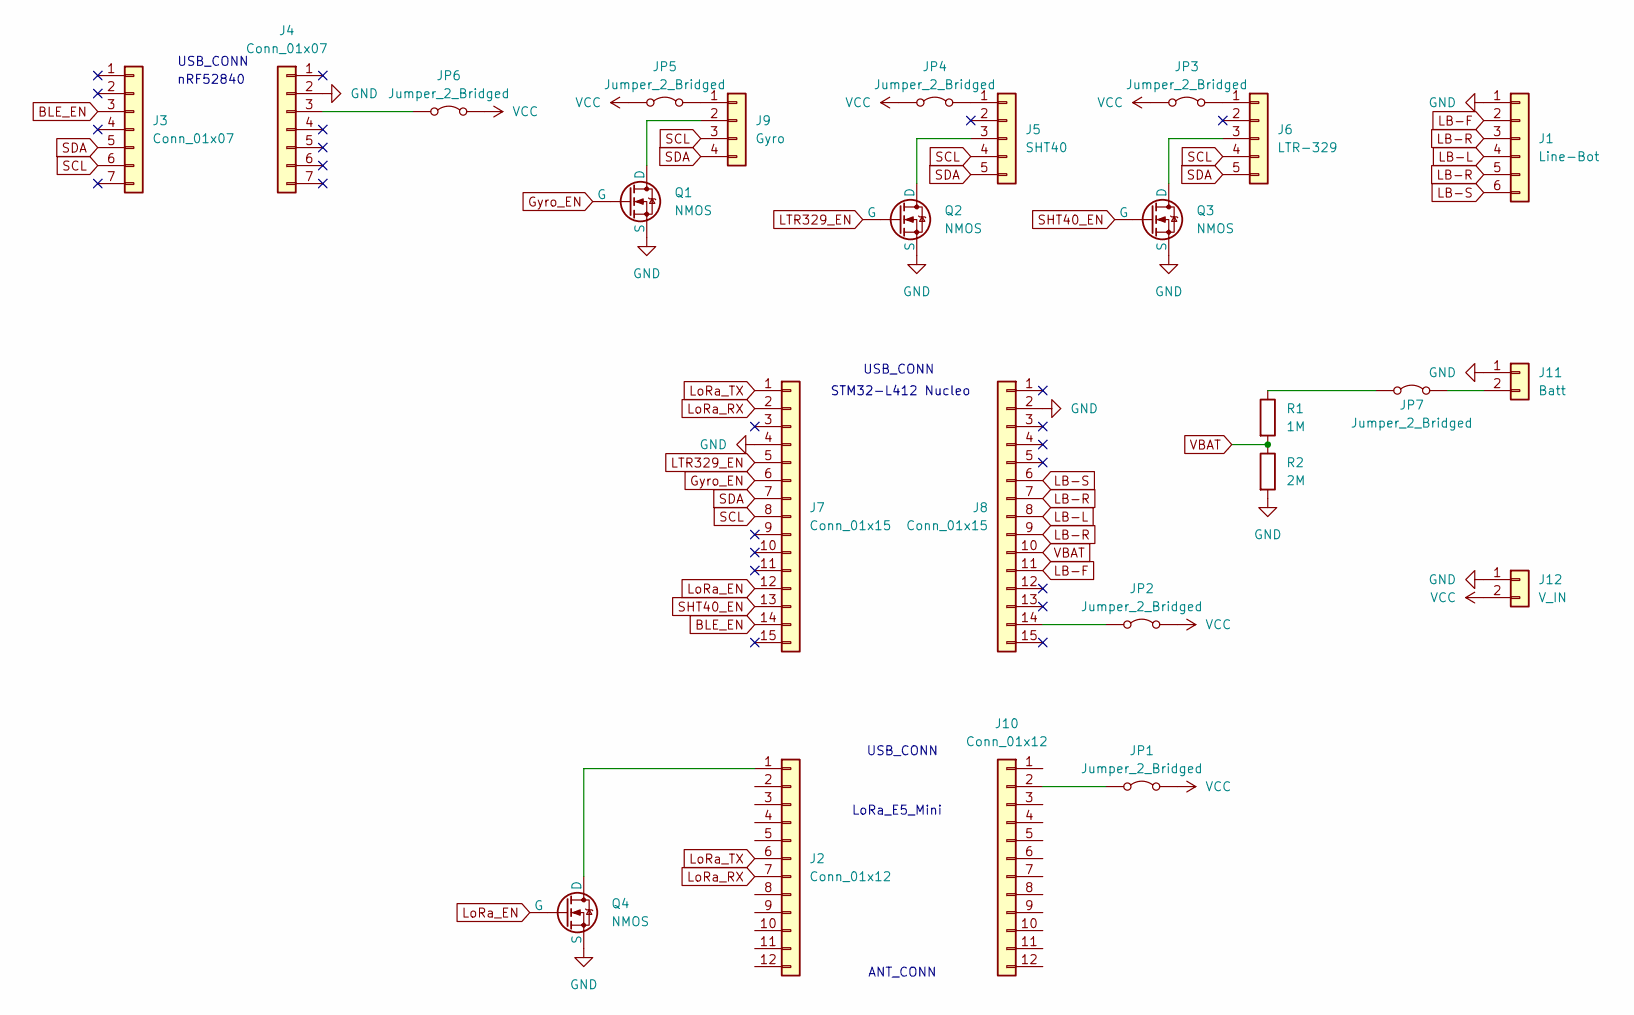
[picture p207: schematic SSR_Main_board.kicad_sch]

Parts:
J1: Line-Bot
J2, J10: Conn_01x12
J3, J4: Conn_01x07
J5: SHT40
J6: LTR-329
J7, J8: Conn_01x15
J9: Gyro
J11: Batt
J12: V_IN
JP1, JP2, JP3, JP4, JP5, JP6, JP7: Jumper_2_Bridged
Q1, Q2, Q3, Q4: NMOS
R1: 1M
R2: 2M

Connections:
BLE_EN: J3.3, J7.14
GND: J1.1, J4.2, J7.4, J8.2, J11.1, J12.1, Q1.3 (S), Q2.3 (S), Q3.3 (S), Q4.3 (S), R2.2
Gyro_EN: J7.6, Q1.2 (G)
LB-F: J1.2, J8.11
LB-L: J1.4, J8.8
LB-R: J1.3, J1.5, J8.7, J8.9
LB-S: J1.6, J8.6
LTR329_EN: J7.5, Q2.2 (G)
LoRa_EN: J7.12, Q4.2 (G)
LoRa_RX: J2.7, J7.2
LoRa_TX: J2.6, J7.1
unnamed: J2.1, Q4.1 (D)
unnamed: J4.3, JP6.1 (A)
unnamed: J5.1, JP4.1 (A)
unnamed: J5.3, Q2.1 (D)
unnamed: J6.1, JP3.1 (A)
unnamed: J6.3, Q3.1 (D)
unnamed: J8.14, JP2.1 (A)
unnamed: J9.1, JP5.1 (A)
unnamed: J9.2, Q1.1 (D)
unnamed: J10.2, JP1.1 (A)
unnamed: J11.2, JP7.1 (A)
unnamed: JP7.2 (B), R1.1
SCL: J3.6, J5.4, J6.4, J7.8, J9.3
SDA: J3.5, J5.5, J6.5, J7.7, J9.4
SHT40_EN: J7.13, Q3.2 (G)
VBAT: J8.10, R1.2, R2.1
VCC: J12.2, JP1.2 (B), JP2.2 (B), JP3.2 (B), JP4.2 (B), JP5.2 (B), JP6.2 (B)

Notes on the sheet:
USB_CONN
STM32-L412 Nucleo
ANT_CONN
nRF52840
LoRa_E5_Mini
