RobbeElsermans/SSR/STM32/PIO_SSR/Src/main.c

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
/* Includes ------------------------------------------------------------------*/
#include "main.h"
#include "adc.h"
#include "i2c.h"
#include "rtc.h"
#include "usart.h"
#include "gpio.h"

/* USER CODE BEGIN Includes */
#include "ble_module.h"
#include "ltr329.h"
#include "sht40.h"
#include "linebot.h"
#include "gyro.h"
#include "wio5e.h"
/* USER CODE END Includes */

/* USER CODE BEGIN PD */

/* Comment when no debug needed */
#define DEBUG

#define SCAN_AIR_TIME 5000
#define BEACON_AIR_TIME 7000
#define SLEEP_TIME 10000
/* USER CODE END PD */


/* USER CODE BEGIN PV */
ble_module_data_t ble_data;
ble_beacon_result_t ble_beacon_result;
ble_scan_result_t ble_scan_result;
ssr_data_t ssr_data[256];
uint8_t ssr_data_index = 0;

uint8_t bool_buffer = 0;

/* UART BUFFER */
uint8_t Buffer[140] = {0};

/* USER CODE END PV */

void SystemClock_Config(void);
/* USER CODE BEGIN PFP */
void clearBuf();
/* USER CODE END PFP */

/**
 * @brief  The application entry point.
 * @retval int
 */
int main(void)
{

  /* MCU Configuration--------------------------------------------------------*/

  /* Reset of all peripherals, Initializes the Flash interface and the Systick. */
  HAL_Init();

  /* USER CODE BEGIN Init */

  /* I2C lib function calls */
  // bleDelayCallback(HAL_Delay);
  bleDelayCallback(half_sleep);
  bleSendCallback(HAL_I2C_Master_Transmit);
  bleReceiveCallback(HAL_I2C_Master_Receive);
  bleAvailableCallback(HAL_I2C_IsDeviceReady);
  bleWakeCallback(wakeBleModule);

  /* ltr-386 lib function calls */
  // ltrDelayCallback(HAL_Delay);
  ltrDelayCallback(half_sleep);
  // ltrWakeCallback(wakeltrModule);
  // ltrSleepCallback(sleepltrModule);

  /* sht40 lob function calls */
  // sht40DelayCallback(HAL_Delay);
  sht40DelayCallback(half_sleep);

  /* LineBot lob function calls */
  // lineBotDelayCallback(HAL_Delay);
  lineBotDelayCallback(half_sleep);

  /* LineBot lob function calls */
  loraDelayCallback(half_sleep);

  /* mpu6050 lob function calls */
  // gyroDelayCallback(HAL_Delay);
  gyroDelayCallback(half_sleep);

  /* USER CODE END Init */

  /* Configure the system clock */
  SystemClock_Config();

  /* USER CODE BEGIN SysInit */

  /* low power clock configuration */
  // lpClockConfigCallback(SystemClock_Config);

  /* USER CODE END SysInit */

  /* Initialize all configured peripherals */
  MX_GPIO_Init();
  MX_I2C1_Init();
  MX_USART2_UART_Init();
  MX_RTC_Init();
  MX_ADC1_Init();
  MX_USART1_UART_Init();
  /* USER CODE BEGIN 2 */
  // HAL_Delay(2000);
  /* USER CODE END 2 */

  /* Infinite loop */
  /* USER CODE BEGIN WHILE */

  while (1)
  {
    ssr_data[ssr_data_index].seq_number = ssr_data_index; // Define sequence number

#ifdef DEBUG
    clearBuf();
    sprintf((char *)Buffer, "\r\n Start on id: %d\r\n", SSR_ID);
    serial_print((char *)Buffer);
#endif

    taskReadBattery(); // Read the ADC voltage

    // Determine path of execution based on voltage (energy) available
    taskDetermineTasks();

    if (checkBool(&bool_buffer, TASK_SENS))
    {
      taskSens();                         // Do the task
      clearBool(&bool_buffer, TASK_SENS); // Clear the bit in bool_buffer
    }

    if (checkBool(&bool_buffer, TASK_STORE))
    {
      taskStore();                         // Do the task
      clearBool(&bool_buffer, TASK_STORE); // Clear the bit in bool_buffer
    }

    if (checkBool(&bool_buffer, TASK_LORA))
    {
      taskLora();                         // Do the task
      clearBool(&bool_buffer, TASK_LORA); // Clear the bit in bool_buffer
    }

    if (checkBool(&bool_buffer, TASK_SCAN))
    {
      taskScan();                         // Do the task
      clearBool(&bool_buffer, TASK_SCAN); // Clear the bit in bool_buffer
    }

    if (checkBool(&bool_buffer, TASK_BEACON))
    {
      half_sleep(2000);                     // Wait a while before starting the BLE up again.
      taskBeacon();                         // Do the task
      clearBool(&bool_buffer, TASK_BEACON); // Clear the bit in bool_buffer
    }

    if (checkBool(&bool_buffer, TASK_DRIVE))
    {
      taskDrive();                         // Do the task
      clearBool(&bool_buffer, TASK_DRIVE); // Clear the bit in bool_buffer
    }

    if (checkBool(&bool_buffer, TASK_DEEP_SLEEP))
    {
      taskDeepSleep();                          // Do the task
      clearBool(&bool_buffer, TASK_DEEP_SLEEP); // Clear the bit in bool_buffer
    }

    if (checkBool(&bool_buffer, TASK_LIGHT_SLEEP))
    {
      taskLightSleep();                          // Do the task
      clearBool(&bool_buffer, TASK_LIGHT_SLEEP); // Clear the bit in bool_buffer
    }

    // Program shouldn't reach this place if deep sleep is used
    /* USER CODE END WHILE */

    /* USER CODE BEGIN 3 */
  }
  /* USER CODE END 3 */
}

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
/* USER CODE BEGIN 4 */

void test_code()
{
  char Buffer[16] = {0};
  sprintf(Buffer, "Test code\r\n");
  serial_print(Buffer);
}

void taskReadBattery()
{
  ssr_data[ssr_data_index].dev_voltage = (readVoltage(&hadc1)) * 10000.0; // Convert to value and save only int

#ifdef DEBUG
  clearBuf();
  sprintf((char *)Buffer, "taskReadBattery - mV: %d \r\n", ssr_data[ssr_data_index].dev_voltage / 10);
  serial_print((char *)Buffer);
#endif
}

void taskDetermineTasks()
{
  // Do this based on the voltage value.
  // For now, we use light sleep due to no non-volatile memory available

  if (ssr_data[ssr_data_index].dev_voltage / 10 > VOLTAGE_MAX_LOW * 1000) // Fully charged
  {
    bool_buffer = 0b10111111; // Do all tasks
  }
  else if (ssr_data[ssr_data_index].dev_voltage / 10 < VOLTAGE_SEM_MAX_HIGH * 1000 && ssr_data[ssr_data_index].dev_voltage / 10 >= (double)VOLTAGE_SEM_MAX_LOW * 1000)
  {
    bool_buffer = 0b10011111; // Do not drive
  }
  else if (ssr_data[ssr_data_index].dev_voltage / 10 < VOLTAGE_MED_HIGH * 1000 && ssr_data[ssr_data_index].dev_voltage / 10 >= (double)VOLTAGE_MED_LOW * 1000)
  {
    bool_buffer = 0b10011011; // Do not do lora & drive
  }
  else if (ssr_data[ssr_data_index].dev_voltage / 10 < VOLTAGE_LOW_HIGH * 1000)
  {
    bool_buffer = 0b10010000; // Only deep sleep and beacon
  }
  else
  {
    bool_buffer = 0b10000000; // Only deep sleep
  }

  // Here, the boolean buffer **bool_buffer** is used with the defines of TASK described in main.h.
  // bool_buffer = 0b010000011; // Set DEEP_SLEEP, STORE, SENS,
  //  bool_buffer = 0b10010001; // Set SLEEP, BEACON, SENS

  // bool_buffer = 0b01001000; // Set DEEP_SLEEP, SCAN, SENS
  // bool_buffer = 0b10011001; // Set SLEEP, BEACON, SCAN, SENS
  //   bool_buffer = 0b10000001; // Set SLEEP, SENS
  //   bool_buffer = 0b10000000; // Set SLEEP

#ifdef DEBUG
  clearBuf();
  sprintf((char *)Buffer, "taskDetermineTasks \r\n sens %d\r\n store %d\r\n lora %d\r\n scan %d\r\n beacon %d\r\n drive %d\r\n deepsleep %d\r\n lightsleep %d\r\n",
          bool_buffer >> 0 & 0x01, bool_buffer >> 1 & 0x01, bool_buffer >> 2 & 0x01, bool_buffer >> 3 & 0x01, bool_buffer >> 4 & 0x01, bool_buffer >> 5 & 0x01, bool_buffer >> 6 & 0x01, bool_buffer >> 7 & 0x01);
  serial_print((char *)Buffer);
#endif
}

void taskSens()
{
  uint16_t lux = 0;
  float temperature = 0;
  float humidity = 0;
  uint16_t gyro_x = 0;
  uint8_t gyro_y = 0;
  uint8_t gyro_z = 0;

  /* Initialize sensors */
  ltr329Init(&hi2c1);
  sht40Init(&hi2c1);
  // setMPU6050();

  /* Read out the sens values */
  ltr329GetLuxAll(&hi2c1, &lux);
  sht40ReadTempAndHumidity(&hi2c1, &temperature, &humidity, 2);
  // readGyroscope(&gyro_x, &gyro_y, &gyro_z);

  /* put to sleep/ halt */
  ltr329Sleep(&hi2c1);
  sht40Sleep(&hi2c1);
  // Sleep MPU

  /* Compose data structure of the environment */
  ssr_data[ssr_data_index].env_humidity = (uint8_t)(humidity);
  ssr_data[ssr_data_index].env_temperature = (uint16_t)(temperature * 100);
  ssr_data[ssr_data_index].env_lux = (uint16_t)(lux);
  ssr_data[ssr_data_index].dev_gyro_x = (uint8_t)gyro_x;
  ssr_data[ssr_data_index].dev_gyro_y = (uint8_t)gyro_y;
  ssr_data[ssr_data_index].dev_gyro_z = (uint8_t)gyro_z;

/* Display onto serial monitor */
#ifdef DEBUG
  clearBuf();
  sprintf((char *)Buffer, "taskSens - lux: %d, t: %d, h: %d, x: %d, y: %d, z: %d \r\n", ssr_data[ssr_data_index].env_lux, ssr_data[ssr_data_index].env_temperature, ssr_data[ssr_data_index].env_humidity, gyro_x, gyro_y, gyro_z);
  serial_print((char *)Buffer);
#endif
}

void taskStore()
{
  // TODO
  // ssr_data_index++; // Increase sequence number
#ifdef DEBUG
  clearBuf();
  sprintf((char *)Buffer, "taskStore - storing index %d\r\n", ssr_data_index);
  serial_print((char *)Buffer);
#endif
}

void taskLora()
{
// TODO
#ifdef DEBUG
  clearBuf();
  sprintf((char *)Buffer, "taskLora - sending out \r\n");
  serial_print((char *)Buffer);
#endif
}

void taskScan()
{
  uint16_t air_time = SCAN_AIR_TIME;

  ble_data.mode = 1;
  ble_data.ssr_id = SSR_ID;
  ble_data.air_time = air_time / 100;

  ble_data.env_temperature = ssr_data[ssr_data_index].env_temperature; // Range from -327.68 to 327.67 °C (val/100=°C)
  ble_data.env_humidity = ssr_data[ssr_data_index].env_humidity;       // Range from -0-100%
  ble_data.env_lux = ssr_data[ssr_data_index].env_lux;                 // Range from 0 to 1000
  ble_data.dev_voltage = ssr_data[ssr_data_index].dev_voltage;         // Range from 0-6.5535V (val/10000=V) (val/10=mV)
  ble_data.dev_gyro_x = ssr_data[ssr_data_index].dev_gyro_x;           // Range from -60 to 60 (val*3=°)
  ble_data.dev_gyro_y = ssr_data[ssr_data_index].dev_gyro_y;           // Range from -60 to 60 (val*3=°)
  ble_data.dev_gyro_z = ssr_data[ssr_data_index].dev_gyro_z;           // Range from -60 to 60 (val*3=°)

#ifdef DEBUG
  clearBuf();
  sprintf((char *)Buffer, "taskScan - start scan %d \r\n", ble_data.air_time);
  serial_print((char *)Buffer);
#endif

  ble_scan_result = scan(&hi2c1, &ble_data);

/* Display onto serial monitor */
#ifdef DEBUG
  clearBuf();
  sprintf((char *)Buffer,
          "taskScan - received ssr_id: %d temp: %d h: %d l: %d x: %d y: %d z: %d vcc: %d rssi: %d\r\n",
          ble_scan_result.ssr_id, ble_scan_result.env_temperature, ble_scan_result.env_humidity, ble_scan_result.env_lux, ble_scan_result.dev_gyro_x, ble_scan_result.dev_gyro_y, ble_scan_result.dev_gyro_z, ble_scan_result.dev_voltage, ble_scan_result.rssi);
  serial_print((char *)Buffer);
#endif
}

void taskBeacon()
{
  uint16_t air_time = BEACON_AIR_TIME; // 10 seconds beacon

#ifdef DEBUG
  clearBuf();
  sprintf((char *)Buffer, "taskBeacon - ssr_data_index %d \r\n", ssr_data_index);
  serial_print((char *)Buffer);
#endif

  ble_data.mode = 0;
  ble_data.ssr_id = SSR_ID;
  ble_data.air_time = air_time / 100;

  ble_data.env_temperature = ssr_data[ssr_data_index].env_temperature; // Range from -327.68 to 327.67 °C (val/100=°C)
  ble_data.env_humidity = ssr_data[ssr_data_index].env_humidity;       // Range from -0-100%
  ble_data.env_lux = ssr_data[ssr_data_index].env_lux;                 // Range from 0 to 1000
  ble_data.dev_voltage = ssr_data[ssr_data_index].dev_voltage;         // Range from 0-6.5535V (val/10000=V) (val/10=mV)
  ble_data.dev_gyro_x = ssr_data[ssr_data_index].dev_gyro_x;           // Range from -60 to 60 (val*3=°)
  ble_data.dev_gyro_y = ssr_data[ssr_data_index].dev_gyro_y;           // Range from -60 to 60 (val*3=°)
  ble_data.dev_gyro_z = ssr_data[ssr_data_index].dev_gyro_z;           // Range from -60 to 60 (val*3=°)

#ifdef DEBUG
  clearBuf();
  sprintf((char *)Buffer, "taskBeacon - start beacon %d \r\n", ble_data.air_time);
  serial_print((char *)Buffer);
#endif

  ble_beacon_result = beacon(&hi2c1, &ble_data);

#ifdef DEBUG
  clearBuf();
  sprintf((char *)Buffer, "taskBeacon received - amount of ACK: %d \r\n", ble_beacon_result.amount_of_ack);
  serial_print((char *)Buffer);
#endif
}

void taskDrive()
{
  
#ifdef DEBUG
  clearBuf();
  sprintf((char *)Buffer, "taskDrive - driving\r\n");
  serial_print((char *)Buffer);
#endif

  setupLineBot();

  DRIVE_STATE drive_state = STOP;

  //Drive around
  //Some task determination that influence the driveing direction

  drive_state = FORWARD; 
  driveLineBot(drive_state);
  half_sleep(1000);

  drive_state = STOP; 
  driveLineBot(drive_state);
  half_sleep(500);

  drive_state = LEFT; 
  driveLineBot(drive_state);
  half_sleep(500);
  
  drive_state = STOP; 
  driveLineBot(drive_state);
}

void taskDeepSleep()
{
#ifdef DEBUG
  clearBuf();
  sprintf((char *)Buffer, "taskDeepSleep - go to deep sleep \r\n");
  serial_print((char *)Buffer);
#endif

  deep_sleep(SLEEP_TIME);
}

void taskLightSleep()
{
#ifdef DEBUG
  clearBuf();
  sprintf((char *)Buffer, "taskLightSleep - go to light sleep \r\n");
  serial_print((char *)Buffer);
#endif

  half_sleep(SLEEP_TIME);
}

void wakeBleModule()
{
  HAL_GPIO_WritePin(BLE_EN_GPIO_Port, BLE_EN_Pin, GPIO_PIN_SET);
  HAL_Delay(100);
  HAL_GPIO_WritePin(BLE_EN_GPIO_Port, BLE_EN_Pin, GPIO_PIN_RESET);
}
void wakeltrModule()
{
  HAL_GPIO_WritePin(LTR329_EN_GPIO_Port, LTR329_EN_Pin, GPIO_PIN_SET);
}
void sleepltrModule()
{
  HAL_GPIO_WritePin(LTR329_EN_GPIO_Port, LTR329_EN_Pin, GPIO_PIN_RESET);
}

uint16_t counter_value(uint16_t time_millis)
{
  uint16_t counter_value = 0xFFFF; //= 0x2806; // 5 seconds
  // Calculate the time
  if (time_millis >= MAX_RTC_COUNTER_VALUE) // Maximum available wait time
    counter_value = 0xFFFF;                 // Set maximum available time
  else
    counter_value = (uint16_t)((time_millis / 1000.0) / 0.000488);

  if (counter_value <= 0x1)
  {
    counter_value = 0x2; // Correspondent to 0.976 ms
  }

  return counter_value;
}

void half_sleep(uint32_t time)
{
  // Determine amounts of replay based on MAX_RTC_COUNTER_VALUE
  uint8_t cycles = 1; // Default 1 cycle

  if (time > MAX_RTC_COUNTER_VALUE)
  {
    cycles = (time / MAX_RTC_COUNTER_VALUE);

    if (MAX_RTC_COUNTER_VALUE * cycles < time)
    {
      cycles++;
    }
  }

  while (cycles > 0)
  {
    // Setup RTC and setup interupt
    //  MX_RTC_Init(); //DOne in main.c
    HAL_SuspendTick();
    HAL_RTCEx_SetWakeUpTimer_IT(&hrtc, counter_value(time), RTC_WAKEUPCLOCK_RTCCLK_DIV16, 0);

    /* Enter STOP 2 mode */
    HAL_PWREx_EnterSTOP2Mode(PWR_STOPENTRY_WFI);
    HAL_RTCEx_DeactivateWakeUpTimer(&hrtc);
    SystemClock_Config();
    HAL_ResumeTick();

    cycles--;
    time -= MAX_RTC_COUNTER_VALUE;
  }
}

void deep_sleep(uint32_t time)
{
  GPIO_Disable();
  HAL_PWREx_EnableSRAM2ContentRetention();
  HAL_PWREx_EnableBORPVD_ULP();
  HAL_RTCEx_DeactivateWakeUpTimer(&hrtc);
  HAL_RTCEx_SetWakeUpTimer_IT(&hrtc, counter_value(time), RTC_WAKEUPCLOCK_RTCCLK_DIV16, 0);
  HAL_PWR_EnterSTANDBYMode();
}

void GPIO_Disable(void)
{
  /* Enable Power Clock */
  __HAL_RCC_PWR_CLK_ENABLE();

  // Set GPIO as analog read so floating.
  GPIO_InitTypeDef GPIO_InitStructure;

  /* Enable GPIOs clock */
  __HAL_RCC_GPIOA_CLK_ENABLE();
  __HAL_RCC_GPIOB_CLK_ENABLE();
  __HAL_RCC_GPIOC_CLK_ENABLE();
  __HAL_RCC_GPIOD_CLK_ENABLE();
  __HAL_RCC_GPIOH_CLK_ENABLE();

  /* Configure all GPIO port pins in Analog Input mode (floating input trigger OFF) */
  /* Note: Debug using ST-Link is not possible during the execution of this   */
  /*       example because communication between ST-link and the device       */
  /*       under test is done through UART. All GPIO pins are disabled (set   */
  /*       to analog input mode) including  UART I/O pins.           */
  GPIO_InitStructure.Pin = GPIO_PIN_All;
  GPIO_InitStructure.Mode = GPIO_MODE_ANALOG;
  GPIO_InitStructure.Pull = GPIO_NOPULL;

  HAL_GPIO_Init(GPIOA, &GPIO_InitStructure);
  HAL_GPIO_Init(GPIOB, &GPIO_InitStructure);
  HAL_GPIO_Init(GPIOC, &GPIO_InitStructure);
  HAL_GPIO_Init(GPIOD, &GPIO_InitStructure);
  HAL_GPIO_Init(GPIOH, &GPIO_InitStructure);

  /* Disable GPIOs clock */
  __HAL_RCC_GPIOA_CLK_DISABLE();
  __HAL_RCC_GPIOB_CLK_DISABLE();
  __HAL_RCC_GPIOC_CLK_DISABLE();
  __HAL_RCC_GPIOD_CLK_DISABLE();
  __HAL_RCC_GPIOH_CLK_DISABLE();
}

void setBool(uint8_t *bool_carrier, uint8_t bool_place)
{
  *bool_carrier |= 0b1 << bool_place;
}

void clearBool(uint8_t *bool_carrier, uint8_t bool_place)
{
  *bool_carrier &= ~(0b1 << bool_place);
}

uint8_t checkBool(uint8_t *bool_carrier, uint8_t bool_place)
{
  return *bool_carrier & (0b1 << bool_place);
}

void clearBuf()
{
  for (uint8_t i = 0; i < sizeof(Buffer); i++)
  {
    Buffer[i] = 0;
  }
}
/* USER CODE END 4 */
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
