RobbeElsermans/SSR/STM32/PIO_SSR/Inc/main.h

#define TASK_SENS 0
#define TASK_STORE 1
#define TASK_LORA 2
#define TASK_SCAN 3
#define TASK_BEACON 4
#define TASK_DRIVE 5
#define TASK_DEEP_SLEEP 6
#define TASK_LIGHT_SLEEP 7
#define SSR_ID 3
#define VOLTAGE_MAX_HIGH 2.72
#define VOLTAGE_MAX_LOW 2.4
#define VOLTAGE_SEM_MAX_HIGH 2.4
#define VOLTAGE_SEM_MAX_LOW 2.2
#define VOLTAGE_MED_HIGH 2.2
#define VOLTAGE_MED_LOW 2.0
#define VOLTAGE_LOW_HIGH 2.0
#define VOLTAGE_LOW_LOW 1.7
#define MAX_RTC_COUNTER_VALUE 31981
#define LB_F_Pin GPIO_PIN_1
#define LB_F_GPIO_Port GPIOA
#define VCP_TX_Pin GPIO_PIN_2
#define VCP_TX_GPIO_Port GPIOA
#define VBAT_Pin GPIO_PIN_3
#define VBAT_GPIO_Port GPIOA
#define LB_B_Pin GPIO_PIN_4
#define LB_B_GPIO_Port GPIOA
#define LB_L_Pin GPIO_PIN_5
#define LB_L_GPIO_Port GPIOA
#define LB_R_Pin GPIO_PIN_6
#define LB_R_GPIO_Port GPIOA
#define LB_S_Pin GPIO_PIN_7
#define LB_S_GPIO_Port GPIOA
#define Gyro_EN_Pin GPIO_PIN_0
#define Gyro_EN_GPIO_Port GPIOB
#define LoRa_EN_Pin GPIO_PIN_8
#define LoRa_EN_GPIO_Port GPIOA
#define LoRa_TX_Pin GPIO_PIN_9
#define LoRa_TX_GPIO_Port GPIOA
#define LoRa_RX_Pin GPIO_PIN_10
#define LoRa_RX_GPIO_Port GPIOA
#define SHT40_EN_Pin GPIO_PIN_11
#define SHT40_EN_GPIO_Port GPIOA
#define LTR329_EN_Pin GPIO_PIN_12
#define LTR329_EN_GPIO_Port GPIOA
#define SWDIO_Pin GPIO_PIN_13
#define SWDIO_GPIO_Port GPIOA
#define SWCLK_Pin GPIO_PIN_14
#define SWCLK_GPIO_Port GPIOA
#define VCP_RX_Pin GPIO_PIN_15
#define VCP_RX_GPIO_Port GPIOA
#define USER_LED_Pin GPIO_PIN_3
#define USER_LED_GPIO_Port GPIOB
#define BLE_EN_Pin GPIO_PIN_5
#define BLE_EN_GPIO_Port GPIOB
