RobbeElsermans/SSR/STM32/stm32L412KBU6 - Working STH40/src/main.c

/**
 ******************************************************************************
 * @file    PWR/PWR_STANDBY_RTC/Src/main.c
 * @author  MCD Application Team
 * @brief   This sample code shows how to use STM32L4xx PWR HAL API to enter
 *          and exit the Standby mode using RTC.
 ******************************************************************************
 * @attention
 *
 * Copyright (c) 2018 STMicroelectronics.
 * All rights reserved.
 *
 * This software is licensed under terms that can be found in the LICENSE file
 * in the root directory of this software component.
 * If no LICENSE file comes with this software, it is provided AS-IS.
 *
 ******************************************************************************
 */

/* Includes ------------------------------------------------------------------*/
#include "main.h"
#include "i2c.h"
#include "usart.h"
#include "gpio.h"
#include "lp.h"

/** @addtogroup STM32L4xx_HAL_Examples
 * @{
 */

/** @addtogroup PWR_STANDBY_RTC
 * @{
 */

/* Private typedef -----------------------------------------------------------*/
/* Private define ------------------------------------------------------------*/

/* Private macro -------------------------------------------------------------*/
/* Private variables ---------------------------------------------------------*/

uint8_t BLE_Counter = 0;
uint8_t buf[10]; // I2C recieve buffer

/* Private function prototypes -----------------------------------------------*/
void SystemClock_Config(void);
void Error_Handler(void);

/* Private functions ---------------------------------------------------------*/

/**
 * @brief  Main program
 * @param  None
 * @retval None
 */
int main(void)
{
    /* STM32L4xx HAL library initialization:
         - Configure the Flash prefetch
         - Systick timer is configured by default as source of time base, but user
           can eventually implement his proper time base source (a general purpose
           timer for example or other time source), keeping in mind that Time base
           duration should be kept 1ms since PPP_TIMEOUT_VALUEs are defined and
           handled in milliseconds basis.
         - Set NVIC Group Priority to 4
         - Low Level Initialization
       */
    HAL_Init();
    /* Configure the system clock to 80 MHz */
    SystemClock_Config();
    // init pheripheral
    MX_GPIO_Init();
    MX_I2C1_Init();
    MX_UART2_UART_Init();
    LTR329_Init(&hi2c1); // Initialize LTR-329 sensor

    /* Configure RTC */
    if (RTC_Config())
    {
        Error_Handler();
    }

    HAL_GPIO_WritePin(LD3_GPIO_Port, LD3_Pin, GPIO_PIN_SET);
    HAL_Delay(1000);
    HAL_GPIO_WritePin(LD3_GPIO_Port, LD3_Pin, GPIO_PIN_RESET);

    /* Check if the system was resumed from StandBy mode */
    if (__HAL_PWR_GET_FLAG(PWR_FLAG_SB) != RESET)
    {
        /* Clear Standby flag */
        __HAL_PWR_CLEAR_FLAG(PWR_FLAG_SB);
    }

    /* Insert 5 seconds delay */
    HAL_Delay(5000);

    /* Enter the Standby mode */
    // if (lowPower_init())
    // {
    //   Error_Handler();
    // }
    // else
    // {
    //   HAL_PWR_EnterSTANDBYMode();
    // }

    /* Program should never reach this point (program restart when exiting from standby mode) */
    // Error_Handler();

    /* Use to find I2C addresses on the bus */
    // uint8_t Buffer[25] = {0};
    // uint8_t Space[] = " - ";
    // uint8_t StartMSG[] = "Starting I2C Scanning: \r\n";
    // uint8_t EndMSG[] = "Done! \r\n\r\n";

    // uint8_t i = 0, ret;
    // HAL_UART_Transmit(&huart2, StartMSG, sizeof(StartMSG), 10000);
    // for (i = 0; i < 128; i++)
    // {
    //   ret = HAL_I2C_IsDeviceReady(&hi2c1, (uint16_t)(i << 1), 3, 5);
    //   if (ret != HAL_OK) /* No ACK Received At That Address */
    //   {
    //     HAL_UART_Transmit(&huart2, Space, sizeof(Space), 10000);
    //   }
    //   else if (ret == HAL_OK)
    //   {
    //     sprintf(Buffer, "0x%X", i);
    //     HAL_UART_Transmit(&huart2, Buffer, sizeof(Buffer), 10000);
    //   }
    // }
    // HAL_UART_Transmit(&huart2, EndMSG, sizeof(EndMSG), 10000);

    // while(1);
    /* Use to find I2C addresses on the bus */
    HAL_StatusTypeDef ret;

    // Communication example with LTR-329
    // Datasheet https://www.mouser.com/ds/2/239/Lite-On_LTR-329ALS-01%20DS_ver1.1-348647.pdf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
    while (1)
    {
        
        HAL_GPIO_WritePin(LD3_GPIO_Port, LD3_Pin, GPIO_PIN_SET);
        HAL_Delay(1000);
        HAL_GPIO_WritePin(LD3_GPIO_Port, LD3_Pin, GPIO_PIN_RESET);
        void SHT40_measure();
        {
            HAL_StatusTypeDef ret;
            uint8_t data_tx[1] = {0xFD};
            uint8_t data_rx[6];
            ret = HAL_I2C_Master_Transmit(&hi2c1, 0x44 << 1, data_tx, 1, 1000);
            if (ret != HAL_OK)
            {
                printf("Error Tx\r\n");
            }
            else
            {
                // read bytes
                HAL_Delay(1000);
                ret = HAL_I2C_Master_Receive(&hi2c1, 0x44 << 1, data_rx, 6, 1000);
                if (ret != HAL_OK)
                {
                    char Buffer[25] = {0};
                    sprintf(Buffer, "Error %d\r\n");
                    HAL_UART_Transmit(&huart2, Buffer, sizeof(Buffer), HAL_MAX_DELAY);
                    HAL_Delay(1000);
                }
                else
                {
                    for (int i = 0; i < 6; i++)
                    {
                        char Buffer[25] = {0};
                        sprintf("data_rx[%i] = %u \n", i, data_rx[i]);
                        HAL_UART_Transmit(&huart2, Buffer, sizeof(Buffer), HAL_MAX_DELAY);
                    }
                    float t_ticks = data_rx[0] * 256 + data_rx[1];
                    float rh_ticks = data_rx[3] * 256 + data_rx[4];

                    int temp = -45 + 175 * t_ticks / 65535;
                    int  hum = -6 + (125.0 * rh_ticks) / 65535.0;
                    uint8_t buffer[6];

                    char Buffer[25] = {0};
                    
                    sprintf(Buffer, "temp: %d, hum :  %d\r\n", temp, hum);
                    HAL_UART_Transmit(&huart2, Buffer, sizeof(Buffer), HAL_MAX_DELAY);
                    HAL_Delay(1000);
                }
            }
             // FINALY ... a correct code... 
            // HAL_GPIO_TogglePin(LD3_GPIO_Port, LD3_Pin);  // Indicate activity

            // if (SHT4x_ReadTempAndHumidity(&hi2c1, &temperature, &humidity) == HAL_OK) {
            //     sprintf(msg, "Temp: %.2f C, Humidity: %.2f %%\r\n", temperature, humidity);
            // } else {
            //     sprintf(msg, "Sensor Read Failed\r\n");
            // }
            // HAL_UART_Transmit(&huart2, (uint8_t *)msg, strlen(msg), HAL_MAX_DELAY);

            // HAL_Delay(1000);
        }
    }
}

/**
 * @brief  System Clock Configuration
 *         The system Clock is configured as follows :
 *            System Clock source            = PLL (MSI)
 *            SYSCLK(Hz)                     = 80000000
 *            HCLK(Hz)                       = 80000000
 *            AHB Prescaler                  = 1
 *            APB1 Prescaler                 = 1
 *            APB2 Prescaler                 = 1
 *            MSI Frequency(Hz)              = 4000000
 *            PLL_M                          = 1
 *            PLL_N                          = 40
 *            PLL_R                          = 2
 *            PLL_Q                          = 4
 *            Flash Latency(WS)              = 4
 * @param  None
 * @retval None
 */
void SystemClock_Config(void)
{
    RCC_ClkInitTypeDef RCC_ClkInitStruct = {0};
    RCC_OscInitTypeDef RCC_OscInitStruct = {0};

    /* MSI is enabled after System reset, activate PLL with MSI as source */
    RCC_OscInitStruct.OscillatorType = RCC_OSCILLATORTYPE_MSI;
    RCC_OscInitStruct.MSIState = RCC_MSI_ON;
    RCC_OscInitStruct.MSIClockRange = RCC_MSIRANGE_6;
    RCC_OscInitStruct.MSICalibrationValue = RCC_MSICALIBRATION_DEFAULT;
    RCC_OscInitStruct.PLL.PLLState = RCC_PLL_ON;
    RCC_OscInitStruct.PLL.PLLSource = RCC_PLLSOURCE_MSI;
    RCC_OscInitStruct.PLL.PLLM = 1;
    RCC_OscInitStruct.PLL.PLLN = 40;
    RCC_OscInitStruct.PLL.PLLR = 2;
    RCC_OscInitStruct.PLL.PLLQ = 4;
    if (HAL_RCC_OscConfig(&RCC_OscInitStruct) != HAL_OK)
    {
        /* Initialization Error */
        while (1)
            ;
    }

    /* Select PLL as system clock source and configure the HCLK, PCLK1 and PCLK2
       clocks dividers */
    RCC_ClkInitStruct.ClockType = (RCC_CLOCKTYPE_SYSCLK | RCC_CLOCKTYPE_HCLK | RCC_CLOCKTYPE_PCLK1 | RCC_CLOCKTYPE_PCLK2);
    RCC_ClkInitStruct.SYSCLKSource = RCC_SYSCLKSOURCE_PLLCLK;
    RCC_ClkInitStruct.AHBCLKDivider = RCC_SYSCLK_DIV1;
    RCC_ClkInitStruct.APB1CLKDivider = RCC_HCLK_DIV1;
    RCC_ClkInitStruct.APB2CLKDivider = RCC_HCLK_DIV1;
    if (HAL_RCC_ClockConfig(&RCC_ClkInitStruct, FLASH_LATENCY_4) != HAL_OK)
    {
        /* Initialization Error */
        while (1)
            ;
    }
}

/**
 * @brief SYSTICK callback
 * @param None
 * @retval None
 */
void HAL_SYSTICK_Callback(void)
{
    HAL_IncTick();
}

/**
 * @brief  This function is executed in case of error occurrence.
 * @param  None
 * @retval None
 */
void Error_Handler(void)
{
    MX_GPIO_Init();
    while (1)
    {
        HAL_GPIO_WritePin(LD3_GPIO_Port, LD3_Pin, GPIO_PIN_SET);
        HAL_Delay(500);
        HAL_GPIO_WritePin(LD3_GPIO_Port, LD3_Pin, GPIO_PIN_RESET);
        HAL_Delay(500);
    }
}

#ifdef USE_FULL_ASSERT
/**
 * @brief  Reports the name of the source file and the source line number
 *         where the assert_param error has occurred.
 * @param  file: pointer to the source file name
 * @param  line: assert_param error line source number
 * @retval None
 */
void assert_failed(uint8_t *file, uint32_t line)
{
    /* User can add his own implementation to report the file name and line number,
       ex: printf("Wrong parameters value: file %s on line %d\r\n", file, line) */

    /* Infinite loop */
    while (1)
    {
    }
}
#endif

/**
 * @}
 */

/**
 * @}
 */
