RobbeElsermans/SSR/seeed/WireMaster_emulate_STM32L4/WireMaster_emulate_STM32L4.ino

#include "Wire.h"

#define I2C_DEV_ADDR 0x12
byte temp = 0;

uint32_t i = 0;

void setup() {
  Serial.begin(115200);
  //Serial.setDebugOutput(true);
  Wire.begin();

  pinMode(13, OUTPUT);
}

void loop() {
  digitalWrite(13, HIGH);
  delay(1000);
  digitalWrite(13, LOW);
  delay(1000);
  

  //Write message to the slave
  Wire.beginTransmission(I2C_DEV_ADDR);
  Wire.write(0);
  Wire.write(0x21);
  Wire.write(100); //10 sec beacon time
  Wire.write(0);
  Wire.write(temp++);
  Wire.write(0);
  Wire.write(0);
  Wire.write(21);
  Wire.write(0);
  Wire.write(22);
  Wire.write(0);
  Wire.write(0);
  Wire.write(0);
  uint8_t error = Wire.endTransmission(true);

  delay(10000 + 3000);

  //Read all scan bytes from the slave
  uint8_t bytesReceived = Wire.requestFrom(I2C_DEV_ADDR, 1);
  Serial.print("requestFrom: ");
  Serial.println(bytesReceived);
  if ((bool)bytesReceived) {  //If received more than zero bytes
    uint8_t temp[bytesReceived];
    Wire.readBytes(temp, bytesReceived);
    //log_print_buf(temp, bytesReceived);
    for(uint8_t i = 0; i < bytesReceived; i++)
    {
      Serial.print(temp[i]);
      Serial.print(" ,");
    }
    Serial.println();
    
  }
  else
  {
  Serial.println("endTransmission");
  }
  delay(1000);
}
