RobbeElsermans/SSR/STM32/PIO_SSR/Src/adc.c

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
/* Includes ------------------------------------------------------------------*/
#include "adc.h"
#include "usart.h"

/* USER CODE BEGIN 0 */
const float base = 0.000805664;
const float division_factor = 2.2;//2.694789758;//1.198011114; //3.3/2.7 ish
/* USER CODE END 0 */

ADC_HandleTypeDef hadc1;

/* ADC1 init function */
void MX_ADC1_Init(void)
{

  ADC_MultiModeTypeDef multimode = {0};
  ADC_ChannelConfTypeDef sConfig = {0};

  /** Common config
  */
  hadc1.Instance = ADC1;
  hadc1.Init.ClockPrescaler = ADC_CLOCK_ASYNC_DIV1;
  hadc1.Init.Resolution = ADC_RESOLUTION_12B;
  hadc1.Init.DataAlign = ADC_DATAALIGN_RIGHT;
  hadc1.Init.ScanConvMode = ADC_SCAN_DISABLE;
  hadc1.Init.EOCSelection = ADC_EOC_SINGLE_CONV;
  hadc1.Init.LowPowerAutoWait = DISABLE;
  hadc1.Init.ContinuousConvMode = DISABLE;
  hadc1.Init.NbrOfConversion = 1;
  hadc1.Init.DiscontinuousConvMode = DISABLE;
  hadc1.Init.ExternalTrigConv = ADC_SOFTWARE_START;
  hadc1.Init.ExternalTrigConvEdge = ADC_EXTERNALTRIGCONVEDGE_NONE;
  hadc1.Init.DMAContinuousRequests = DISABLE;
  hadc1.Init.Overrun = ADC_OVR_DATA_PRESERVED;
  hadc1.Init.OversamplingMode = DISABLE;
  if (HAL_ADC_Init(&hadc1) != HAL_OK)
  {
    Error_Handler();
  }

  /** Configure the ADC multi-mode
  */
  multimode.Mode = ADC_MODE_INDEPENDENT;
  if (HAL_ADCEx_MultiModeConfigChannel(&hadc1, &multimode) != HAL_OK)
  {
    Error_Handler();
  }

  /** Configure Regular Channel
  */
  sConfig.Channel = ADC_CHANNEL_8;
  sConfig.Rank = ADC_REGULAR_RANK_1;
  sConfig.SamplingTime = ADC_SAMPLETIME_2CYCLES_5;
  sConfig.SingleDiff = ADC_SINGLE_ENDED;
  sConfig.OffsetNumber = ADC_OFFSET_NONE;
  sConfig.Offset = 0;
  if (HAL_ADC_ConfigChannel(&hadc1, &sConfig) != HAL_OK)
  {
    Error_Handler();
  }
}

void HAL_ADC_MspInit(ADC_HandleTypeDef* adcHandle)
{

  GPIO_InitTypeDef GPIO_InitStruct = {0};
  if(adcHandle->Instance==ADC1)
  {
    /* ADC1 clock enable */
    __HAL_RCC_ADC_CLK_ENABLE();

    __HAL_RCC_GPIOA_CLK_ENABLE();
    /**ADC1 GPIO Configuration
    PA3     ------> ADC1_IN8
    */
    GPIO_InitStruct.Pin = VBAT_Pin;
    GPIO_InitStruct.Mode = GPIO_MODE_ANALOG_ADC_CONTROL;
    GPIO_InitStruct.Pull = GPIO_NOPULL;
    HAL_GPIO_Init(VBAT_GPIO_Port, &GPIO_InitStruct);

    /* ADC1 interrupt Init */
    HAL_NVIC_SetPriority(ADC1_2_IRQn, 0, 0);
    HAL_NVIC_EnableIRQ(ADC1_2_IRQn);
  }
}

void HAL_ADC_MspDeInit(ADC_HandleTypeDef* adcHandle)
{

  if(adcHandle->Instance==ADC1)
  {
    /* Peripheral clock disable */
    __HAL_RCC_ADC_CLK_DISABLE();

    /**ADC1 GPIO Configuration
    PA3     ------> ADC1_IN8
    */
    HAL_GPIO_DeInit(VBAT_GPIO_Port, VBAT_Pin);

    /* ADC1 interrupt Deinit */
    HAL_NVIC_DisableIRQ(ADC1_2_IRQn);
  }
}

/* USER CODE BEGIN 1 */

float readVoltage(ADC_HandleTypeDef* adcHandle)
{
  uint8_t times = 10;
  uint32_t raw_value = 0;

  for(uint8_t i = 0; i < times; i++)
  {
    HAL_ADC_Start(&hadc1);
    HAL_ADC_PollForConversion(&hadc1, HAL_MAX_DELAY);
    raw_value += (HAL_ADC_GetValue(&hadc1));
  }

  //average measured:
  uint32_t raw_adc_val = raw_value/times;

  //Convert
  // reference / 2^12
  // Voltage divider bridge
  float voltage = (base * (float)raw_adc_val*(division_factor));

  #ifdef DEBUG
  char Buffer[80] = {0};
  sprintf(Buffer, "readVoltage - raw:%ld \r\n", raw_adc_val);
  serial_print(Buffer);
  sprintf(Buffer, "readVoltage - r*b:%f \r\n", raw_adc_val*base);
  serial_print(Buffer);
  #endif

  return voltage;
}

/* USER CODE END 1 */
