RobbeElsermans/SSR/STM32/stm32L412KBU6 (UART LoRa)/include/ldr_329.h

#ifndef _LDR_329_
#define _LDR_329_

#include "main.h"

#define LTR329_I2C_ADDR (0x29 << 1) // I2C address shifted for HAL

#define LTR329_ALS_CONTR 0x80      // ALS control register
#define LTR329_ALS_MEAS_RATE 0x85  // ALS measurement rate register
#define LTR329_ALS_DATA_CH1_0 0x88 // ALS Channel 1 low byte
#define LTR329_ALS_DATA_CH1_1 0x89 // ALS Channel 1 high byte
#define LTR329_ALS_DATA_CH0_0 0x8A // ALS Channel 0 low byte
#define LTR329_ALS_DATA_CH0_1 0x8B // ALS Channel 0 high byte

void LTR329_Init(I2C_HandleTypeDef* hi2c1);
uint16_t LTR329_ReadALS(I2C_HandleTypeDef* hi2c1, uint8_t channel);
uint16_t GetLuxAll(I2C_HandleTypeDef* hi2c1);
uint16_t GetLuxIR(I2C_HandleTypeDef* hi2c1);

#endif
