RobbeElsermans/SSR/STM32/stm32L412KBU6 (UART LoRa)/include/lp.h

#ifndef LP_H
#define LP_H

#include "main.h"
//#include "stdint.h"


#ifdef __cplusplus
extern "C" {
#endif

#define RTC_ASYNCH_PREDIV    0x7F
#define RTC_SYNCH_PREDIV     0x00F9  /* 32 kHz RC/128 - 1 */
#define LED_TOGGLE_DELAY         100

void SystemPower_Config(void);
uint8_t RTC_Config(void);
uint8_t lowPower_init(void);

#ifdef __cplusplus
}
#endif

#endif
