RobbeElsermans/SSR/(commit log)

2024-10-29 Add default code for STM32L412KB
2024-11-05 Add I2C sensor light
2024-11-06 Add research I2C and EEPROM
2024-11-06 Add I2C and split up files
2024-11-06 working i2c
2024-11-06 Connection between BLE and STM32
2024-11-14 Add power consumptions
2024-11-19 Add power profile content
2024-11-19 Add communication between stm32 and BLE module
2024-11-20 Working beacon scan with STM32 and BLE I2C communication
2024-11-20 Clean start STM32 stop mode 2
2024-11-21 playing with ioc and stm2pio generation
    [pyvenv.cfg]
2024-11-26 Add stm32 stop 2 mode
2024-11-27 Working with timer but not rebeaconing
2024-11-27 I2C register sketch
2024-11-30 I2C bidirectional not working properly. to be continues
    [beacon_scan_modes_non_mbed.ino, ble.c, ble.h, central_scan_non_mbed.ino, main.c]
2024-12-01 Add I2C 2-way + beacon_scan code adjustements
2024-12-01 Add example scetch of I2C scan and receive data
2024-12-03 Made LTR.329 fall asleep
    LTR-329 can sleep now
    documented it lightly
    nothing is in serial monitor but STMs LED is on when measuring and off when in sleepmode
2024-12-03 Add BLE control flow
2024-12-04 gyro measurements
2024-12-04 Update STM32 upload fixes platformio
2024-12-04 Add I2C scanner code
2024-12-04 gyro in pio
2024-12-04 Add tryout power-reduction
2024-12-08 Add Schematic
    [SSR_Main_board.kicad_pcb, SSR_Main_board.kicad_sch]
2024-12-08 Add Gyro_EN pin
2024-12-08 mosfet sketch
2024-12-08 gyro library
2024-12-10 Documentation + StmIDE code
    Voltage readings
2024-12-10 Working sensors
2024-12-10 full gyro library
2024-12-10 serial print
2024-12-11 Add ADC
2024-12-11 Document - power profiling LTR329
    update
2024-12-11 Add Gyro lib
2024-12-11 PowerProfile of STM32 standbymode
    yee
2024-12-16 power sketch
2024-12-18 fix deep_sleep i2c communication
    [beacon_scan_modes_non_mbed.ino, main.c]
2024-12-27 Add final prototype picture
2024-12-30 Remove old power profile page
2024-12-30 Rename power profile page
2024-12-30 uart settings documentation
